chabodmasere/EGH490-Research-Project/EGH490-1 DATA/README.md

# EGH490 — Research Project 2  
**Honours Research Project**  
Queensland University of Technology (QUT)  
Supervised by Dr Jacob Coetzee  

---

## Overview

This repository contains the research, analysis, modelling, and documentation developed for **EGH490-2 Research Project 2**, completed in partial fulfilment of the requirements for the Bachelor of Engineering (Honours).

The project extends the foundations established in EGH490-1 and advances the analytical depth, modelling precision, and technical validation of the proposed system.

The work reflects a complete engineering research cycle:

- Problem formulation  
- Literature review  
- Analytical modelling  
- Numerical simulation  
- Design iteration  
- Validation and verification  
- Final report preparation  

---

## Research Focus

The project investigates the design and analysis of a waveguide slot array antenna, with emphasis on:

- Electromagnetic field behaviour within rectangular waveguides  
- Slot positioning and excitation characteristics  
- Array synthesis and radiation pattern optimisation  
- Gain, directivity, and efficiency analysis  
- Structural feasibility and manufacturing considerations  

---

## Repository Structure

/report          → Final submitted report (PDF and LaTeX source)  
/analysis        → Mathematical derivations and theoretical modelling  
/simulations     → Electromagnetic simulation files and results  
/design          → CAD models and mechanical drawings  
/figures         → Generated plots and technical diagrams  
/literature      → Key references and annotated notes  
/raw-research    → Working documents and intermediate drafts  

---

## Technical Scope

The repository includes:

- Waveguide mode analysis  
- Slot coupling theory  
- Array factor derivation  
- Radiation pattern modelling  
- Impedance considerations  
- Numerical validation against analytical predictions  

All modelling assumptions and boundary conditions are documented where applicable.

---

## Methodology

The research follows a structured engineering approach:

1. Analytical derivation of waveguide field distributions  
2. Application of array theory for radiation synthesis  
3. Numerical simulation and parameter optimisation  
4. Structural evaluation for manufacturability  
5. Performance validation against theoretical expectations  

---

## Academic Context

Unit: EGH490-2 Research Project 2  
Institution: Queensland University of Technology  
Supervisor: Dr Jacob Coetzee  

This repository contains both final deliverables and supporting research material generated during the course of the project.
