chabodmasere/EGH490-Research-Project/Honours_Submission.pdf

## Investigation into the Effectiveness of Arrays of Slots Radiating through Truncated Waveguides to Combat the Formation of Second-Order Lobes

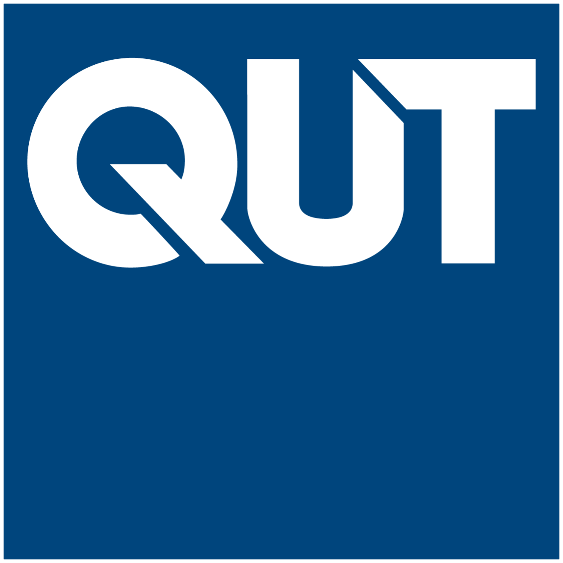
[picture p15: figure]

## EGH490 FINAL DELIVERY

Submitted to the

## School of Electrical Engineering & Robotics

Queensland University of Technology

For the degree of

## BACHELOR OF ENGINEERING

in

## ELECTRICAL & AEROSPACE

Submitted by

# Chabod Masere

Supervised by

## Dr Jacob Coetzee

May 2026

## Acknowledgements

I would like to express my sincere gratitude to my supervisor, Dr Jacob Coetzee, for his guidance, technical insight, and support throughout this research project. His direction helped shape the development of this work, from the early single-slot modelling stage through to the final truncated slotted waveguide array implementation.

I also acknowledge the School of Electrical Engineering and Robotics at Queensland University of Technology for providing the academic environment, software access, and technical resources required to complete this project. The use of CST Studio Suite and related engineering tools was essential to the simulation, modelling, and analysis carried out in this research.

Finally, I would like to thank my family, peers, and colleagues for their encouragement throughout this project. Their support was valuable during the challenges of simulation, design refinement, prototyping, and report preparation.

Chabod Masere

## Investigation into the Effectiveness of Arrays of Slots Radiating through Truncated Waveguides to Combat the Formation of Second-Order Lobes

Chabod Masere¹

1School of Electrical Engineering and Robotics, QUT

Abstract– This research investigates the effectiveness of truncated slotted waveguide arrays for suppressing unwanted second-order lobes in the far-field radiation pattern. A single-slot CST model was first developed and evaluated using a 23 × 21 parametric sweep over cavity-slot offset and cavity-slot length, producing 483 simulation cases. The extracted response was then used to generate a truncated 6 × 6 slotted waveguide array with controlled, non-uniform slot geometry. A target sidelobe level of −25 dB was set. The final CST model achieved a sidelobe level of approximately −23.2 dB at 9 GHz, with the main lobe directed at ϕ = 90◦
and a 3 dB angular width of 14.2

◦
. Although the result remained 1.8 dB above the target, it demonstrated meaningful sidelobe suppression and validated the proposed approach as a preliminary optimisation method for truncated slotted waveguide arrays.

Index Terms– Slotted waveguide arrays; truncated waveguides; second-order lobe suppression; sidelobe reduction; far-field directivity; slot admittance; aperture excitation; antenna array design.

## I. INTRODUCTION

T

he formation of second-order lobes is a significant challenge in the design of slotted waveguide arrays, particularly in applications requiring high directivity, efficient aperture radiation, and controlled far-field behaviour. Slotted waveguide array antennas are widely used in radar, communication, and remotesensing systems because they offer high gain, low transmission loss, strong power-handling capability, and mechanically robust aperture structures [3,4]. In these antennas, electromagnetic energy propagates through the waveguide and is radiated through a sequence of carefully positioned slots. The location, length, offset, and excitation of these slots determine how the radiated fields combine in the far field.

Ideally, the slot contributions combine constructively in the desired main-beam direction while remaining suppressed elsewhere. However, unwanted spatial harmonics can arise when the slot spacing, excitation phase, or guided-wave propagation characteristics are not adequately controlled. These harmonics may produce secondary radiation maxima away from the main beam, referred to in this work as second-order lobes. Their presence degrades radiation-pattern quality by redistributing radiated power away from the intended direction and increasing off-axis radiation. This behaviour is related to the broader arrayantenna problem of unwanted spatial radiation modes, where periodic spacing and phase progression can generate additional lobes within the visible region of the radiation pattern [5].

The problem becomes more difficult in truncated slotted waveguide arrays because the finite aperture length and limited number of radiating elements introduce edge effects and modify the aperture-field distribution. These effects can increase sidelobe and higher-order lobe levels if the slot geometry, slot offset, slot spacing, and excitation distribution are not carefully controlled. For radar and aerospace communication systems, this can reduce directivity, aperture efficiency, angular discrimination, and directional signal reliability [6, 7].

This research investigates the use of truncated waveguide slot geometry as a method for suppressing second-order lobes in a slotted waveguide array. The work focuses on controlling the cavity-slot offset and cavity-slot length through single-slot self-admittance analysis, spline-based array synthesis, and full 6 × 6 CST verification. The aim is to reduce unwanted secondary radiation while preserving a dominant main beam and maintaining practical waveguide-array performance.

Honours Research Project | Semester 1, 2026 | © QUT | 2

## II. SECOND-ORDER LOBES

Before discussing second-order lobes directly, it is useful to define the main features of an antenna radiation pattern. As shown in Fig. 1, the main lobe is the dominant radiation region and represents the intended direction of maximum radiated power. The beamwidth describes the angular spread of this main beam, commonly measured between the half-power points. Side lobes are smaller radiation maxima that occur away from the main lobe, while nulls are angular regions where the radiated field is strongly reduced [1, 2].

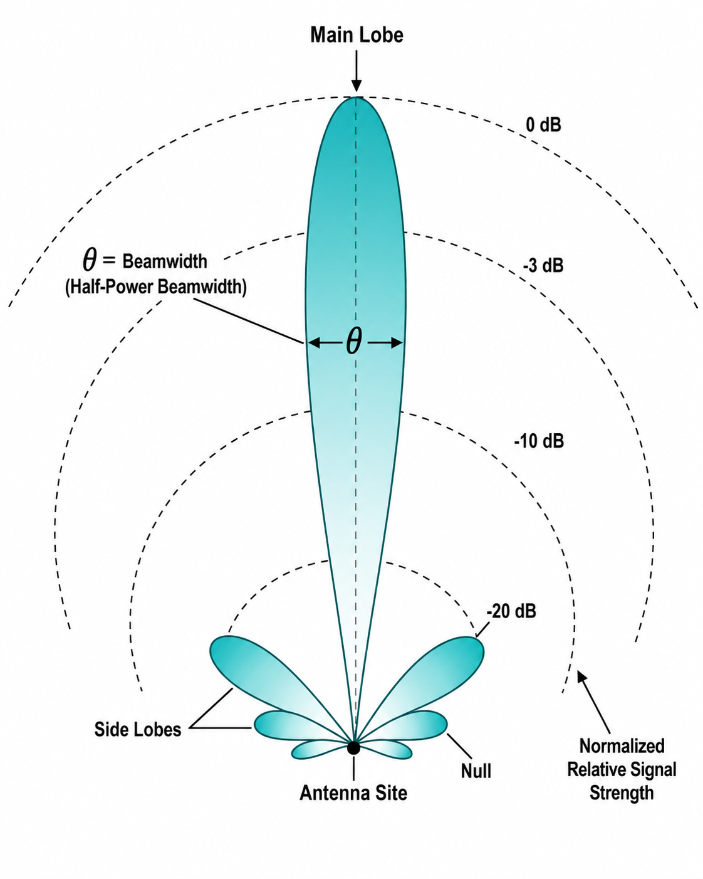
[picture p16: figure]

Figure 1. General antenna radiation-pattern terminology showing the main lobe, beamwidth, side lobes, and nulls. These features provide the basis for interpreting unwanted second-order lobes in slotted waveguide arrays.

Second-order lobes are unwanted secondary radiation maxima that appear away from the intended main beam of an antenna array. In slotted waveguide arrays, these lobes can form when the slot spacing, guided-wave phase progression, or aperture excitation distribution permits higher-order spatial harmonics to radiate. Although the main beam carries the desired radiated energy, second-order lobes redirect part of the radiated power into unintended angular regions. This reduces pattern cleanliness and can degrade directivity, gain, aperture efficiency, and radiation control [3, 4].

From an antenna-design perspective, the presence of second-order lobes is undesirable because the array no longer radiates predominantly in the intended direction. Instead, part of the energy is distributed into off-axis lobes, which can produce false angular responses, increase interference, and reduce the effectiveness of the radiating aperture. In array antennas, unwanted lobes are closely related to the spatial sampling of the aperture, the element spacing, and the phase progression across the array [1,5]. In applications such as radar, wireless communications, telemetry, and electronic warfare, unwanted radiation maxima can compromise system performance because energy is transmitted or received in directions outside the intended coverage region [2, 6].

The second-order lobe problem is illustrated in Fig. 2 and Fig. 3. In Fig. 2, the radiation surface contains a dominant main beam together with multiple irregular off-axis lobes distributed across the visible region. This type of pattern shows how a poorly controlled aperture response can scatter energy into several unintended directions. The surrounding lobes are not part of the desired main-beam radiation and therefore represent unwanted radiation components.

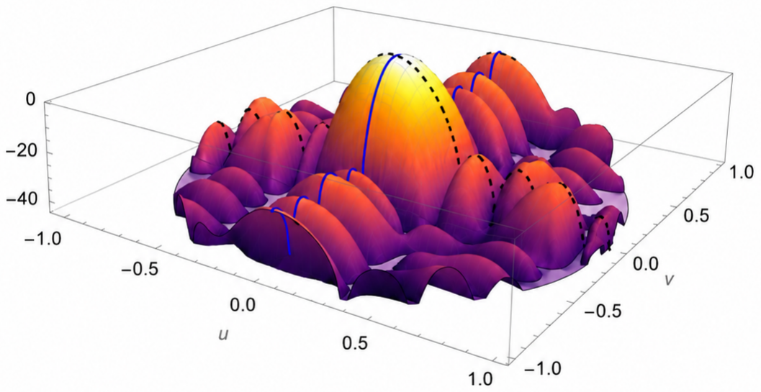
[picture p17: figure]

Figure 2. Illustrative three-dimensional radiation pattern showing a dominant main beam accompanied by multiple irregular off-axis lobes; secondary radiation maxima can distribute energy into unintended directions.

Figure 3 shows a more regular lobe structure. In this case, the main beam remains dominant, but repeated secondary maxima are visible around the main radiation region. These repeated lobes indicate that the array is radiating through additional angular channels instead of concentrating energy only into the intended beam. Even when these lobes are lower than the main beam, they are still undesirable because they reduce the usable radiation efficiency of the aperture and can contribute to interference or false directional responses [1, 5].

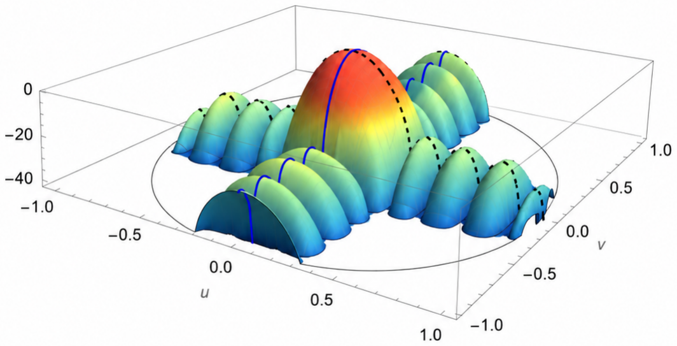
[picture p18: figure]

Figure 3. Illustrative three-dimensional radiation pattern showing a dominant main beam with a more regular secondary-lobe structure. Although the main beam remains strongest, repeated off-axis lobes are still present and represent unwanted radiation.

The key design objective is therefore not only to maintain a strong main beam, but also to reduce the strength of the surrounding second-order lobes. In a slotted waveguide array, this can be approached by controlling the slot geometry across the aperture rather than using a purely uniform slot arrangement. By varying the slot offset and slot length, the local coupling strength and phase contribution of each radiating element can be adjusted. This allows the aperture excitation to be shaped more deliberately, which provides a basis for reducing unwanted lobe formation [4, 7].

In this research, the second-order lobe problem is addressed using a truncated-waveguide slot array. The single-slot model is first analysed to determine how the cavity-slot offset, x

cav, and cavity-slot length, L

cav, influence the local radiating behaviour. The extracted self-admittance data are then used as a lookup basis for generating the full 6 × 6 array. Through spline interpolation and centreline mapping, each slot is assigned an element-specific offset and length. This process enables a controlled, non-uniform slot distribution intended to suppress unwanted second-order lobes while preserving the dominant main beam.

## III. INITIAL SINGLE-SLOT WAVEGUIDE MODEL

The first stage of the research used the CST Studio Suite as the full-wave electromagnetic simulation platform. CST was used to construct the waveguide geometry, assign material regions, define the cavity and slot parameters, configure the waveguide excitation, simulate the electromagnetic field behaviour, and extract the far-field radiation patterns. This provided a consistent environment for studying how the waveguide and slot geometry influenced side-lobe behaviour and second-order lobe formation.

The study began with a simplified single-slot rectangular waveguide model, then progressed to the final truncated 6 × 6 slotted waveguide array. The single-slot model was used to examine the radiation behaviour of an individual slot under controlled conditions before introducing array-level effects such as repeated slot placement, aperture truncation, mutual coupling, and higher-order lobe formation. This stage included the baseline waveguide, truncated cavity, cavity slot, vacuum assignment, curve refinement, and waveguide excitations at both ends of the model.

a. Design Parameters
The operating frequency was set to 9 GHz, which lies within the X-band. This frequency was used to define the electromagnetic length scales of the single-slot waveguide model. The corresponding free-space wavelength was calculated as

λ0 =

c
f
, | (1)

where c = 3.00×10⁸ m/s and f = 9.00×10⁹ Hz. Substituting these values gives

λ0 =

3.00 × 10⁸
9.00 × 10⁹

= 0.03333 m = 33.33 mm. (2)

However, because the field propagates inside a rectangular waveguide, the guided wavelength of the dominant TE10 mode was used as the main longitudinal design reference. In CST, this was defined as

λ10 =

1000
f

0.2997924582
−

500
a

2

1/2

, (3)

where f is entered in GHz and the broad-wall waveguide dimension a is entered in millimetres. For f = 9 GHz and a = 22.86 mm,

λ10 =

1000
h
9

0.299792458 2
−

500

22.86 2

i1/2

= 48.63 mm.

(4)
The initial waveguide length was therefore set equal to the guided wavelength:
ℓ = λ10 = 48.63 mm. | (5)

The wave impedance parameter used in the CST model was calculated from

Zwave = f(1.256637)λ10. | (6)
Zwave = 9(1.256637)(48.63) = 550.0 Ω. | (7)

The analytical CST parameters used to define the model are summarised in Table 1, while the corresponding physical geometry dimensions are listed in Table 2.
b. Waveguide Overview
The single-slot model was constructed as a rectangular waveguide section with a central radiating slot and truncated cavity region. The physical waveguide body had an overall length of 48.63 mm, width of 45.72 mm, and height of 17.70 mm. The feeding mouth retained the standard rectangular waveguide aperture dimensions of 22.86 mm×10.16 mm, corresponding to the broad-wall and narrow-wall dimensions of the X-band waveguide.

A truncated cavity was positioned above the waveguide wall to control the local slot-cavity coupling behaviour. This cavity had a length of 18 mm, width of 12 mm, and depth of 5 mm. The cavity slot was defined with a length of 16 mm, width of 1.588 mm, and depth of 1.27 mm, matching the wall thickness of the waveguide. These physical dimensions are listed in Table 2.

Table 1

CST parameters used for the initial

single-slot rectangular waveguide model.

Parameter | Symbol | Value
Operating frequency | f | 9.0 GHz
Waveguide width | a | 22.86 mm
Waveguide height | b | 10.16 mm
Wall thickness | t | 1.27 mm
Slot width | w | 1.5875 mm
Side length | side | 22.86 mm
Guide wavelength | λ10 | 48.6303 mm
Waveguide length | ℓ | 48.6303 mm
Slot displacement | δ | 0 mm
Adjusted length | ℓδ | 48.6303 mm
Overall model width | width | 45.72 mm
Wave impedance | Zwave | 549.995 Ω
Cavity width | acavity | 12 mm
Cavity height | bcavity | 5 mm
Cavity depth | dcavity | 18 mm
Cavity slot length | Lcav | 16 mm
Cavity slot offset | Xcav | 2 mm

Table 2

Physical geometry dimensions of the

single-slot CST model.

Parameter | Symbol | Value
Physical waveguide length | Lwg | 48.63 mm
Physical waveguide width | Wwg | 45.72 mm
Physical waveguide height | Hwg | 17.70 mm
Feeding mouth length | Lfeed | 22.86 mm
Feeding mouth width | Wfeed | 10.16 mm
Truncated cavity length | Ltcav | 18 mm
Truncated cavity width | Wtcav | 12 mm
Truncated cavity depth | Dtcav | 5 mm
Cavity slot length | Lslot | 16 mm
Cavity slot width | Wslot | 1.588 mm
Cavity slot depth | Dslot | 1.27 mm

The baseline CST single-slot model is shown in Fig. 4. This model consisted of a rectangular waveguide section containing one cavity-backed radiating slot. The broad-wall dimension a and narrow-wall dimension b defined the internal waveguide cross-section, while the wall thickness t defined the metallic boundary. The slot width w, cavity slot length Lcav, and cavity slot offset Xcav defined the initial radiating aperture geometry.

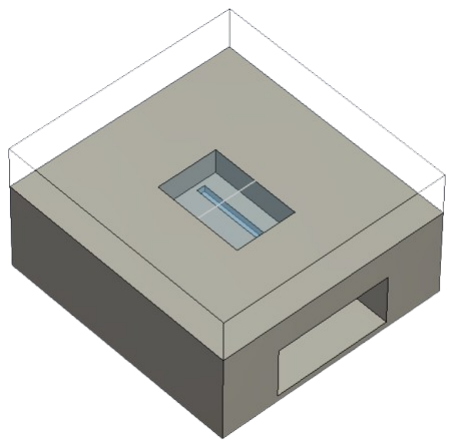
[picture p19: figure]

Figure 4. CST model of the initial single-slot rectangular waveguide geometry used as the baseline configuration before development of the truncated 6 × 6 slotted waveguide array.

c. Vacuum Region Assignment
The truncated region in the single-slot model was assigned as a vacuum in CST, as shown in Fig. 5. This was necessary because the cavity represents the internal electromagnetic volume through which the guided wave interacts with the slot aperture. If this region were treated as metal, the slot would not support the intended field penetration or radiation mechanism. By treating the cavity as a vacuum, the model approximated an air-filled slot cavity, allowing electromagnetic fields to occupy the cavity volume, couple through the aperture, and radiate from the waveguide structure.

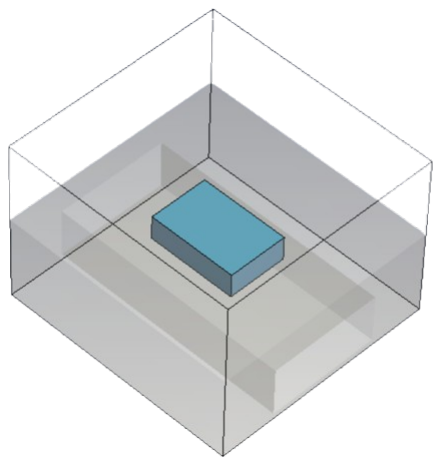
[picture p20: figure]

Figure 5. CST model showing the cavity region assigned as vacuum within the initial single-slot waveguide geometry. The vacuum assignment allowed electromagnetic fields to occupy the cavity volume and couple through the slot aperture during simulation.

d. Curve References
The slot and cavity geometry were defined using two reference curves, as shown in Fig. 6. Curve 1 and Curve 2 represent the slot-side and cavity-side boundaries of the single-slot structure. To examine the local coupling behaviour, the x-component of the electric field, Ex, was evaluated along both curves at f = 9 GHz.
Since the CST field result is complex in the frequency domain, both the real and imaginary components of Ex were extracted. The curve result was interpreted as the line-integrated electric-field response,

IEx =

Z

C

Ex dl, | (8)

where IEx

represents the accumulated electric-field excitation along the selected curve. This provided a compact measure of the relative field strength and phase behaviour between the slot and cavity regions.

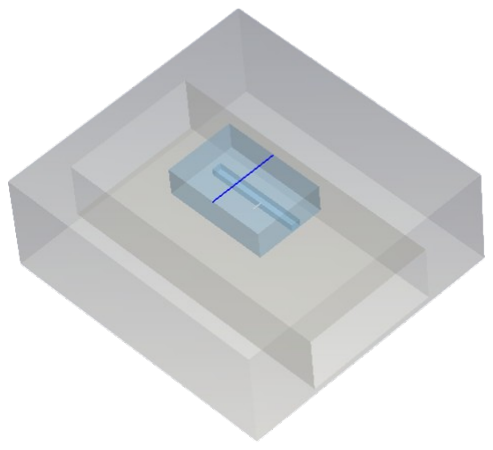
[picture p21: figure]

Figure 6. CST geometry showing Curve 1 and Curve 2 used for single-slot field evaluation. The x-component of the electric field, Ex, was evaluated along both curves at f = 9 GHz.

This analysis was used to assess how effectively the cavity region couples energy into the radiating slot aperture. Poorly controlled slot-cavity coupling can produce uneven aperture excitation, which may contribute to increased sidelobe levels when extended to the full 6 × 6 array. The curve-based field evaluation therefore provided a baseline measure of the local radiation mechanism before the design was implemented at array scale.

e. Port Excitation Setup
Waveguide ports were assigned at both ends of the single-slot model to excite the dominant guided mode through the rectangular waveguide. Each port was referenced from its respective end face and extended inward toward the centre of the structure. In CST, this was implemented using an inward extent of −ℓ/2, where ℓ is the total waveguide length. Since the initial waveguide length was defined as ℓ = λ10, each port used an inward extent of −λ10/2. This kept the slot region centred while allowing the guided excitation to enter from the waveguide end faces.

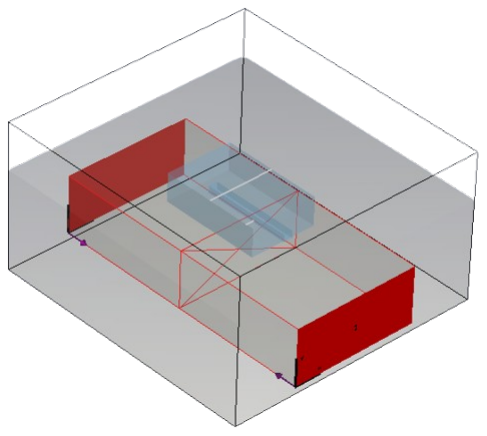
[picture p22: figure]

Figure 7. Waveguide port-pin placement used in the CST single-slot model. Each port was defined with an inward extent of −ℓ/2 from its respective end face.

This port arrangement ensured that the slot was excited by the propagating waveguide mode rather than by a direct aperture excitation. This better represents the excitation condition used later in the full slotted waveguide array.

f. Parametric Sweep Definition
A parametric sweep was conducted to evaluate how the cavity-slot offset and cavity-slot length affected the single-slot electromagnetic response. Two geometric variables were swept: the cavity-slot offset, Xcav, and the cavity-slot length, Lcav. These parameters were selected because they directly influence the slot-cavity coupling strength, aperture excitation, and radiation behaviour.
The offset Xcav was varied from 0.6 mm to 5.0 mm in increments of 0.2 mm, giving 23 offset values. The cavity-slot length Lcav was varied from 15.0 mm to 17.0 mm in increments of 0.1 mm, giving 21 length values. The full sweep therefore produced
Nsweep = 23 × 21 = 483 | (9)

individual simulation cases.

Table 3

Parametric sweep ranges used for the

single-slot CST model.

Parameter | Symbol | Range | Step
Cavity-slot offset | Xcav | 0.6–5.0 mm | 0.2 mm
Cavity-slot length | Lcav | 15.0–17.0 mm 0.1 mm

This sweep allowed the relationship between slot offset, cavity-slot length, and electromagnetic coupling behaviour to be examined systematically. Each value of Xcav was simulated across the full range of Lcav, producing a two-dimensional parameter space. The resulting 483 cases were then used to identify suitable geometry regions before extending the design to the truncated 6 × 6 slotted waveguide array.

## IV. SINGLE-SLOT ANALYSIS

a. Sweep Dataset Compilation
For each geometry in the CST parametric sweep, the complex scattering parameters S11 and S21 were exported using their real and imaginary components. The reflection coefficient, S11, was used to assess input-port reflection, while the transmission coefficient, S21, was used to assess power transfer through the single-slot waveguide model. These quantities were represented as
S11 = Re(S11) + j Im(S11), | (10)
S21 = Re(S21) + j Im(S21). | (11)

The corresponding magnitudes were calculated using

|S11| =

p
Re(S11)

2 + Im(S11)

2, (12)

|S21| =

p
Re(S21)

2 + Im(S21)

2. (13)

The compiled dataset also included impedance and admittance-derived quantities, including Z11, Z12, Rself, Xself, Gself, and Bself. These values were used to interpret the equivalent electromagnetic loading introduced by each slot geometry. In particular, Gself and Bself were used to identify regions of strong slot excitation and near-resonant behaviour.
In addition to the port-based quantities, CST field-integral results were recorded for Curve 1 and Curve 2. These curves represented the cavity-side and slot-side field-evaluation paths. For each curve, the extracted integral was complex and was expressed as
IC1 = Re(IC1) + j Im(IC1), | (14)
IC2 = Re(IC2) + j Im(IC2). | (15)

The final sweep dataset therefore linked each geometric parameter pair, (x

cav, Lcav), to its corresponding scattering response, equivalent admittance, and local field-integral behaviour. This allowed the relationship between slot geometry, port matching, transmission, self-admittance, and slot-cavity excitation to be examined systematically.
b. Self-Admittance Analysis and Equivalent Circuit
The single-slot response was interpreted using the equivalent two-port transmission-line model shown in Fig. 8. The two CST waveguide ports define the input and output reference planes, while the radiating slot is represented as a normalised shunt self-admittance, Yself. Since both ports were normalised to Z0 = 1, the slot loading could be interpreted directly in terms of normalised admittance.
The self-admittance was expressed as
Yself = Gself + jBself, | (16)

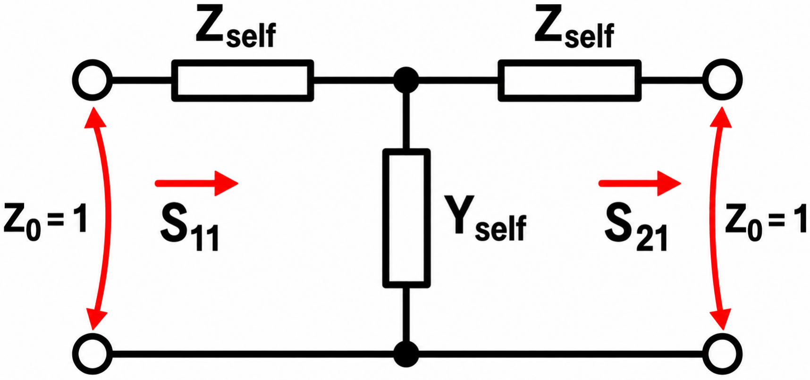
[picture p23: figure]

Figure 8. Equivalent two-port transmission-line representation of the single-slot waveguide model. The radiating slot is modelled as a shunt self-admittance, Yself, extracted from the scattering parameters S11 and S21 using normalised port impedances, Z0 = 1.

where Gself is the self-conductance and Bself is the self-susceptance. The conductance term represents real electromagnetic loading associated with power coupled into the radiating aperture, while the susceptance term represents the reactive component of the slot response.
For the normalised two-port model, the complex self-admittance was calculated from the CST scattering parameters using

Yself =

(1 − S11)

2 − S

2
21
2S21
. | (17)

The real and imaginary components were then extracted as

Gself = Re{Yself}, | (18)
Bself = Im{Yself}. | (19)

For each offset–length combination in the sweep, the exported values of S11 and S21 were substituted into Eq. (17). This produced corresponding values of Yself, Gself, and Bself for every simulated geometry.
The self-conductance, Gself, was used to identify regions where the slot was strongly excited and efficiently coupled energy out of the waveguide. A local maximum in Gself indicates stronger radiating behaviour. The self-susceptance, Bself, was used to assess the resonance condition of the slot. When Bself approaches zero, the reactive component of the slot admittance is minimised, indicating near-resonant behaviour.
The preferred design region was therefore identified by locating parameter combinations where Gself approached a local maximum while Bself remained close to zero. These conditions indicate that the slot is both strongly coupled and approximately resonant, making the corresponding cavity-slot dimensions suitable candidates for extension to the truncated 6 × 6 slotted waveguide array.

c. Single-Slot Self-Admittance Sweep Results
Self-admittance was extracted for each investigated cavity-slot offset in order to evaluate how the single-slot response changed with geometry. For each fixed value of cavity-slot offset, x

cav, the cavity-slot length, L

cav, was swept through its prescribed range. This produced a set of sweep curves showing the variation of self-conductance, Gself, and self-susceptance, Bself, as functions of slot length.

Only representative offset cases are included in the main body to avoid unnecessary repetition. The selected figures show the main electromagnetic trend across the sweep, beginning with weak coupling at small offsets and progressing toward stronger slot excitation at larger offsets. The purpose of the sweep was not simply to locate the maximum value of Gself, but to identify a physically useful region where the conductance was high while the susceptance approached or crossed the zero axis. This condition indicates that the slot was both strongly excited and approximately resonant.

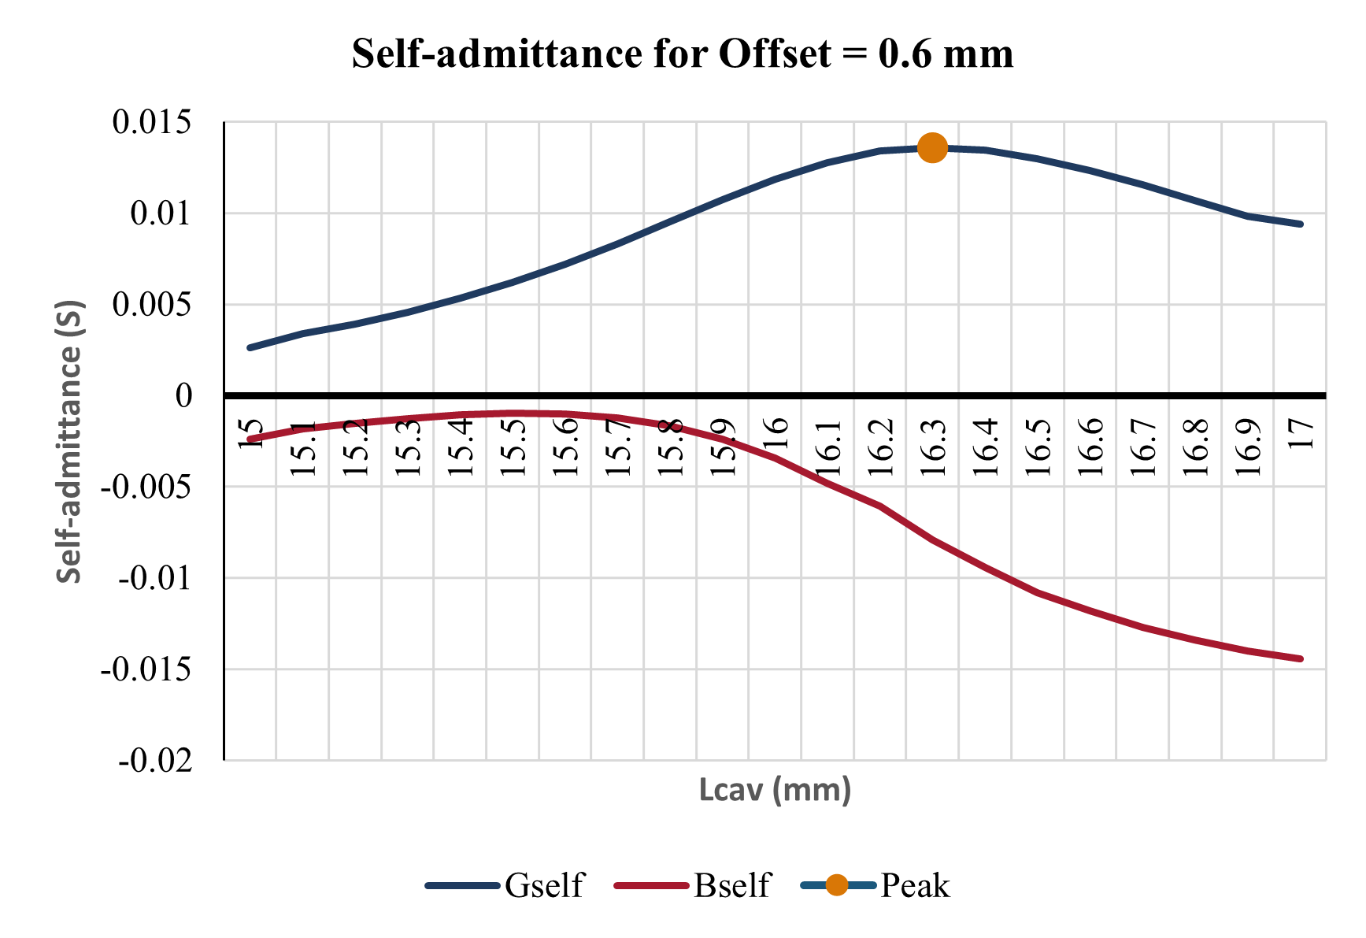
[picture p24: figure]

Figure 9. Self-admittance sweep for x

cav = 0.6 mm.
This low-offset case shows comparatively weak self-conductance, indicating limited coupling between the guided wave and the radiating aperture.

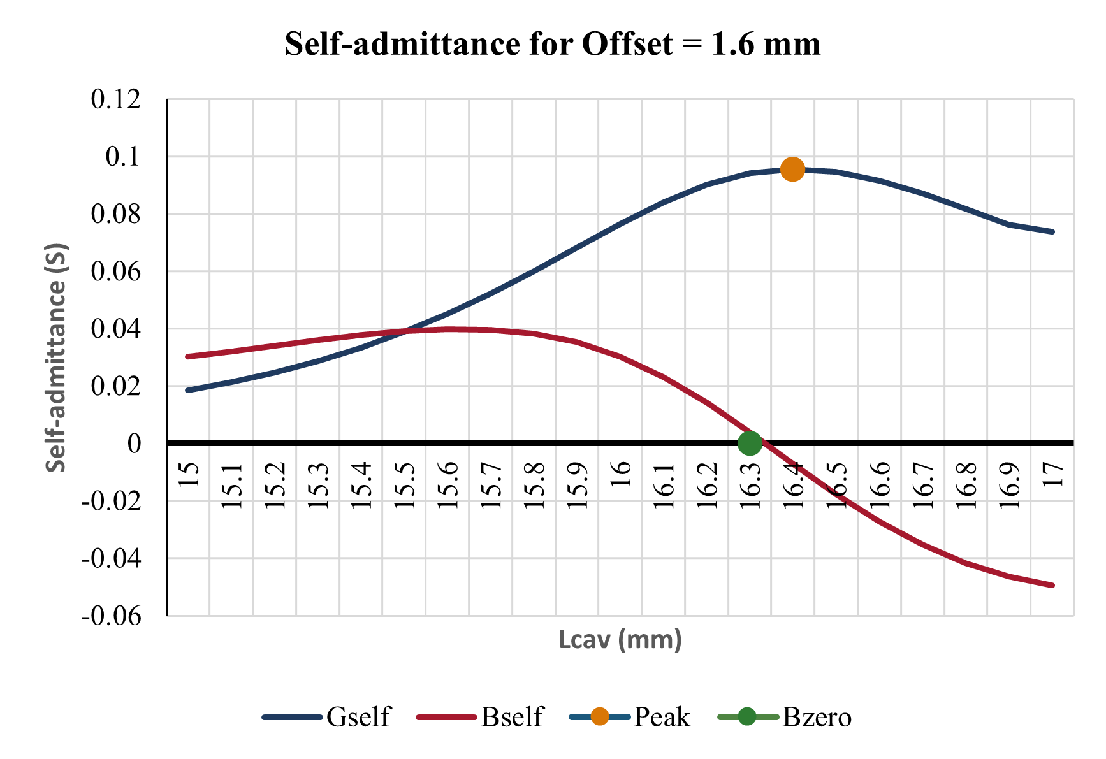
[picture p25: figure]

Figure 10. Self-admittance sweep for x

cav = 1.6 mm.
The increase in Gself relative to the low-offset case shows that the slot becomes more strongly excited as the cavity-slot offset is increased.

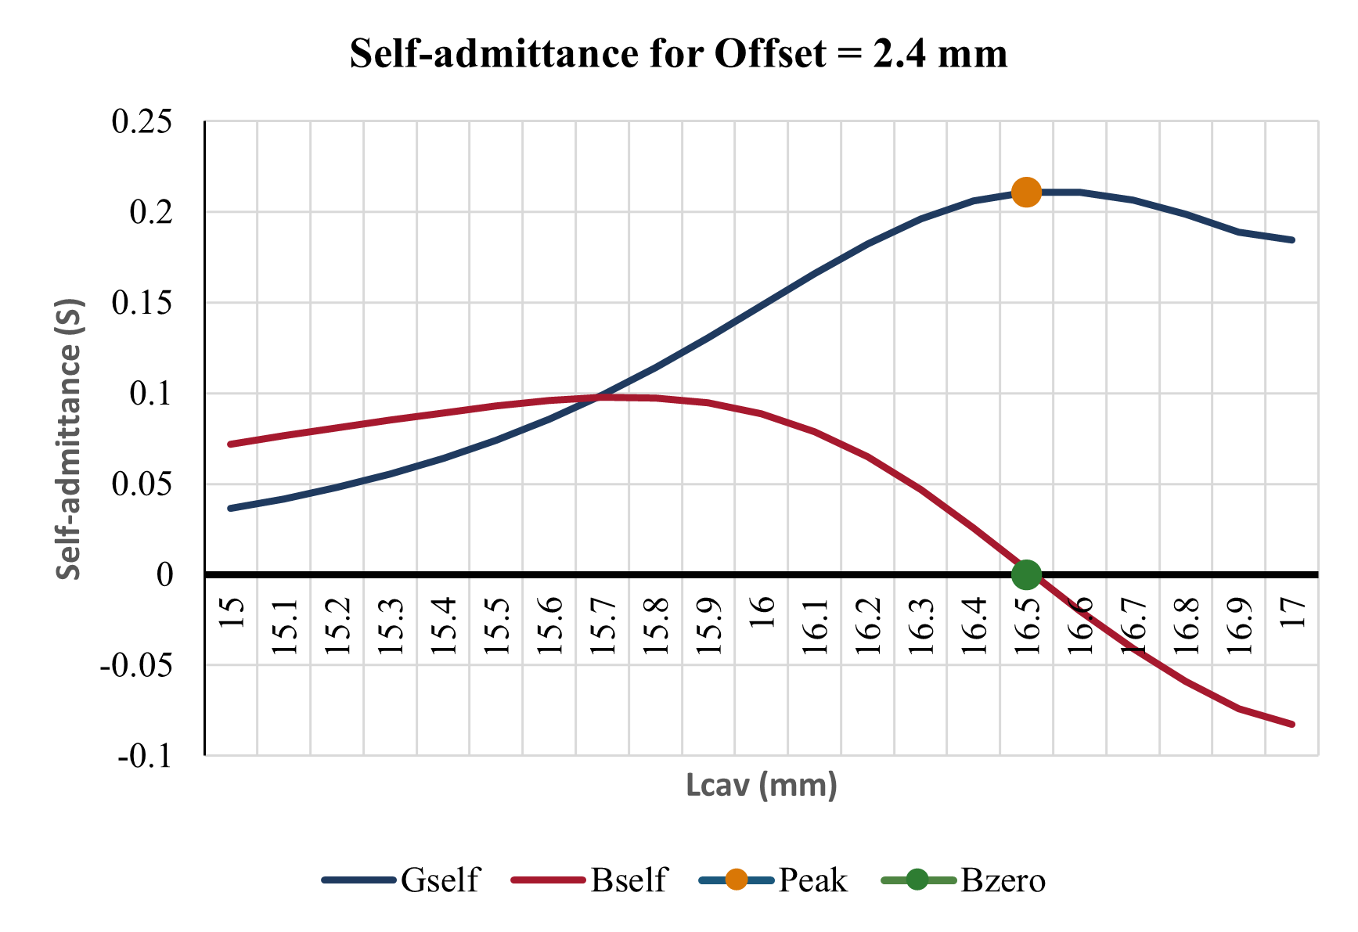
[picture p26: figure]

Figure 11. Self-admittance sweep for x

cav = 2.4 mm.
This intermediate-offset case shows stronger conductance and a clearer transition of Bself through the zero axis.

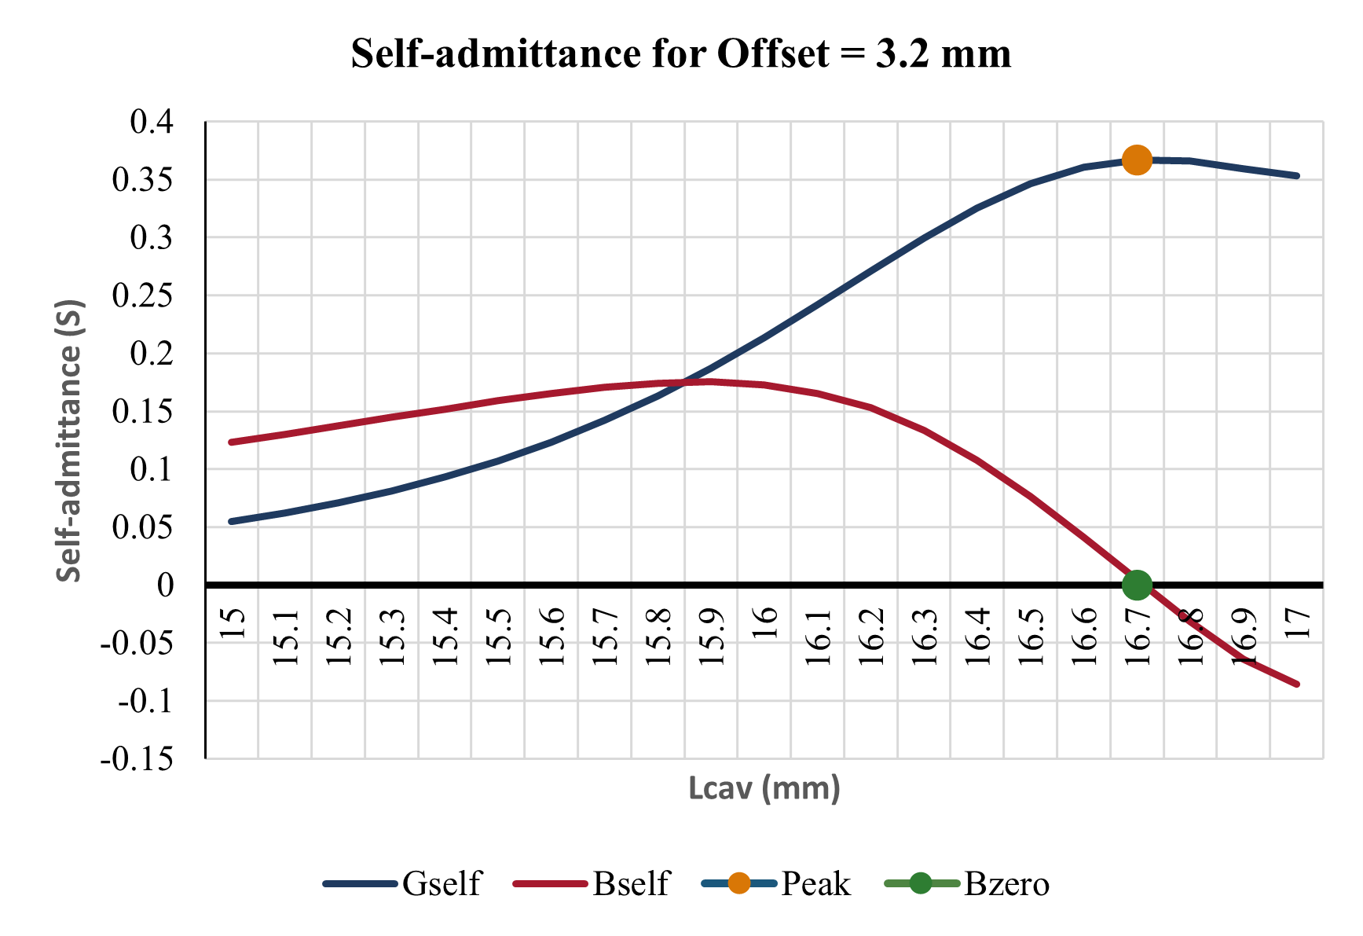
[picture p27: figure]

Figure 12. Self-admittance sweep for x

cav = 3.2 mm.
The response shows further growth in Gself, indicating stronger coupling between the waveguide mode and the slot aperture.

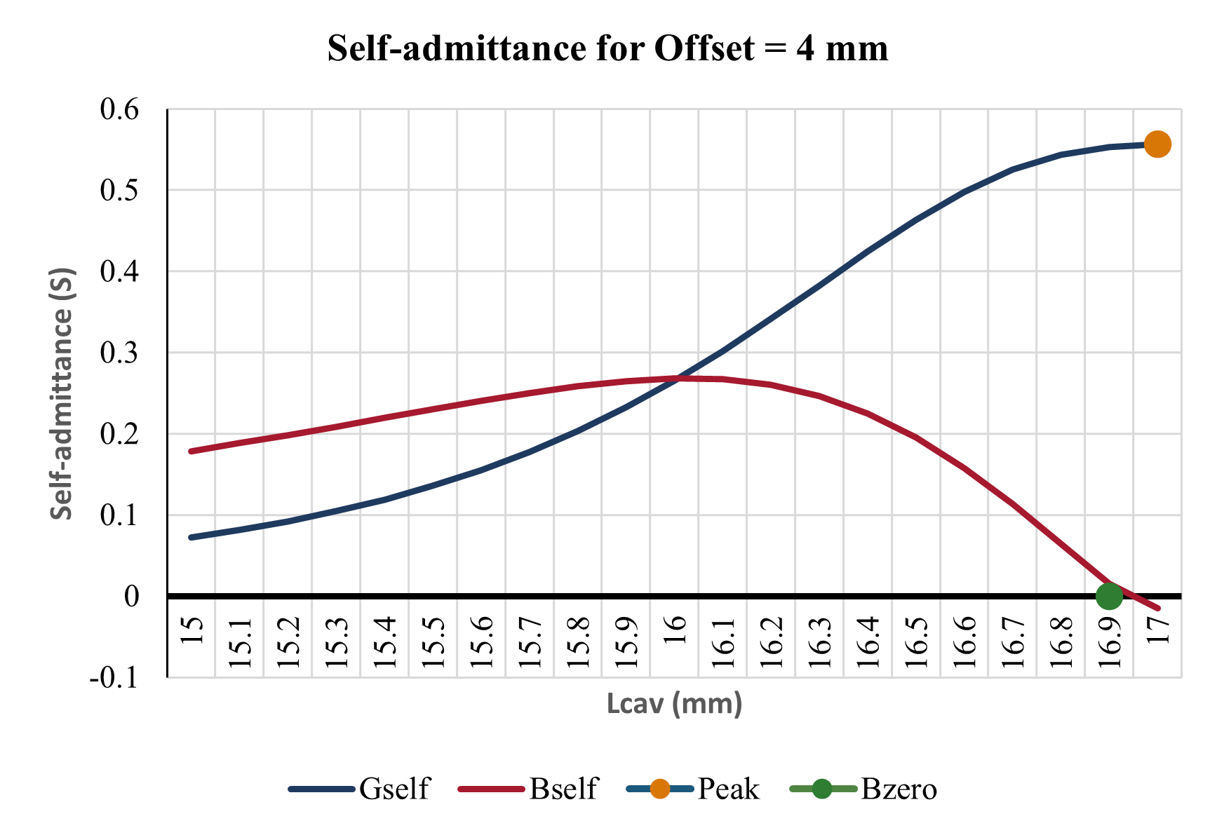
[picture p28: figure]

Figure 13. Self-admittance sweep for x

cav = 4.0 mm.
This case represents a high-coupling region where the peak conductance becomes significantly larger than in the smaller-offset cases.

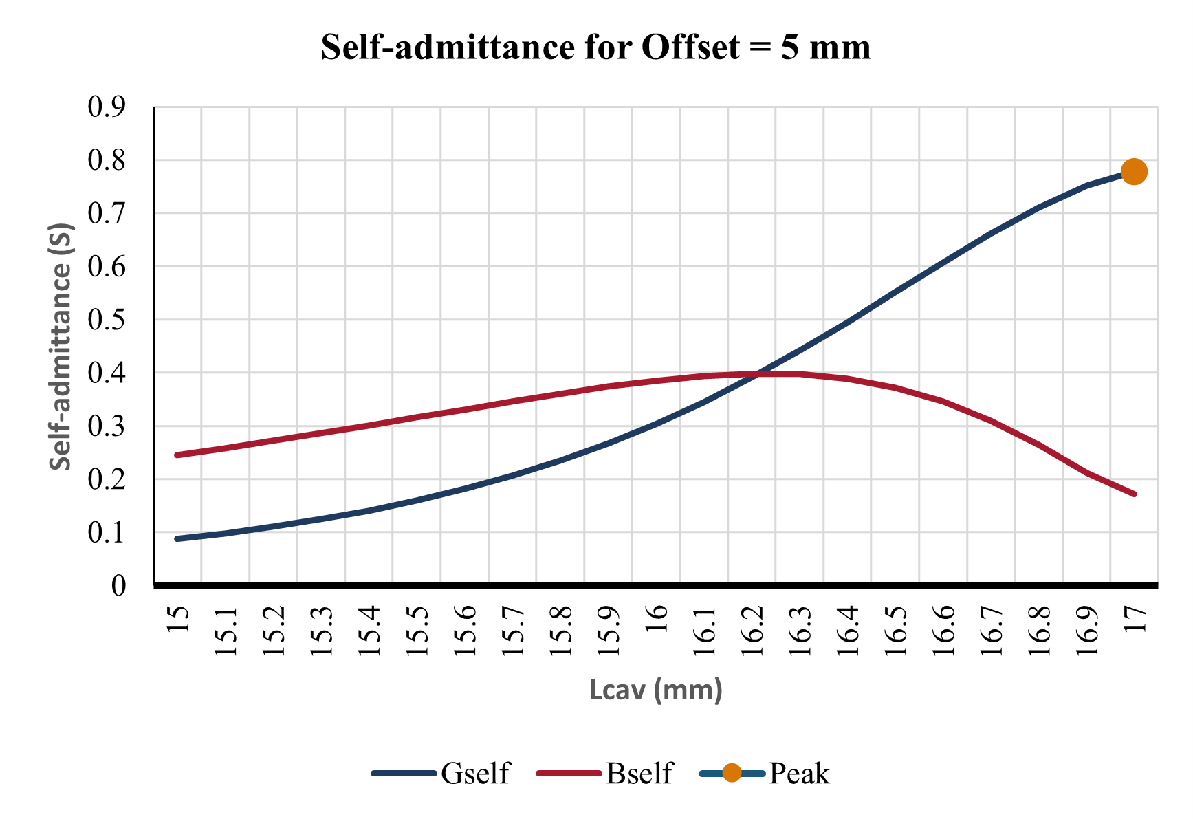
[picture p29: figure]

Figure 14. Self-admittance sweep for x

cav = 5.0 mm.
This upper-offset case was used to assess the high-offset limit of the sweep and determine whether further increases in offset remained useful for design selection.

The representative sweep results in Figs. 9–14 show that increasing x

cav generally increases the peak value of Gself. This trend indicates that larger cavity-slot offsets improve the coupling between the guided wave and the radiating aperture. However, high conductance alone was not sufficient for selecting the final geometry. A large value of Gself only confirms strong coupling; it does not confirm that the slot is operating near resonance.

For this reason, Bself was assessed simultaneously with Gself. The preferred design region was identified where Gself was locally high and Bself was close to zero. This combination indicates that the slot geometry produced strong radiation while minimising reactive loading. The remaining offset sweeps showed similar intermediate behaviour and were therefore retained as verification data rather than repeated in the main body.
d. Spline Interpolation and Centreline Mapping of the Single-Slot Data
The final 6×6 cavity-slot array was generated from the single-slot CST sweep using spline interpolation. The sweep provided discrete data linking cavity-slot offset, x

cav, and cavity-slot length, L

cav, to the
extracted slot response.

Spline interpolation was used because the CST sweep only evaluated finite geometry combinations. This allowed intermediate slot dimensions to be estimated with finer resolution than the original sweep step size.

The interpolation was referenced to the waveguide centreline, defined as x

cav = 0. In the single-slot model, the offset magnitude controlled the coupling strength between the guided mode and the radiating slot.

When the single-slot data were transferred to the full 6 × 6 array, each offset magnitude was obtained from the spline-interpolated dataset. The offset sign was then assigned according to the physical placement of the slot about the centreline.

This produced alternating positive and negative offset values across the array, as shown in Table 4. Mirrored slot locations were assigned equal-magnitude but opposite-sign offsets, preserving geometric symmetry while controlling the excitation of each radiating element.

The interpolation procedure used two mappings. First, the required conductance for each array element was mapped to a cavity-slot offset magnitude. Second, that offset magnitude was mapped to the corresponding cavity-slot length. The complete MAT-LAB implementation is provided in Appendix D.

The resulting table represents an array-synthesis output rather than the repeated use of one globally optimal single-slot geometry. Each element (t, n) was assigned its own cavity-slot offset, x

cav
t,n , and
cavity-slot length, L

cav
t,n .

The coupling-slot angle, θt, and coupling-slot length, lt, were then specified for each slot index to complete the full-array geometry.

Table 4

Cavity slot and coupling slot dimensions.

Element | Cavity slot offset | Cavity slot length
index | x cav
| t,n (mm) | L cav
| | t,n (mm)
1,1 | 1.293 | 16.007
1,2 | -1.925 | 16.156
1,3 | 2.764 | 16.323
1,4 | -2.764 | 16.323
1,5 | 1.925 | 16.156
1,6 | -1.293 | 16.007
2,1 | 1.348 | 15.832
2,2 | -2.084 | 15.961
2,3 | 2.801 | 16.053
2,4 | -2.801 | 16.053
2,5 | 2.084 | 15.961
2,6 | -1.348 | 15.832
3,1 | 1.324 | 15.803
3,2 | -1.848 | 15.912
3,3 | 2.460 | 16.075
3,4 | -2.460 | 16.075
3,5 | 1.848 | 15.912
3,6 | -1.324 | 15.803
4,1 | 1.320 | 15.802
4,2 | -1.840 | 15.911
4,3 | 2.495 | 15.997
4,4 | -2.495 | 15.997
4,5 | 1.840 | 15.911
4,6 | -1.320 | 15.802
5,1 | 1.350 | 15.833
5,2 | -2.088 | 15.961
5,3 | 2.784 | 16.131
5,4 | -2.784 | 16.131
5,5 | 2.088 | 15.961
5,6 | -1.350 | 15.833
6,1 | 1.295 | 16.008
6,2 | -1.932 | 16.157
6,3 | 2.745 | 16.277
6,4 | -2.745 | 16.277
6,5 | 1.932 | 16.157
6,6 | -1.295 | 16.008
Slot | Coupling slot angle | Coupling slot length
index | θt (deg.) | lt (mm)
1 | 6.879 | 15.775
2 | -13.686 | 15.786
3 | 17.060 | 15.792
4 | -17.155 | 15.792
5 | 13.660 | 15.786
6 | -6.858 | 15.775

The values in Table 4 show alternating cavity-slot offset signs across each row. This sign convention represents slot placement on opposite sides of the waveguide centreline.

The offset magnitudes define the local coupling strength, while the cavity-slot lengths maintain the required resonant behaviour for each selected offset. The highlighted central elements correspond to the central aperture region, where slot placement is most critical for symmetry and excitation control.

## V. WAVEGUIDE ARRAY

a. Full 6×6 Array Geometry Implementation After the cavity-slot and coupling-slot dimensions were generated, the complete 6 × 6 array geometry was implemented in CST. The purpose of this stage was to convert the spline-generated dimensional table into a full electromagnetic model that could be simulated and evaluated at array level. This represented the transition from isolated single-slot analysis to a complete aperture structure, where the radiating behaviour is governed not only by the geometry of each individual slot, but also by the collective interaction between all slots in the array.

The final model was constructed as a layered truncated-waveguide structure. The lower layer acted as the base conductive plate, while the upper layers introduced the coupling slots, radiating slots, and cavity-slot apertures. This layered approach allowed each functional part of the antenna to be implemented separately before being combined into the final CST model. The four principal layers are shown in Figs. 15–18.

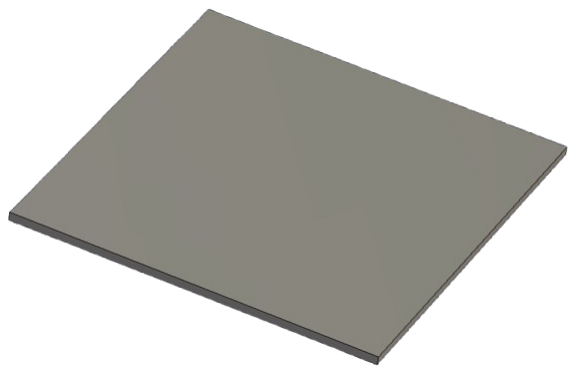
[picture p30: figure]

Figure 15. Base conductive layer used in the full 6 × 6 truncated-waveguide array model. This layer provides the lower structural reference surface for the assembled geometry.

The base layer in Fig. 15 provides the lower conductive boundary of the layered waveguide assembly. Since this layer does not contain slot features, its primary function is to define the lower metallic reference surface and support the closed waveguide structure.

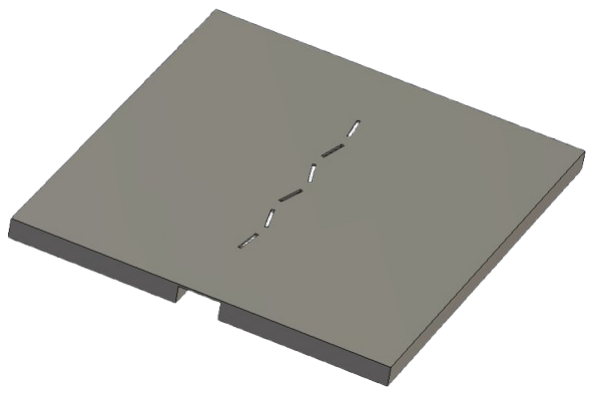
[picture p31: figure]

Figure 16. Coupling-slot layer of the 6 × 6 array. The non-uniform slot positions form the lower excitation distribution used to couple energy from the waveguide into the upper cavity region.

The coupling-slot layer in Fig. 16 introduces the lower excitation features of the array. These slots are not arranged as a simple uniform grid. Instead, their offsets follow the generated design distribution, producing a controlled variation in coupling strength across the aperture. This is important because the coupling slots determine how strongly energy is transferred from the waveguide into the upper cavity-backed radiating region.

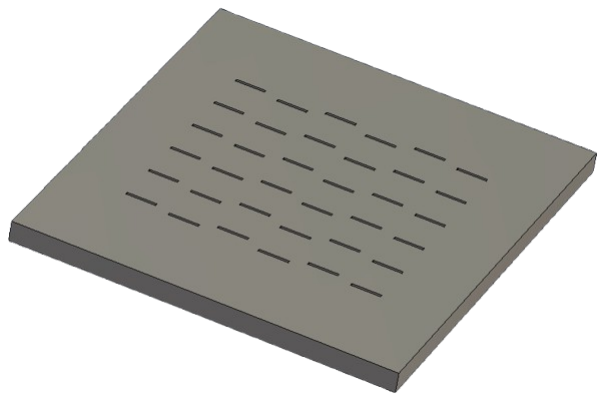
[picture p32: figure]

Figure 17. Radiating slot layer of the full 6 × 6 array. The narrow slots form the upper radiating aperture distribution used to generate the far-field radiation pattern.

The radiating slot layer in Fig. 17 forms the visible 6 × 6 aperture distribution. The slot positions and lengths were implemented from the spline-generated design values, allowing the excitation distribution
to vary across the array rather than being produced
by identical repeated slots. This non-uniformity is central to the project objective, since the aim is to shape the far-field response and suppress unwanted second-order lobes.

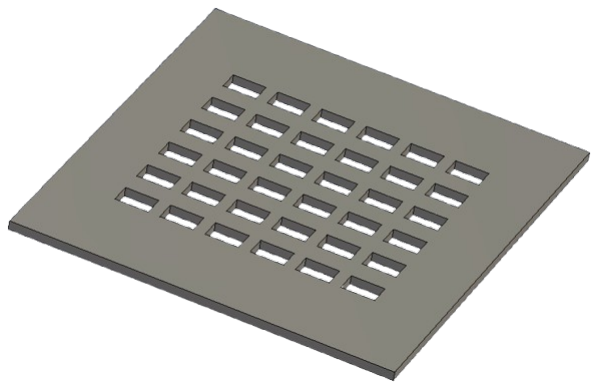
[picture p33: figure]

Figure 18. Cavity-slot layer of the completed 6 × 6 array model. The larger rectangular openings define the cavity-backed aperture regions associated with each radiating element.

The cavity-slot layer in Fig. 18 contains the larger rectangular openings associated with the cavity-backed aperture regions. These cavity features influence the local field distribution, the effective slot admittance, and the phase uniformity across the aperture. In the completed structure, the cavity layer provides an additional degree of electromagnetic control beyond simple slot offset.

A key implementation requirement was maintaining correct alignment between the coupling slots, cavity regions, and radiating slots. The cavity features were kept centred relative to the waveguide structure, while the slot offsets were varied according to the generated dimensional table. This allowed the model to preserve a consistent cavity geometry while using slot displacement as the primary mechanism for modifying local coupling strength. Since slot offset affects the effective admittance of each element, the offset distribution provides a practical method for shaping the excitation profile across the full aperture.

The assembled CST geometry is shown in Figs. 19–
22. These views show the completed array surface, mechanical chassis, conducting boundary assignment, and surrounding simulation domain used for far-field evaluation.

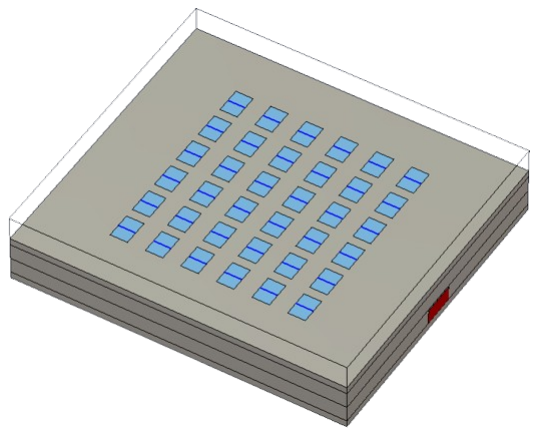
[picture p34: figure]

Figure 19. Completed CST model of the 6 × 6 slotted array showing the radiating apertures on the upper face. The slot positions correspond to the spline-generated cavity-slot dimensions.

Figure 19 shows the completed array surface with the 6 × 6 slot pattern applied to the upper face. The highlighted regions correspond to the radiating slot apertures. These slots were assigned using the element-specific offsets and lengths listed in Table 4. The non-uniform placement confirms that the final array was implemented as a shaped aperture rather than as a uniformly repeated slot pattern.

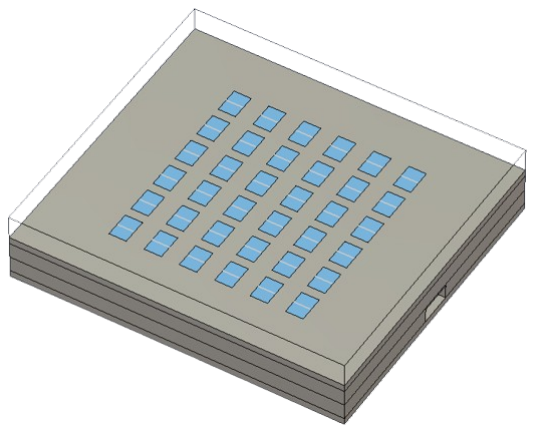
[picture p35: figure]

Figure 20. CST chassis model of the 6 × 6 slotted waveguide array. The chassis defines the physical boundary of the waveguide structure and supports the radiating slot layer.

Figure 20 shows the chassis model used to support the slot layers. The chassis defines the physical waveguide body and establishes the mechanical boundary of the array. This confirms that the slot layers were integrated into a complete truncated-waveguide structure rather than being treated as isolated conducting surfaces.

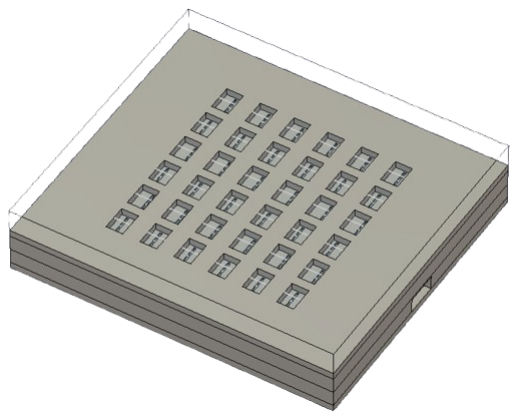
[picture p36: figure]

Figure 21. PEC assignment applied to the 6 × 6 slotted array model. The conducting waveguide body and slot boundaries were treated as ideal metallic surfaces during simulation.

Figure 21 shows the conducting regions after material assignment. The metallic regions were modelled as perfect electric conductor (PEC) boundaries for the electromagnetic simulation. This approximation allowed the waveguide walls and slot boundaries to be treated as ideal conductors, providing a useful first-order model before introducing material loss, surface roughness, or fabrication tolerances.

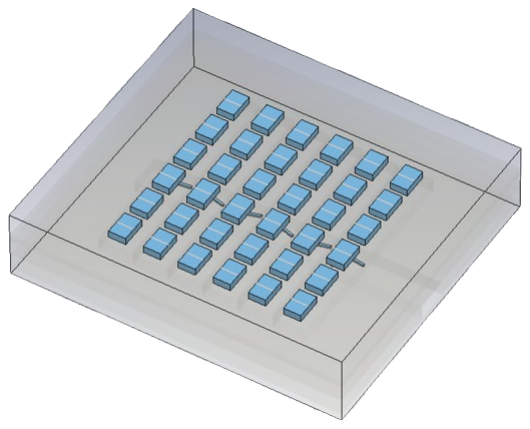
[picture p37: figure]

Figure 22. Vacuum simulation domain surrounding the 6 × 6 slotted array. The external region allows the fields radiated from the apertures to propagate into free space for far-field evaluation.

Figure 22 shows the surrounding vacuum region used to model the radiating environment. This external domain is required so that fields leaving the slot apertures can propagate into free space. The inclusion of this region allowed the far-field directivity pattern and lobe behaviour of the full array to be evaluated after the geometry was assembled.

The completed geometry introduced electromagnetic effects that were not present in the isolated single-slot model. In the single-slot case, the extracted self-admittance provides an estimate of how one slot couples energy from the waveguide into the radiating aperture. In the full array, each slot is influenced by neighbouring elements through mutual coupling inside the waveguide and external coupling through the aperture region. Therefore, the full 6×6 array cannot be interpreted as a direct repetition of the single-slot result. Instead, the CST model captures higher-order interactions, edge effects, cavity loading, and the cumulative impedance presented by the complete aperture to the feeding waveguide.

Before simulation, the completed geometry was visually and dimensionally checked. This included verifying the 6 × 6 slot count, confirming that the slot offsets followed the generated dimensional table, checking that the cavity and coupling-slot layers were correctly aligned, and ensuring that the structure remained electrically continuous where required. These checks were necessary because small geometric errors in slot position, length, or cavity alignment can alter the aperture phase distribution and degrade the far-field response.

Once the full geometry was verified, CST simulations were performed to assess the completed array. The main array-level outputs were S11, Smith chart response, and far-field directivity. These results allowed the input match and radiation behaviour to be evaluated together, confirming whether the final aperture remained reasonably coupled to the feed while producing the intended radiation pat-

tern.
b. Array Equivalent Circuit and Smith Chart Interpretation
After implementation of the complete 6 × 6 array geometry in CST, the array response was interpreted using an equivalent shunt-admittance representation. This model provides a circuit-level interpretation of the electromagnetic loading introduced by the full slot array. While the single-slot study was used to examine the self-admittance of an isolated radiating slot, the complete array was represented by an equivalent array admittance, Yarray, connected across a normalised two-port transmission-line model.

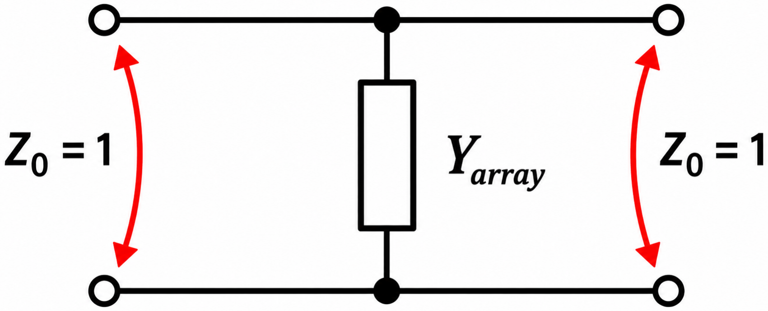
[picture p38: figure]

Figure 23. Equivalent two-port representation of the completed 6 × 6 slotted array. The full slot array is represented as an equivalent shunt admittance, Yarray, connected across a normalised transmission line with Z0 = 1.

In Fig. 23, the two ports represent the input and output reference planes of the CST waveguide model. The reference impedance was normalised such that Z0 = 1, allowing the slot-array loading to be interpreted using normalised impedance and admittance quantities. The central shunt element, Yarray, represents the combined effect of all radiating apertures in the 6 × 6 array. This includes the radiation conductance of the slots, the stored reactive energy associated with the aperture and cavity fields, and the effect of mutual coupling between neighbouring slots.
The equivalent array admittance can be expressed as
Yarray = Garray + jBarray, | (20)

where Garray is the conductance associated with real radiated power and Barray is the susceptance associated with stored electromagnetic energy. A useful array design should provide sufficient conductance for radiation while keeping the reactive component controlled near the operating frequency. If the susceptance is large, the array behaves as a strongly reactive discontinuity and the input match deteriorates.

For a normalised shunt admittance connected across a transmission line, the scattering response can be related to the equivalent admittance by

S11 =

−Yarray

2 + Yarray

, | (21)

and

S21 =

2

2 + Yarray

. | (22)

These expressions show that the reflection coefficient is directly governed by the equivalent admittance presented by the complete slot array. If the equivalent admittance is too small, the array couples weakly and radiates inefficiently. If it is too large or strongly reactive, the array becomes mismatched and produces a larger reflected wave. Therefore, the design objective is to obtain a balanced admittance that radiates effectively while remaining reasonably matched to the feeding waveguide.
The polar plot of S11 is shown in Fig. 24. This plot represents the reflection coefficient trajectory over the swept frequency range from 8.9 GHz to 9.1 GHz. The distance of the curve from the origin corresponds to the reflection magnitude, while the angular position corresponds to the reflection phase. The trajectory does not collapse to the origin, which confirms that the array is not perfectly matched. However, the reflection coefficient remains bounded over the swept range, which is consistent with the moderate return-loss behaviour observed in the rectangular S11 magnitude plot.

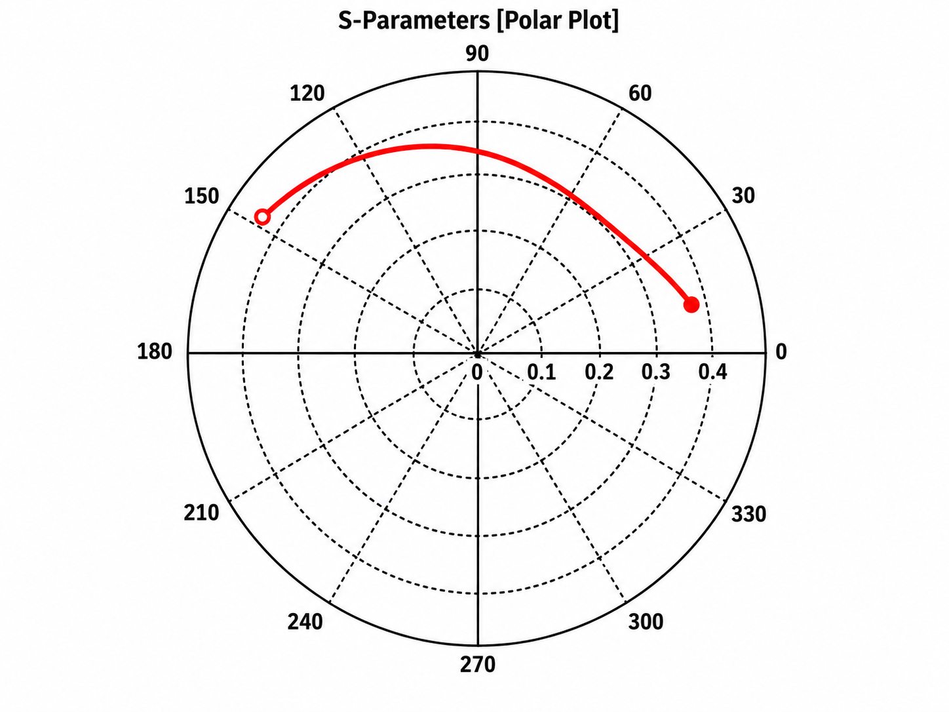
[picture p39: figure]

Figure 24. Polar plot of the simulated S11 response of the completed 6 × 6 slotted array over the frequency range from 8.9 GHz to 9.1 GHz. The curve shows the variation of reflection coefficient magnitude and phase across the swept band.

The impedance Smith chart is shown in Fig. 25. This view converts the reflection coefficient into an equivalent input impedance trajectory. At 8.9 GHz, the indicated input impedance is approximately

Zin ≈ 230 + j134 Ω, | (23)

while at 9.1 GHz it is approximately

Zin ≈ 1.14 × 10³ − j218 Ω. | (24)

These values show that the input impedance varies significantly across the sweep and remains displaced from the ideal matched impedance. The large real component, particularly near the upper end of the sweep, indicates that the array presents a relatively high impedance to the feed. The change in the sign of the imaginary component also indicates that the input response passes through a transition between inductive and capacitive behaviour across the analysed band.

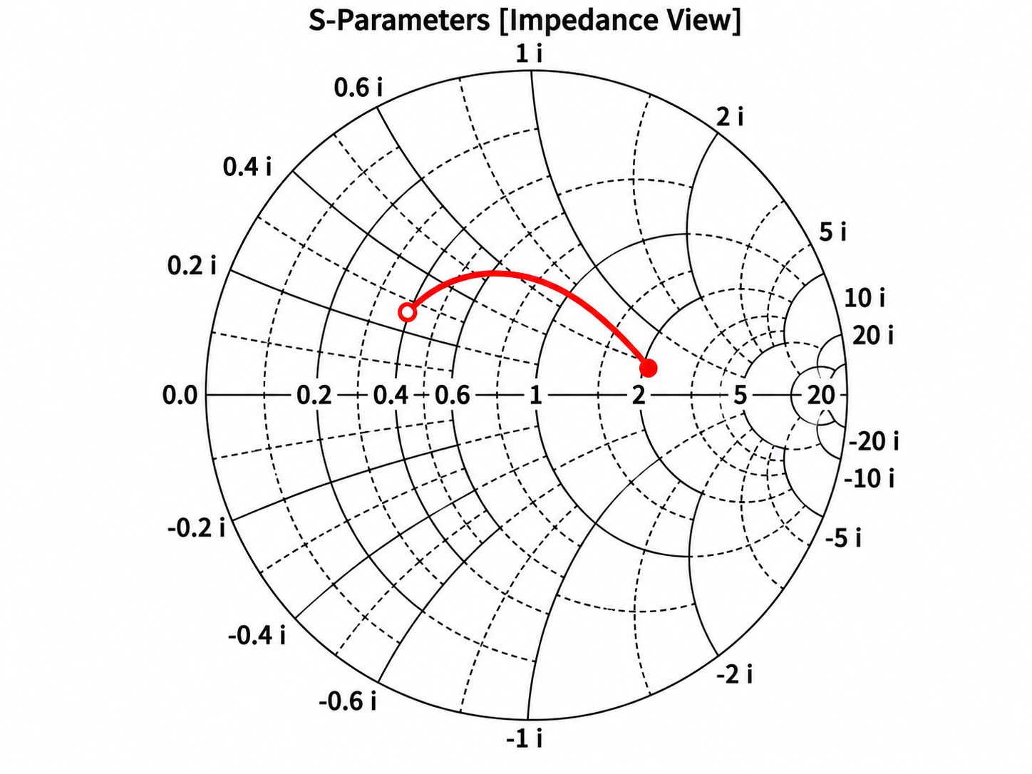
[picture p40: figure]

Figure 25. Smith chart response of the completed 6 × 6 slotted array in impedance view. The curve shows the variation of equivalent input impedance over the swept frequency range.

The same response is shown in admittance form in Fig. 26. This representation is more directly connected to the equivalent circuit in Fig. 23, since the slot array is modelled as a shunt admittance. At 8.9 GHz, the indicated input admittance is approximately

Yin ≈ 0.00325 − j0.00189 S, | (25)

while at 9.1 GHz it is approximately

Yin ≈ 0.000847 + j0.000162 S. | (26)

The real part of the admittance represents the conductance available for power transfer into the array, while the imaginary part represents the residual reactive loading. The reduction in conductance from 8.9 GHz to 9.1 GHz indicates that the effective coupling of the array changes across the sweep. The relatively small imaginary admittance at the upper end of the band suggests that the response becomes less reactive there, although the total conductance is also reduced.

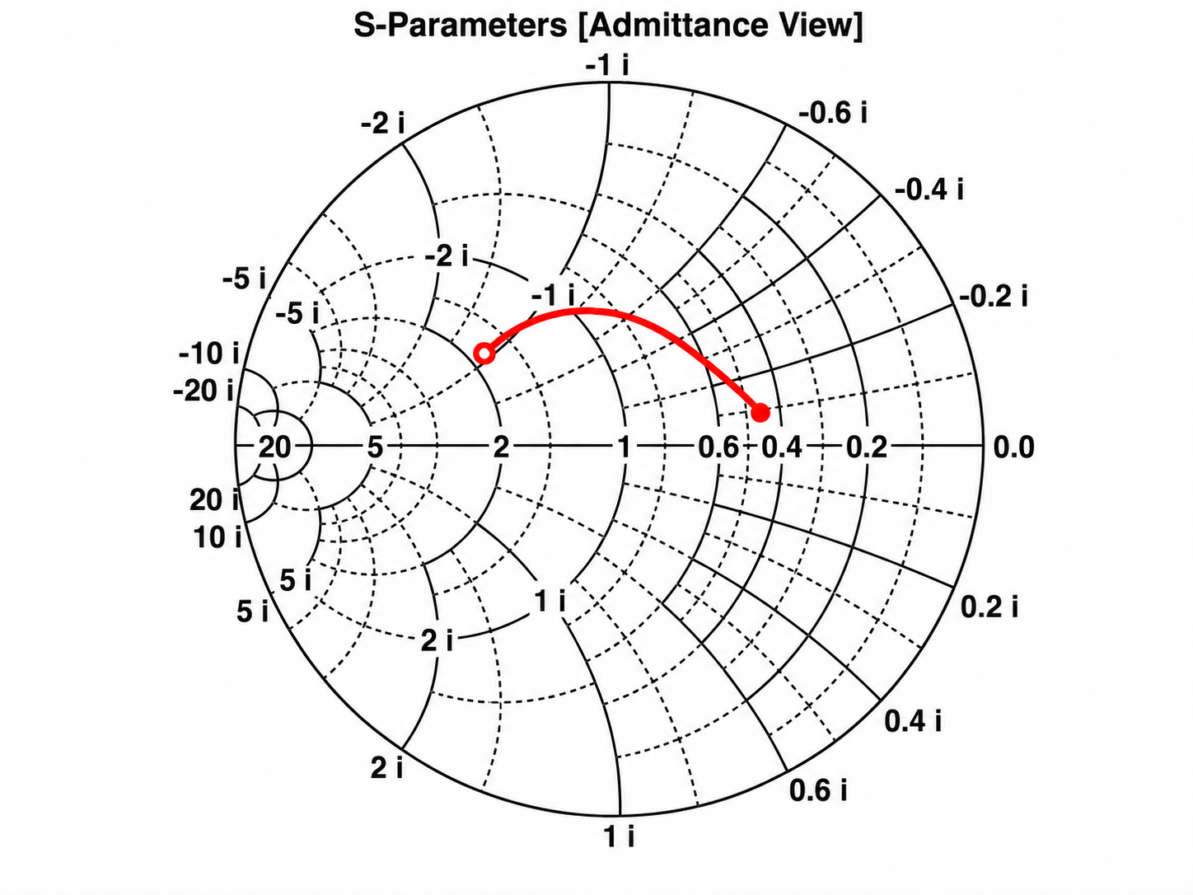
[picture p41: figure]

Figure 26. Smith chart response of the completed 6 × 6 slotted array in admittance view. This plot directly supports the shunt-admittance interpretation of the complete array response.

Together, the polar plot, impedance Smith chart, and admittance Smith chart show that the completed array behaves as a frequency-dependent electromagnetic load. The polar plot confirms that the reflected signal changes in both magnitude and phase across the sweep. The impedance Smith chart shows that the input impedance remains displaced from the ideal matched condition, explaining why the simulated return loss is moderate rather than excellent. The admittance Smith chart provides the most useful interpretation for this study, because the complete slot array is being treated as an equivalent shunt admittance.

Therefore, the equivalent-circuit interpretation confirms that the completed 6 × 6 slot array is capable of radiating as a collective aperture, but that the impedance match is not yet fully optimised. This is consistent with the S11 frequency sweep, where the minimum reflection coefficient is usable but not deeply matched. Further improvement would require refinement of the slot offsets, slot lengths, cavity geometry, or feed transition so that Yarray moves closer to the matched admittance condition at the intended operating frequency.
c. Frequency Sweep and Far-Field Response After implementation of the complete 6 × 6 slot-array geometry, a frequency-domain sweep was performed in CST to evaluate the impedance response and radiation behaviour of the final structure. The sweep was restricted to a narrow band around the intended operating frequency in order to reduce computational cost while still capturing the dominant resonance behaviour of the array. In addition to the input reflection coefficient, S11, and the far-field directivity response, the electric-field distribution across the completed aperture was examined to verify that the slot array was being excited as intended.

Figure 27 shows the electric-field magnitude distribution observed from the upper radiating face of the completed 6 × 6 array. The field concentration is strongest around the slot apertures, confirming that energy is being coupled from the internal waveguide structure into the radiating slot layer. The field pattern is not perfectly uniform across all elements, which is expected because the array uses non-uniform slot offsets and lengths rather than identical repeated apertures. The stronger field regions near the central elements indicate greater local coupling, while the weaker edge regions are consistent with aperture truncation and reduced excitation near the boundaries of the array.

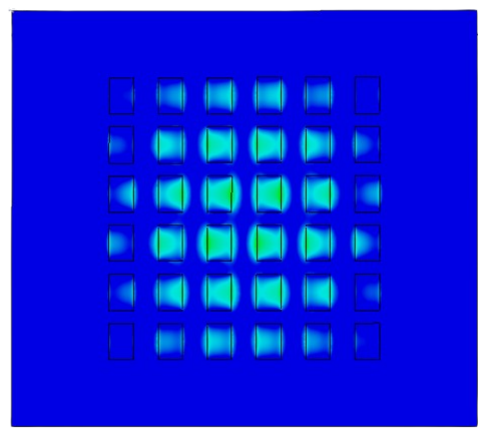
[picture p42: figure]

Figure 27. Top-face electric-field magnitude distribution of the completed 6 × 6 slotted array. The strongest field concentrations occur around the radiating apertures, indicating effective coupling into the upper slot layer.

Figure 28 shows the corresponding field distribution viewed from the lower coupling-slot side of the structure. The field is strongly concentrated along the central coupling path, indicating that the lower slot arrangement is actively feeding the upper cavity-backed aperture region. The vertically aligned high-field region shows how energy is transferred through the internal coupling structure before being redistributed across the full 6 × 6 radiating aperture. This result is important because it confirms that the completed geometry is not merely a static slot layout, but an electromagnetically coupled structure in which the lower coupling slots, cavity region, and upper radiating apertures operate together.

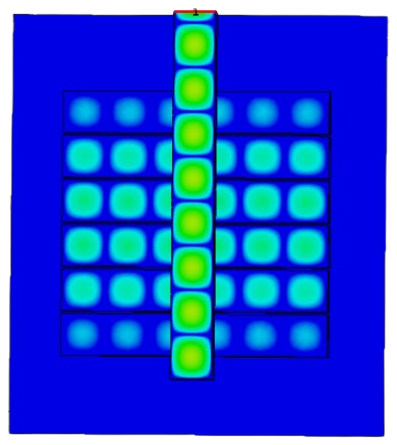
[picture p43: figure]

Figure 28. Bottom-side electric-field magnitude distribution of the completed 6 × 6 array. The central high-field region shows the coupling path feeding the cavity-backed aperture structure.

The top and bottom field plots provide a qualitative check on the array implementation before examining the global performance metrics. The upper view confirms that the radiating apertures are excited across the array surface, while the lower view shows the internal coupling path that transfers energy into the aperture region. Together, these plots support the interpretation that the final design behaves as a coupled multilayer waveguide aperture rather than as a simple collection of isolated slots. The main quantities extracted from the subsequent simulation were therefore the input reflection coefficient, S11, and the far-field directivity response in the two principal angular cuts.

Figure 29 shows the simulated S11 magnitude response of the completed 6 × 6 slotted waveguide array. The curve exhibits a clear minimum near the centre of the swept band, with the lowest reflection level occurring at approximately 9.03 GHz. The minimum value is approximately −10.5 dB, indicating that the array is reasonably coupled to the waveguide feed at the selected operating frequency. Although this is not an ideal impedance match, it is sufficient to demonstrate that the full-array geometry can be excited and evaluated without severe mismatch. Further optimisation of the slot offsets, slot lengths, cavity dimensions, or feed transition would be required to obtain a deeper return-loss minimum.


Figure 29. Simulated S11 magnitude response of the completed 6 × 6 slotted waveguide array. The minimum reflection coefficient occurs near 9.03 GHz, indicating the approximate operating frequency of the array.

The far-field response was then evaluated at 9 GHz using two principal cuts. Figure 30 shows the directivity pattern for the constant-θ cut, where θ = 90◦ and the angular variation is plotted with respect to ϕ. The main lobe occurs at ϕ = 90◦
, which
is consistent with the intended broadside radiation direction. The reported main-lobe magnitude is approximately 0.143 dB, and the 3 dB angular width is approximately 14.2

◦
. The sidelobe level in this plane is approximately −23.2 dB, which is below the target suppression benchmark of −20 dB.


Figure 30. Far-field directivity response at 9 GHz for the constant-θ cut, where θ = 90◦
. The plot shows
directivity magnitude in dB against ϕ in degrees. The main beam occurs at ϕ = 90◦
, with a reported sidelobe level of approximately −23.2 dB.

Figure 31 shows the corresponding constant-ϕ cut, where ϕ = 90◦ and the angular variation is plotted with respect to θ. In this plane, the main beam is again centred at 90◦
, confirming that the
dominant radiation direction remains aligned with the intended broadside direction. The 3 dB angular width is approximately 13.7

◦
, and the reported
sidelobe level is approximately −21.8 dB. This result also satisfies the −20 dB suppression target, although the sidelobe suppression is slightly weaker than that observed in the constant-θ cut.


Figure 31. Far-field directivity response at 9 GHz for the constant-ϕ cut, where ϕ = 90◦
. The plot shows
directivity magnitude in dB against θ in degrees. The main beam occurs at θ = 90◦
, with a reported sidelobe level of approximately −21.8 dB.

The two far-field cuts show that the completed array produces a dominant broadside beam in both principal planes. The constant-θ cut gives a stronger sidelobe suppression, with a sidelobe level of approximately −23.2 dB, while the constant-ϕ cut gives a sidelobe level of approximately −21.8 dB. Since both values are below −20 dB, the simulated radiation behaviour satisfies the project objective of suppressing unwanted off-axis radiation to a level significantly below the main beam.

Taken together, the frequency sweep and far-field results provide two complementary checks on the final array design. The S11 result confirms that the completed slot array remains reasonably coupled to the waveguide feed near 9.03 GHz, while the far-field cuts confirm that the array produces a controlled broadside beam with sidelobes suppressed below the target level in both principal planes. Therefore, the CST results demonstrate that the proposed slot-placement strategy can be implemented at full-array scale and can achieve the intended second-order lobe suppression behaviour, subject to further refinement of the impedance match. “‘
d. Applied-Voltage Matrix Analysis
The applied-voltage response of the final 6×6 slotted array was analysed to evaluate how the implemented cavity-slot and coupling-slot geometry affected the aperture excitation. Since the applied voltage is a complex quantity, the response at each array element was separated into its real and imaginary components. The complex applied voltage at element (i, j) was written as

Vapp,i,j = Re{Vapp,i,j} + j Im{Vapp,i,j}, (27)

where i and j denote the row and column indices of the 6 × 6 array. Tables 5 and 6 show the real and imaginary components of the applied-voltage distribution.

The real component shows that the largest positive voltage contribution occurs near the centre of the array, particularly around the central elements. The imaginary component follows a similar spatial trend in magnitude but remains negative across the aperture. Together, these two matrices define the full complex excitation of each slot element.
The applied-voltage magnitude was calculated from the real and imaginary components using
|Vapp,i,j | =

q
Re{Vapp,i,j}

2 + Im{Vapp,i,j}

2. (28)

This magnitude represents the excitation strength of each slot element. Larger values indicate stronger local excitation, while smaller values indicate weaker contribution to the aperture field.

Table 7 shows that the strongest excitation occurs around the centre of the aperture, where the applied-voltage magnitude reaches values close to
11. The outer corner elements are below 2, confirming that the realised aperture excitation is tapered from the centre toward the edges. This type of taper is useful because it reduces abrupt aperture discontinuities and can contribute to lower off-axis radiation.

The phase angle of the applied voltage was calculated from the complex argument,

̸ Vapp,i,j = atan2 (Im{Vapp,i,j}, Re{Vapp,i,j}).
(29)
The two-argument arctangent was used so that the correct quadrant of the complex voltage was preserved.
Table 8 shows that the applied-voltage phase is not completely uniform across the aperture. The centre elements remain close to approximately −50◦ ,
while larger deviations appear toward the outer elements. This matters because the far-field pattern depends on both magnitude and phase; large phase imbalance can distort the aperture field and contribute to unwanted lobe formation.

To compare the realised excitation with the intended aperture taper, the magnitude distribution was normalised using the centre-four reference magnitude. Since the array has no single centre element, the four central elements were averaged to form the reference value. The normalised magnitude was calculated as

|Vapp,i,j |norm =

|Vapp,i,j |

|Vapp|
c4
. | (30)

Table 9 shows that the centre elements have normalised magnitudes close to unity, as expected from the centre-four reference. The outer rows and columns have much lower normalised values, with the corner elements near 0.16–0.17. This confirms that the realised excitation distribution is strongly tapered from the centre toward the edges.

The normalised applied-voltage distribution was then compared with the intended target excitation profile. The target matrix defines the desired aperture taper used to guide the array synthesis. As shown in Table 10, the target distribution is symmetric about the centre of the array, with maximum excitation at the centre four elements and progressively reduced excitation toward the edges.

To quantify how closely the realised excitation followed the target distribution, an error matrix was calculated as

Ei,j = |Vapp,i,j |norm − Ti,j , | (31)

where Ti,j is the target excitation value at element (i, j). Positive values indicate that the realised excitation was higher than the target, while negative values indicate that it was lower.

Table 11 shows that most of the excitation errors remain within a few hundredths of the target values. The largest positive deviations occur in the second and fourth rows, while the largest negative deviation occurs near the central region at element (3, 3). Overall, the small error values indicate that the implemented slot geometry produced an applied-voltage distribution that closely followed the intended target excitation profile.

These results provide an important verification step for the 6×6 array synthesis. The real and imaginary voltage matrices define the complex excitation, the magnitude and phase matrices describe the realised aperture field, and the normalised/error matrices confirm how closely the realised excitation matches the intended taper. This supports the use of the spline-generated cavity-slot dimensions as a practical method for shaping the aperture response and reducing unwanted lobe behaviour.
e. Centre-Four Applied-Voltage Normalisation
The centre-four elements were examined separately because the 6×6 array has no single centre element. The physical centre of the aperture lies between elements (3, 3), (3, 4), (4, 3), and (4, 4). These four elements were therefore used to define the central reference magnitude and phase for the applied-voltage distribution. The complete C++ implementation used for this calculation is provided in Appendix F.

The centre-four applied-voltage magnitude was calculated as

|Vapp|
c4 =

1
4
|Vapp,3,3| + |Vapp,3,4|

+ |Vapp,4,3| + |Vapp,4,4|

(32)

Substituting the calculated values gives

|Vapp|
c4 =

1
4
10.479520 + 10.723351

+ 11.076428 + 10.819638
= 10.774734.
(33)
The centre-four phase reference was calculated as

̸ Vappc4 =

1
4
̸ Vapp,3,3 + ̸ Vapp,3,4

+ ̸ Vapp,4,3 + ̸ Vapp,4,4

(34)

This gives

̸ Vappc4 =

1
4

− 48.09◦ + (−50.43◦
)

+ (−51.38◦

) + (−49.60◦
)

= −49.88◦
(35)
The normalised applied-voltage magnitude for each element was calculated using

|Vapp,i,j |norm =

|Vapp,i,j |

|Vapp|
c4
. | (36)

For the centre-four elements, this gives

|Vapp,3,3|norm =

10.479520
10.774734

= 0.9726,

|Vapp,3,4|norm =

10.723351
10.774734

= 0.9952,

|Vapp,4,3|norm =

11.076428
10.774734

= 1.0280,

|Vapp,4,4|norm =

10.819638
10.774734

= 1.0042.

(37)

The phase deviation of each element relative to the centre-four phase reference was calculated as

∆ϕi,j = ̸ Vapp,i,j − ̸ Vappc4. | (38)

For the centre-four elements, this gives

∆ϕ3,3 = −48.09◦ − (−49.88◦

) = 1.78◦
,
∆ϕ3,4 = −50.43◦ − (−49.88◦

) = −0.55◦
,
∆ϕ4,3 = −51.38◦ − (−49.88◦

) = −1.50◦
,
∆ϕ4,4 = −49.60◦ − (−49.88◦

) = 0.27◦

(39)

The excitation error was calculated by comparing the normalised applied-voltage magnitude with the target excitation matrix:

Ei,j = |Vapp,i,j |norm − Ti,j , | (40)

where Ti,j is the target excitation at element (i, j). The maximum absolute error was

max |Ei,j | = 0.0465, | (41)

and the root-mean-square error was calculated using

ERMS =

### vuut

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
i,j = 0.0262. (42)

These results show that the centre-four normalised magnitudes remain close to unity and that the centre-four phase deviations remain close to 0

◦
The small maximum and RMS errors indicate that the realised applied-voltage distribution closely follows the intended target excitation profile. This verifies that the centre-four reference is suitable for assessing the aperture excitation of the 6 × 6 array.
e. Applied-Voltage Matrix Analysis
The applied-voltage response of the final 6×6 slotted array was analysed to evaluate how the implemented cavity-slot and coupling-slot geometry affected the aperture excitation. Since the applied voltage is a complex quantity, the response at each array element was first separated into its real and imaginary components. The complex applied voltage at element (i, j) was written as

Vapp,i,j = Re{Vapp,i,j} + j Im{Vapp,i,j}, (43)

where i and j denote the row and column indices of the 6 × 6 array. Tables 5 and 6 show the real and imaginary components of the applied-voltage distribution.

Table 5

Real component of the applied-voltage

distribution, Re{Vapp}.

Re{Vapp} (Real Part)
i\j | 1 | 2 | 3 | 4 | 5 | 6
1 | 1.430680 | 1.557819 | 2.190069 | 1.648017 | 1.964227 | 1.225528
2 | 3.053586 | 4.102413 | 5.317674 | 4.756039 | 4.456888 | 2.897924
3 | 4.015515 | 5.903867 | 6.999762 | 6.831015 | 5.873717 | 4.118667
4 | 4.091945 | 5.899121 | 6.913457 | 7.012372 | 5.845611 | 3.975239
5 | 2.915737 | 4.466292 | 4.938300 | 5.374880 | 4.122050 | 3.031380
6 | 1.241757 | 1.998119 | 1.805654 | 2.340819 | 1.430327 | 1.449499

Table 6

Imaginary component of the applied-voltage

distribution, Im{Vapp}.

Im{Vapp} (Imaginary Part)
i\j | 1 | 2 | 3 | 4 | 5 | 6
1 | -1.215424 | -2.299639 | -3.729877 | -3.471311 | -2.381231 | -1.141884
2 | -1.974363 | -4.400251 | -6.255274 | -6.779727 | -4.039809 | -2.160932
3 | -2.543347 | -5.235148 | -7.798953 | -8.266045 | -5.021496 | -2.617474
4 | -2.774660 | -5.228442 | -8.653981 | -8.239612 | -5.634161 | -2.723634
5 | -1.999506 | -3.785695 | -6.293602 | -5.877724 | -4.209233 | -1.941643
6 | -1.155136 | -2.432653 | -3.494322 | -3.757526 | -2.422456 | -1.196527

The real component in Table 5 shows that the largest positive voltage contribution occurs near the centre of the array, particularly around the central elements. The imaginary component in Table 6 follows a similar spatial trend in magnitude but remains negative across the aperture. Together, these two matrices define the full complex excitation of each slot element.

The applied-voltage magnitude was then calculated from the real and imaginary components using

|Vapp,i,j | =

q
Re{Vapp,i,j}

2 + Im{Vapp,i,j}

2. (44)

This magnitude represents the excitation strength of each slot element. Larger values indicate stronger local excitation, while smaller values indicate weaker contribution to the aperture field.

Table 7

Applied-voltage magnitude distribution, |Vapp|.

|Vapp| (Magnitude)
i\j | 1 | 2 | 3 | 4 | 5 | 6
1 | 1.877259 | 2.777614 | 4.325319 | 3.842650 | 3.086819 | 1.675057
2 | 3.636275 | 6.015979 | 8.210122 | 8.281582 | 6.015306 | 3.614912
3 | 4.753206 | 7.890654 | 10.479520 | 10.723351 | 7.727611 | 4.880019
4 | 4.943961 | 7.882654 | 11.076428 | 10.819638 | 8.118802 | 4.818787
5 | 3.535469 | 5.854848 | 7.999765 | 7.964733 | 5.891429 | 3.599895
6 | 1.695966 | 3.148060 | 3.933277 | 4.427012 | 2.813206 | 1.879554

Table 7 shows that the strongest excitation occurs around the centre of the aperture, where the applied-voltage magnitude reaches values close to
11. The outer corner elements are below 2, confirming that the realised aperture excitation is tapered from the centre toward the edges. This type of taper is useful because it reduces abrupt aperture discontinuities and can contribute to lower off-axis radiation.

The phase angle of the applied voltage was calculated from the complex argument,

̸ Vapp,i,j = atan2 (Im{Vapp,i,j}, Re{Vapp,i,j}).
(45)
The two-argument arctangent was used so that the correct quadrant of the complex voltage was preserved.

Table 8

Applied-voltage phase angle calculated from

the complex voltage argument.

Phase Angle = Arg [Re +j Im] (degrees)
i\j | 1 | 2 | 3 | 4 | 5 | 6
1 | −40.35◦ | −55.89◦ | −59.58◦ | −64.60◦ | −50.48◦ | −42.98◦
2 | −32.89◦ | −47.01◦ | −49.63◦ | −54.95◦ | −42.19◦ | −36.71◦
3 | −32.35◦ | −41.56◦ | −48.09◦ | −50.43◦ | −40.53◦ | −32.44◦
4 | −34.14◦ | −41.55◦ | −51.38◦ | −49.60◦ | −43.94◦ | −34.42◦
5 | −34.44◦ | −40.29◦ | −51.88◦ | −47.56◦ | −45.60◦ | −32.64◦
6 | −42.93◦ | −50.60◦ | −62.67◦ | −58.08◦ | −59.44◦ | −39.54◦

Table 8 shows that the applied-voltage phase is not completely uniform across the aperture. The centre elements remain close to approximately −50◦ , while larger deviations appear toward the outer elements. This matters because the far-field pattern depends on both magnitude and phase; large phase imbalance can distort the aperture field and contribute to unwanted lobe formation.

To compare the realised excitation with the intended aperture taper, the magnitude distribution was normalised using the centre-four reference magnitude. Since the array has no single centre element, the four central elements were averaged to form the reference value. The normalised magnitude was calculated as

|Vapp,i,j |norm =

|Vapp,i,j |

|Vapp|
c4
. | (46)

Table 9

Normalised applied-voltage magnitude

distribution, |Vapp(m, n)|/|Vcenter|.

|Vapp(m, n)|/|Vcenter| (Normalised Magnitude)
i\j | 1 | 2 | 3 | 4 | 5 | 6
1 | 0.1742 | 0.2578 | 0.4014 | 0.3566 | 0.2865 | 0.1555
2 | 0.3375 | 0.5583 | 0.7620 | 0.7686 | 0.5583 | 0.3355
3 | 0.4411 | 0.7323 | 0.9726 | 0.9952 | 0.7172 | 0.4529
4 | 0.4588 | 0.7316 | 1.0280 | 1.0042 | 0.7535 | 0.4472
5 | 0.3281 | 0.5434 | 0.7425 | 0.7392 | 0.5468 | 0.3341
6 | 0.1574 | 0.2922 | 0.3650 | 0.4109 | 0.2611 | 0.1744

Table 9 shows that the centre elements have normalised magnitudes close to unity, as expected from the centre-four reference. The outer rows and columns have much lower normalised values, with the corner elements near 0.16–0.17. This confirms that the realised excitation distribution is strongly tapered from the centre toward the edges.

The normalised applied-voltage distribution was then compared with the intended target excitation profile. The target matrix defines the desired aperture taper used to guide the array synthesis. As shown in Table 10, the target distribution is symmetric about the centre of the array, with maximum excitation at the centre four elements and progressively reduced excitation toward the edges.

Table 10

Target excitation distribution for the 6 × 6

array.

Target Excitation
i\j | 1 | 2 | 3 | 4 | 5 | 6
1 | 0.1557 | 0.2715 | 0.3753 | 0.3753 | 0.2715 | 0.1557
2 | 0.2996 | 0.5223 | 0.7221 | 0.7221 | 0.5223 | 0.2996
3 | 0.4149 | 0.7234 | 1.0000 | 1.0000 | 0.7234 | 0.4149
4 | 0.4149 | 0.7234 | 1.0000 | 1.0000 | 0.7234 | 0.4149
5 | 0.2996 | 0.5223 | 0.7221 | 0.7221 | 0.5223 | 0.2996
6 | 0.1557 | 0.2715 | 0.3753 | 0.3753 | 0.2715 | 0.1557

To quantify how closely the realised excitation followed the target distribution, an error matrix was calculated as

Ei,j = |Vapp,i,j |norm − Ti,j , | (47)

where Ti,j is the target excitation value at element (i, j). Positive values indicate that the realised excitation was higher than the target, while negative values indicate that it was lower.

Table 11

Normalised applied-voltage error relative to

the target excitation distribution.

Error = Normalised |Vapp| − Target
i\j | 1 | 2 | 3 | 4 | 5 | 6
1 | 0.0185 | −0.0137 | 0.0261 | −0.0187 | 0.0150 | −0.0002
2 | 0.0379 | 0.0360 | 0.0399 | 0.0465 | 0.0360 | 0.0359
3 | 0.0262 | 0.0089 | −0.0274 | −0.0048 | −0.0062 | 0.0380
4 | 0.0439 | 0.0082 | 0.0280 | 0.0042 | 0.0301 | 0.0323
5 | 0.0285 | 0.0211 | 0.0204 | 0.0171 | 0.0245 | 0.0345
6 | 0.0017 | 0.0207 | −0.0103 | 0.0356 | −0.0104 | 0.0187

Table 11 shows that most of the excitation errors remain within a few hundredths of the target values. The largest positive deviations occur in the second and fourth rows, while the largest negative deviation occurs near the central region at element (3, 3). Overall, the small error values indicate that the implemented slot geometry produced an applied-voltage distribution that closely followed the intended target excitation profile.

These results provide an important verification step for the 6×6 array synthesis. The real and imaginary voltage matrices define the complex excitation, the magnitude and phase matrices describe the realised aperture field, and the normalised/error matrices confirm how closely the realised excitation matches the intended taper. This supports the use of the spline-generated cavity-slot dimensions as a practical method for shaping the aperture response and reducing unwanted lobe behaviour.

## VI. TARGET ACHIEVEMENTS AND RESEARCH OUTCOMES

The objective of this research was to investigate whether a truncated-waveguide slot-array approach could suppress unwanted second-order lobes while maintaining a controlled main-beam response. This objective was addressed through a staged workflow involving single-slot modelling, self-admittance extraction, spline-based array synthesis, full 6 × 6 CST implementation, applied-voltage verification, and final radiation-pattern evaluation. The main technical outcomes are summarised in Table 12.

Table 12

Summary of research targets and achieved

outcomes.

Research target | Achieved outcome
Single-slot investigation | Cavity-slot offset and length were swept in CST to characterise the slot response.
Self-admittance extraction | S11 and S21 were converted into Yself = Gself + jBself to identify strong and near-resonant slot regions.
Lookup dataset generation | The sweep results were organised into a spline-interpolated design dataset.
6 × 6 array synthesis | A non-uniform cavity-slot layout
| was generated for all 36 array elements.
Full CST implementation | The layered truncated-waveguide array was assembled as a complete 3D CST model.
Applied-voltage verification | The realised aperture excitation closely followed the target distribution, with small maximum and RMS error.
Frequency and far-field verification | The final array produced a dominant main beam with reduced off-axis lobe behaviour.

Overall, the project achieved its main technical targets. A single-slot response was successfully converted into a non-uniform 6×6 truncated-waveguide slot array through interpolation, centreline mapping, and CST implementation. The final results show that controlled slot-geometry variation can be used to shape the aperture excitation and reduce unwanted lobe behaviour. This provides a strong numerical foundation for future physical prototyping and experimental validation.

## VII. PLA PROTOTYPE REALISATION

After the numerical design and CST verification stages, the array geometry was fabricated as a PLA prototype. The purpose of this prototype was to verify the physical realisation of the 6×6 slot layout before progressing to a conductive metallic version. Since the final array contains non-uniform cavity-slot offsets and lengths, the prototype provided a practical check that the slot distribution could be manufactured and visually inspected as a complete structure.

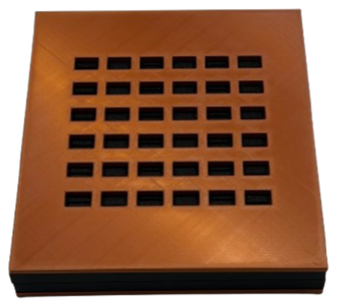
[picture p44: figure]

Figure 32. Top view of the PLA prototype showing the full 6 × 6 slot arrangement. The prototype was used to verify the physical layout and manufacturability of the slot geometry.

Figure 32 shows the upper radiating surface of the PLA prototype. The printed model captures the rectangular slot array and confirms that the synthesised slot layout can be transferred from the CST model into a physical geometry. This is an important intermediate step because the design relies on element-specific slot placement rather than identical repeated slots.

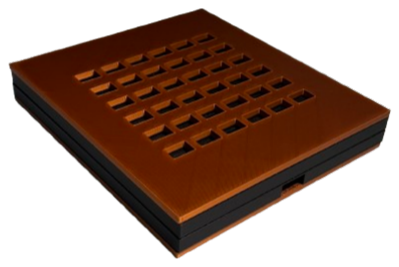
[picture p45: figure]

Figure 33. Low-angle view of the PLA prototype showing the slot openings and layered body of the truncated-waveguide structure.

The low-angle view in Fig. 33 shows the depth of the slot openings and the layered body of the prototype. This view was useful for checking the physical definition of the slot apertures, the thickness of the top layer, and the overall form of the truncated-waveguide body.

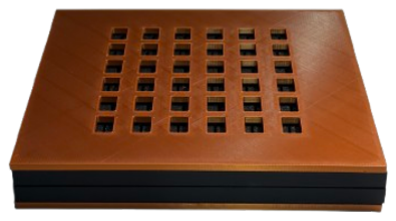
[picture p46: figure]

Figure 34. Front view of the PLA prototype showing the completed printed structure and slot aperture pattern.

Figure 34 provides a second view of the completed printed structure. Together, the three prototype views confirm that the 6×6 array geometry was physically realisable using additive manufacturing. The PLA model therefore served as a mechanical proof-of-concept for the proposed array.

Although the PLA prototype validates manufacturability and geometry realisation, it does not represent the final electromagnetic prototype. PLA is non-conductive and therefore cannot reproduce the metallic boundary conditions required for waveguide operation. The final validation stage would require a conductive prototype, such as stainless steel or another suitable metal, to measure the return loss and radiation pattern experimentally.

## VIII. FUTURE METALLIC PROTOTYPE

The final prototype is intended to be manufactured as a metallic layered waveguide structure, as shown in Fig. 35. The PLA prototype verified the physical geometry, but a metallic version is required for electromagnetic operation because the antenna depends on conductive waveguide boundaries and precisely defined slot apertures.

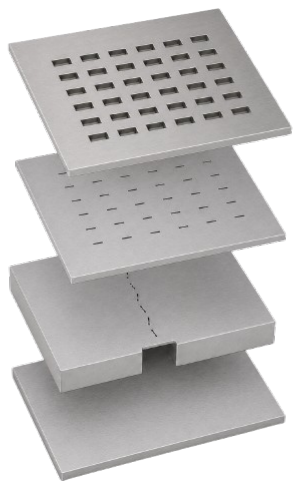
[picture p47: figure]

Figure 35. Conceptual final metallic prototype of the truncated 6 × 6 slotted waveguide array. The exploded view shows the layered construction of the radiating slot layer, coupling features, cavity region, and base structure.

The exploded assembly shows the main layers required to realise the design. The upper layer contains the 6×6 radiating slot pattern, while the lower layers provide the coupling slots, cavity features, waveguide body, and mechanical support. Accurate alignment between these layers is critical because small fabrication errors may shift the resonance, affect S11, or alter the far-field lobe structure.

The metallic prototype would allow experimental validation of the CST results. This would involve measuring the reflection coefficient, S11, using a vector network analyser, followed by far-field radiation-pattern testing to compare the measured main beam, beamwidth, sidelobe level, and second-order-lobe behaviour against simulation.

The metallic prototype therefore represents the next stage of the project. It would move the work from numerical verification to physical electromagnetic validation.

## IX. CONCLUSION AND FUTURE WORK

This research investigated whether a truncated-waveguide slot-array structure could reduce unwanted second-order lobes while maintaining a controlled main-beam response. The work progressed from single-slot CST modelling and self-admittance extraction to spline-based 6 × 6 array synthesis, full CST implementation, and radiation-pattern evaluation. The single-slot study showed that cavity-slot offset and length strongly influence the electromagnetic response. The extracted S-parameters were converted into self-admittance terms, Gself and Bself, which were used to identify suitable slot dimensions for the full array.

Spline interpolation was then used to generate non-uniform cavity-slot offsets and lengths for all 36 array elements. This produced a controlled aperture distribution rather than a repeated uniform slot geometry. The completed CST model showed a tapered applied-voltage distribution, with stronger excitation near the centre and weaker excitation toward the edges.

The final frequency and far-field results showed a usable impedance match near the operating frequency and a dominant main beam with reduced off-axis radiation. A PLA prototype verified the physical geometry, but electromagnetic validation requires a metallic prototype.

Future work should focus on fabricating a conductive prototype, measuring S11 with a vector network analyser, and experimentally validating the far-field pattern. Further optimisation should also consider cavity-slot geometry, coupling-slot geometry, aperture taper, layer alignment, surface roughness, and material conductivity.

# Bibliography

[1] C. A. Balanis, Antenna Theory: Analysis and Design, 4th ed. Hoboken, NJ, USA: John Wiley & Sons, 2016.
[2] J. L. Volakis, Ed., Antenna Engineering Handbook, 4th ed. New York, NY, USA: McGraw-Hill, 2007.
[3] L. Josefsson and S. R. Rengarajan, Slotted Waveguide Array Antennas: Theory, Analysis and Design. London, U.K.: IET, 2018, doi: 10.1049/SBEW517E.
[4] H. M. El Misilmani, M. Al-Husseini, and K. Y. Kabalan, “Design of slotted waveguide antennas with low sidelobes for high power microwave applications,” Progress In Electromagnetics Research C, vol. 56, pp. 15–28, 2015.
[5] P. Delos, B. Broughton, and J. Kraft, “Phased array antenna patterns—Part 2: Grating lobes and beam squint,” Analog Devices Analog Dialogue, 2020.
[6] Y.-S. Yeoh and K.-S. Min, “Characteristics of 6 × 26 slotted waveguide array antenna for wave monitoring radar system,” Journal of Electromagnetic Engineering and Science, vol. 21, no. 5, pp. 439–447, Nov. 2021, doi: 10.26866/jees.2021.5.r.53.
[7] B. M. Yousef et al., “Ultra-low SLL slotted waveguide antenna array using groove-gap waveguide technology for millimeter-wave applications,” AEU - International Journal of Electronics and Communications, 2024.

22

## Appendix A: Data Records for Single Slot Parametric Sweep

Table 13

S-parameter data records for the single-slot parametric sweep.

Run ID | ℜ{S11} | ℑ{S11} | ℜ{S21} | ℑ{S21}
1 | -0.001468 | 0.001917 | 0.998874 | 0.000488
2 | -0.001697 | 0.001754 | 0.998312 | 0.000078
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
466 | 9.525863 | -5.892697 | 6.292975 | -8.914558
467 | 9.802213 | -6.520281 | 6.315286 | -9.607078
468 | 10.050186 | -7.212166 | 6.288761 | -10.352859

Continued on next page

Table 14

Integrated electric-field curve data records for the single-slot parametric sweep. continued.

Run ID | ℜ{E1} | ℑ{E1} | ℜ{E2} | ℑ{E2}
469 | 10.261526 | -7.973467 | 6.201372 | -11.149489
470 | 10.428899 | -8.810468 | 6.040625 | -11.995018
471 | 10.525565 | -9.714723 | 5.790759 | -12.883747
472 | 10.544274 | -10.689896 | 5.440564 | -13.806759
473 | 10.462870 | -11.723236 | 4.974795 | -14.748224
474 | 10.266459 | -12.805389 | 4.382144 | -15.691117
475 | 9.935612 | -13.914288 | 3.653482 | -16.611033
476 | 9.459330 | -15.026886 | 2.786977 | -17.481062
477 | 8.835538 | -16.122123 | 1.787297 | -18.271079
478 | 8.058634 | -17.155406 | 0.667753 | -18.952487
479 | 7.139705 | -18.107488 | -0.555154 | -19.501004
480 | 6.105944 | -18.936691 | -1.840150 | -19.890847
481 | 4.986163 | -19.621032 | -3.151131 | -20.114141
482 | 3.810357 | -20.153301 | -4.457350 | -20.171753
483 | 3.091645 | -21.227278 | -5.337352 | -20.179765

## Appendix B: Supplementary Single-Slot Analysis Figures

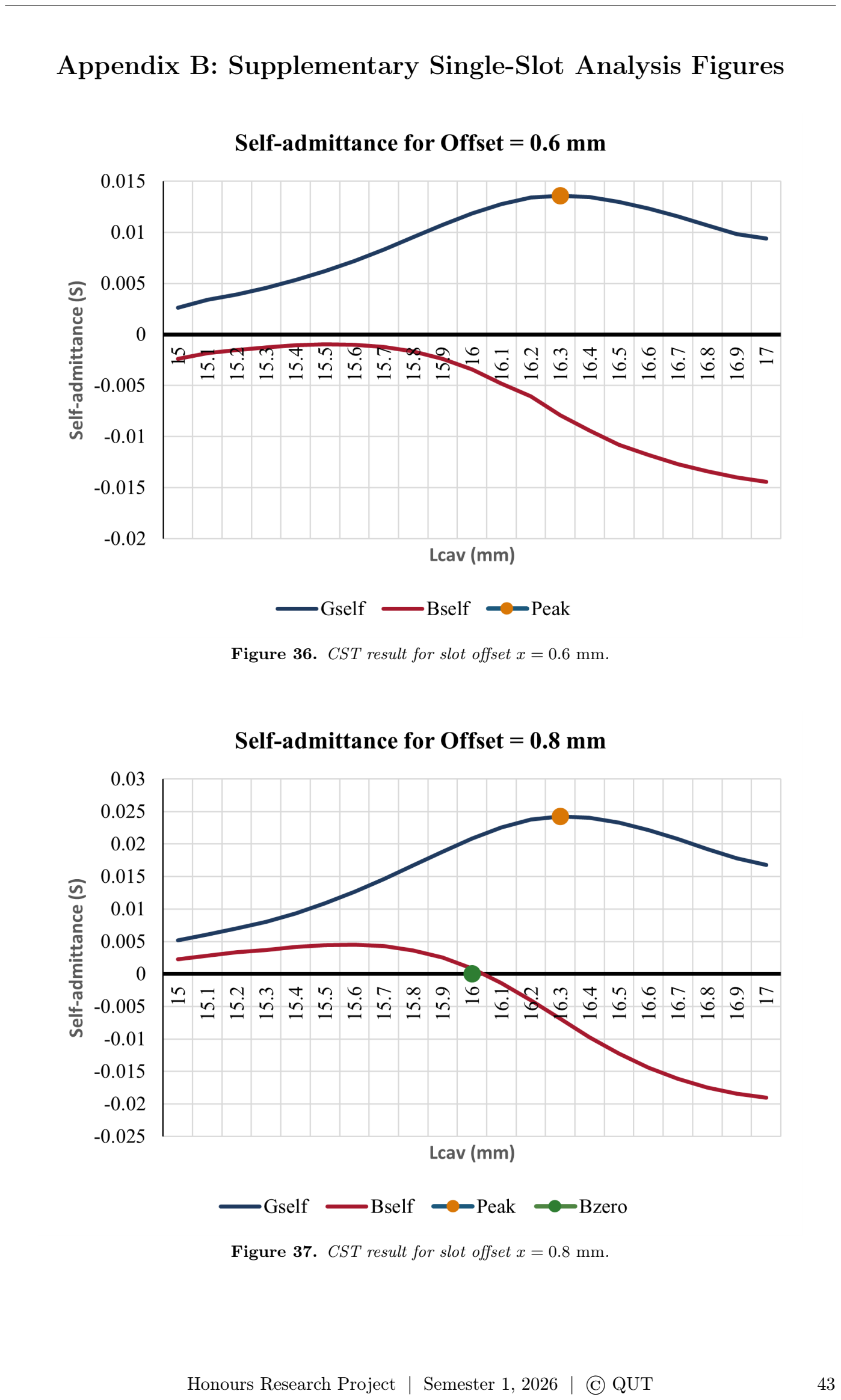
[picture p48: page 44]

Figure 36. CST result for slot offset x = 0.6 mm.

Figure 37. CST result for slot offset x = 0.8 mm.

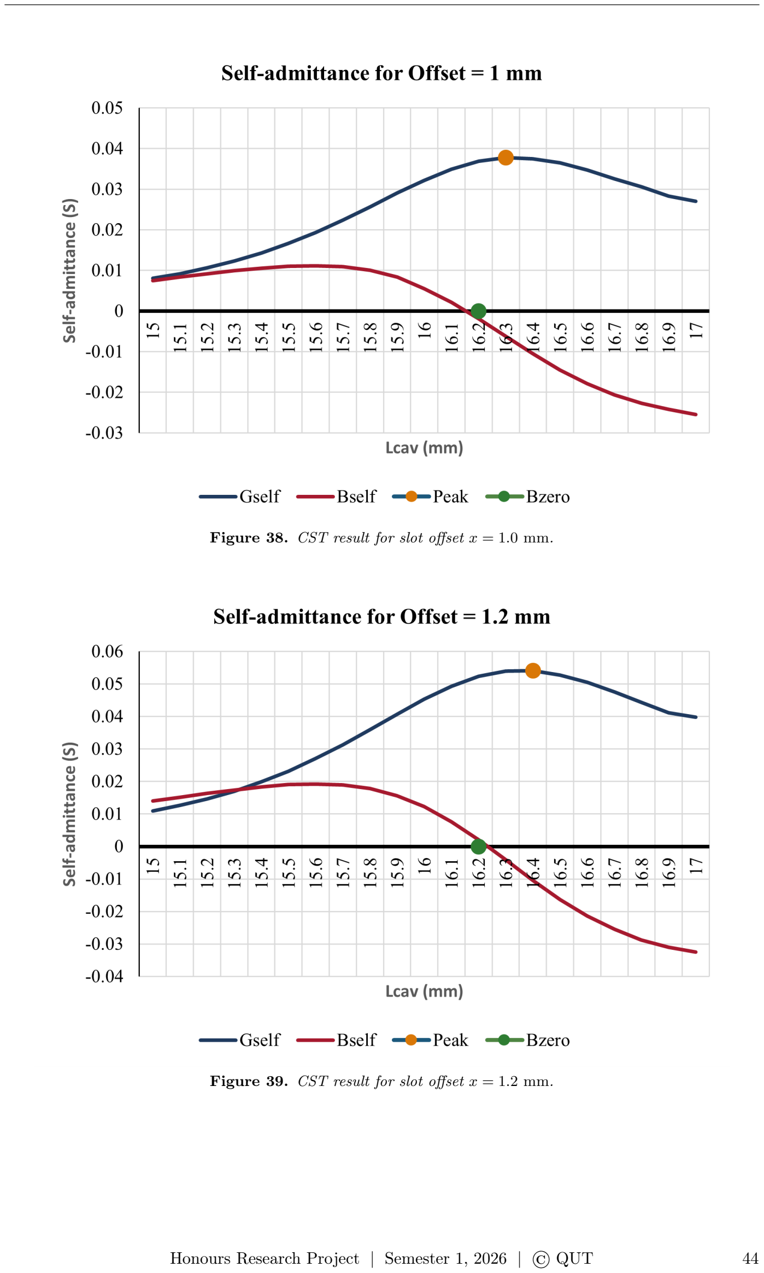
[picture p49: page 45]

Figure 38. CST result for slot offset x = 1.0 mm.

Figure 39. CST result for slot offset x = 1.2 mm.

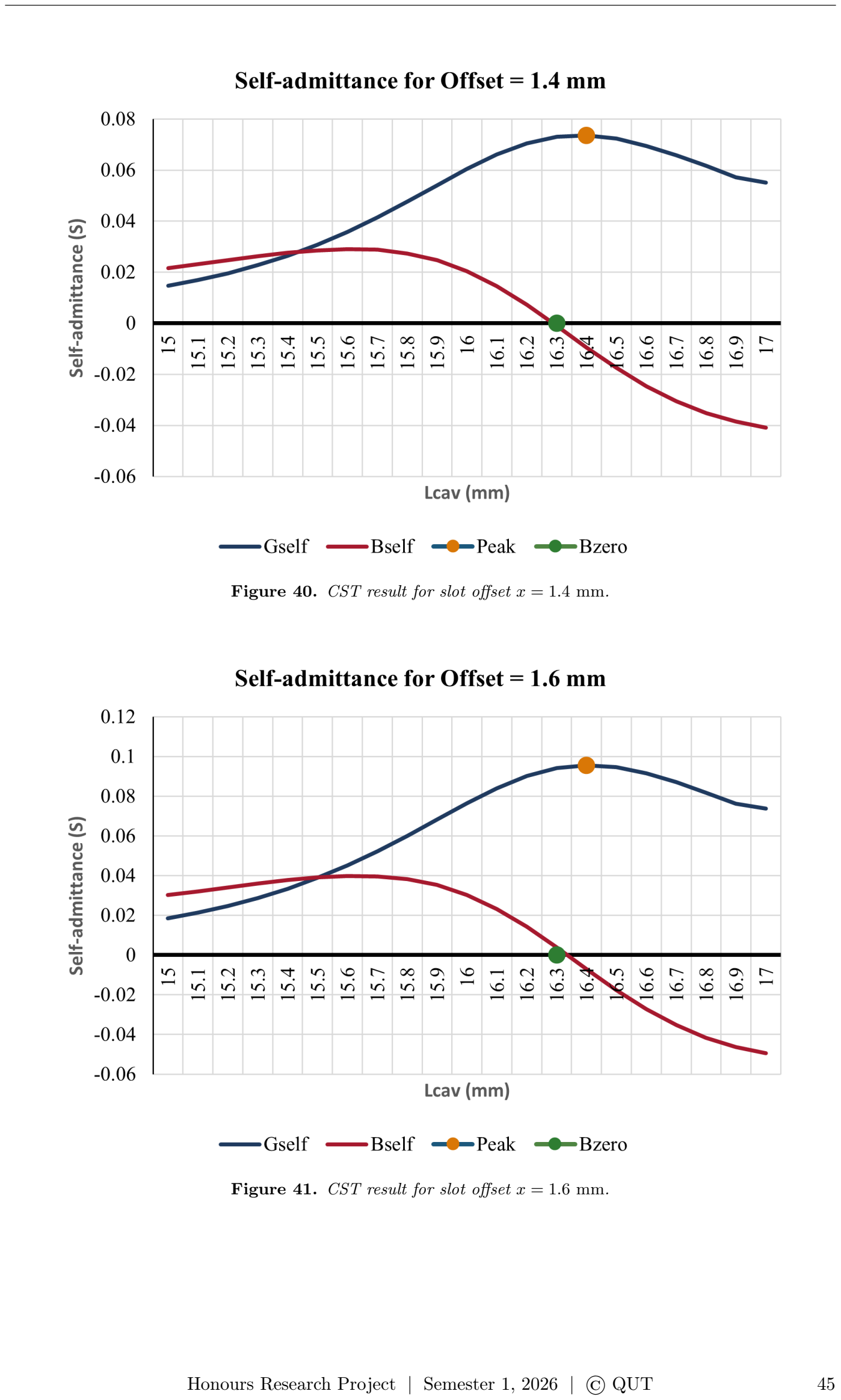
[picture p50: page 46]

Figure 40. CST result for slot offset x = 1.4 mm.

Figure 41. CST result for slot offset x = 1.6 mm.

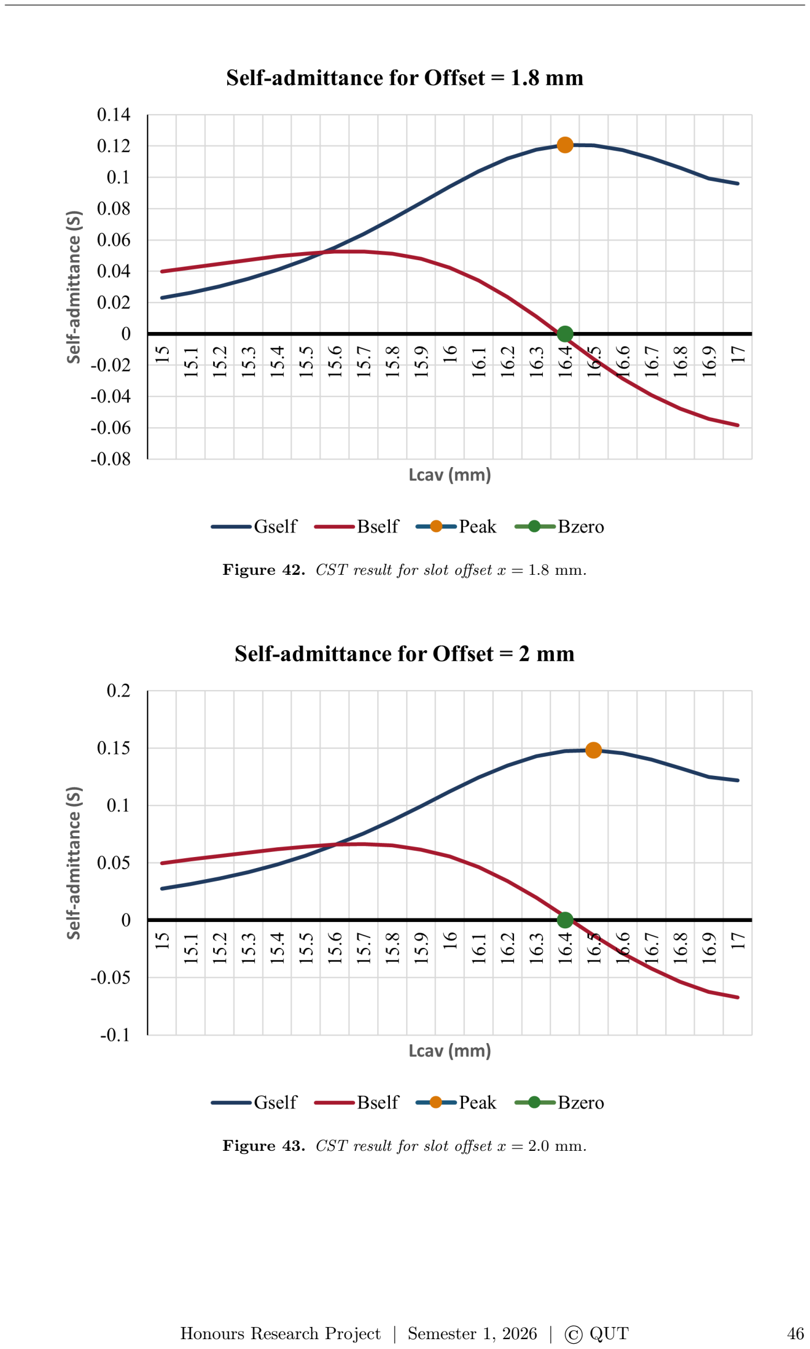
[picture p51: page 47]

Figure 42. CST result for slot offset x = 1.8 mm.

Figure 43. CST result for slot offset x = 2.0 mm.

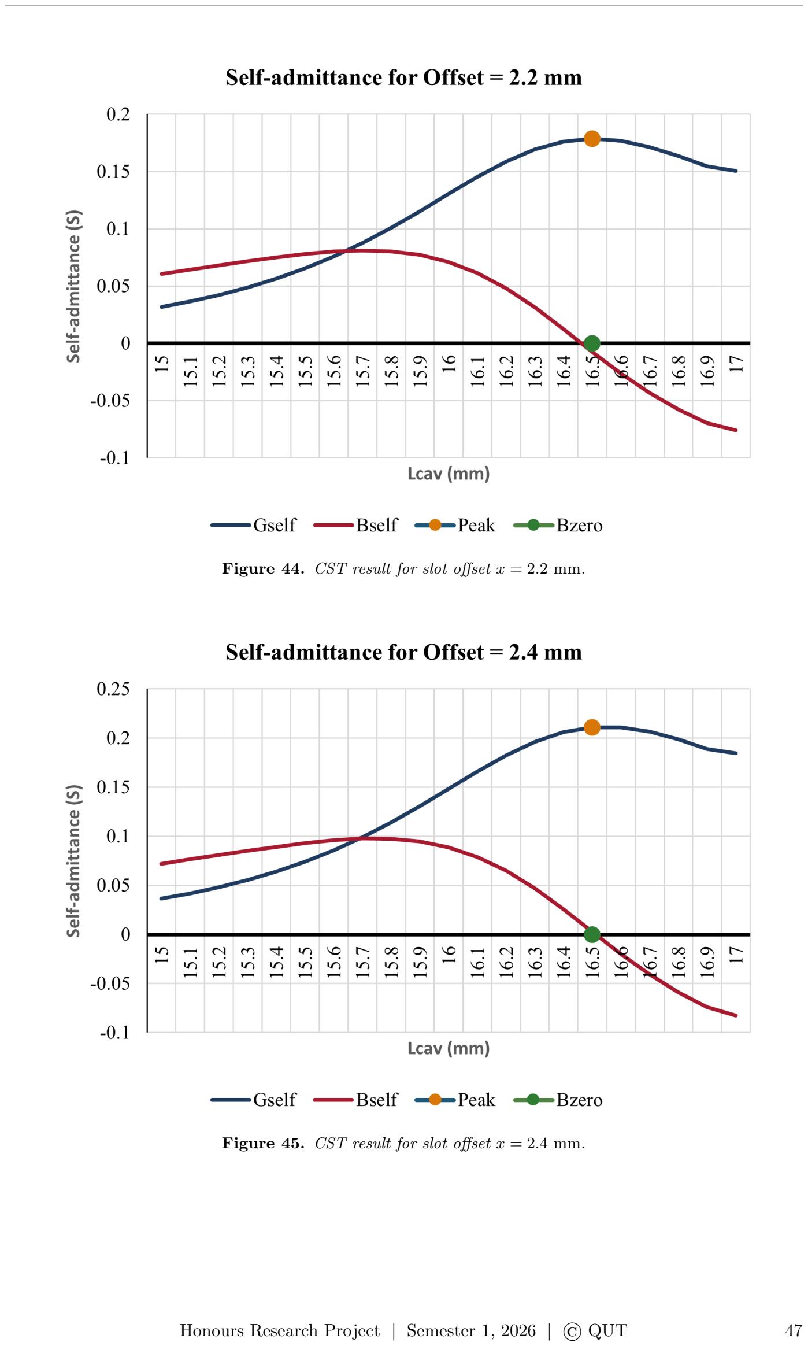
[picture p52: page 48]

Figure 44. CST result for slot offset x = 2.2 mm.

Figure 45. CST result for slot offset x = 2.4 mm.

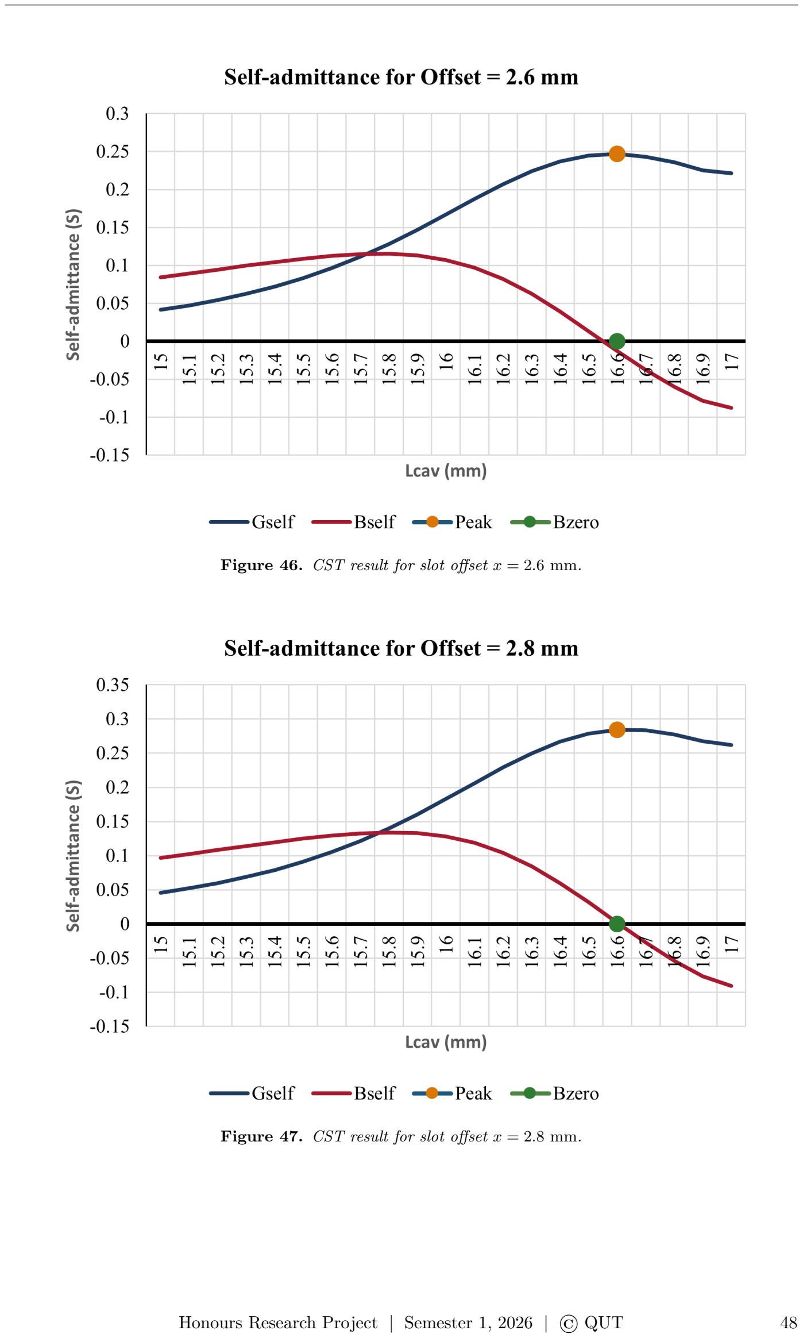
[picture p53: page 49]

Figure 46. CST result for slot offset x = 2.6 mm.

Figure 47. CST result for slot offset x = 2.8 mm.

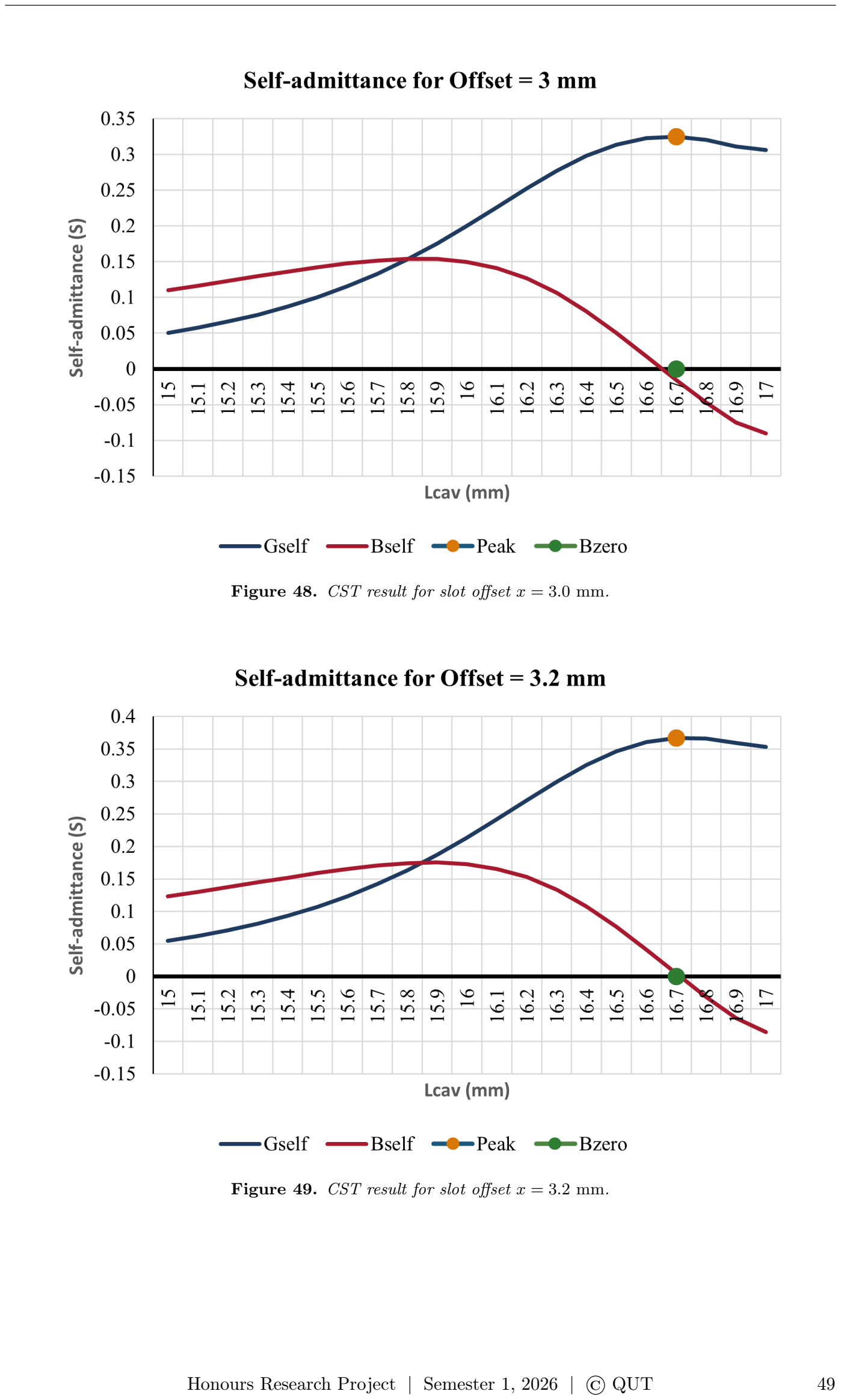
[picture p54: page 50]

Figure 48. CST result for slot offset x = 3.0 mm.

Figure 49. CST result for slot offset x = 3.2 mm.

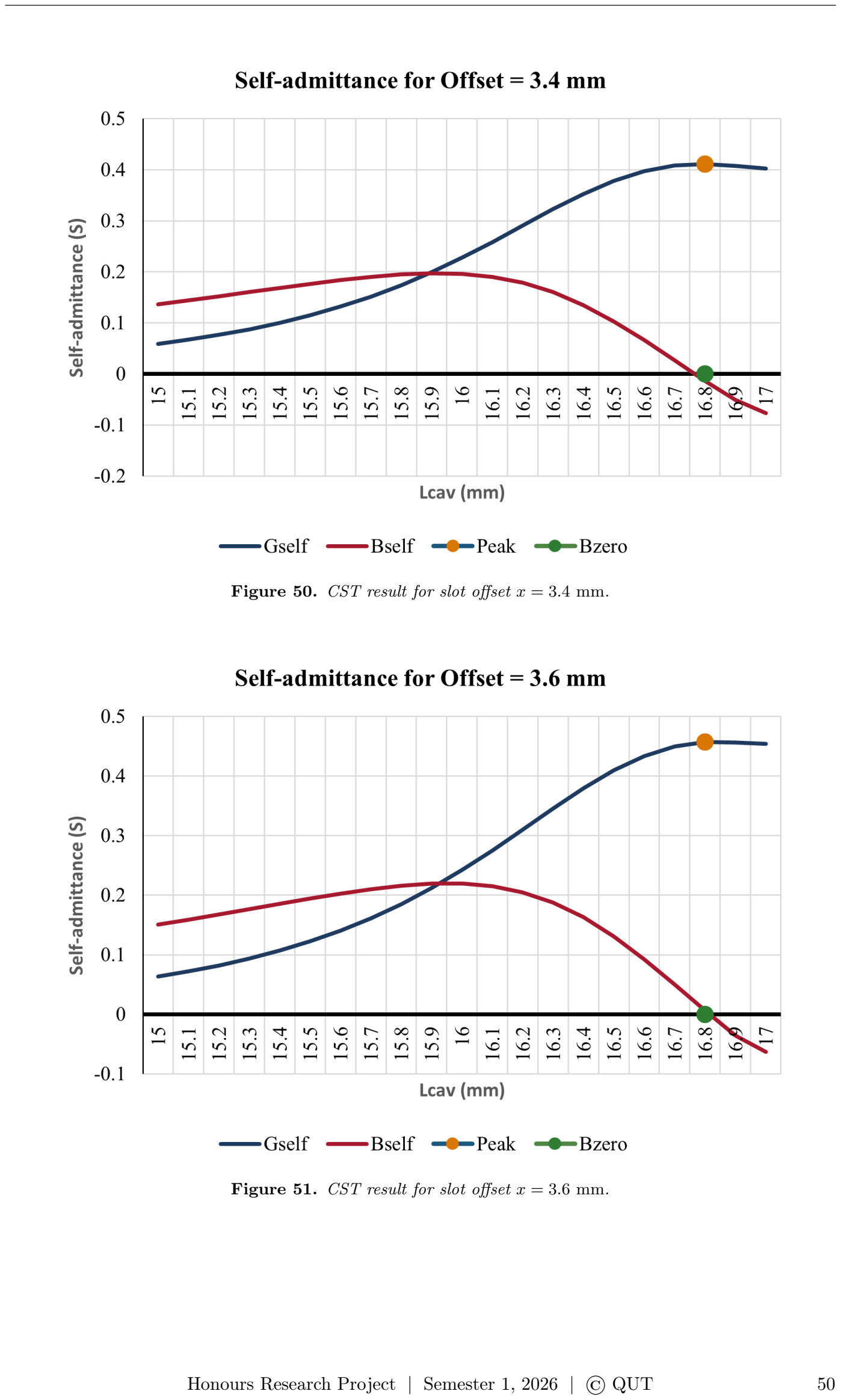
[picture p55: page 51]

Figure 50. CST result for slot offset x = 3.4 mm.

Figure 51. CST result for slot offset x = 3.6 mm.

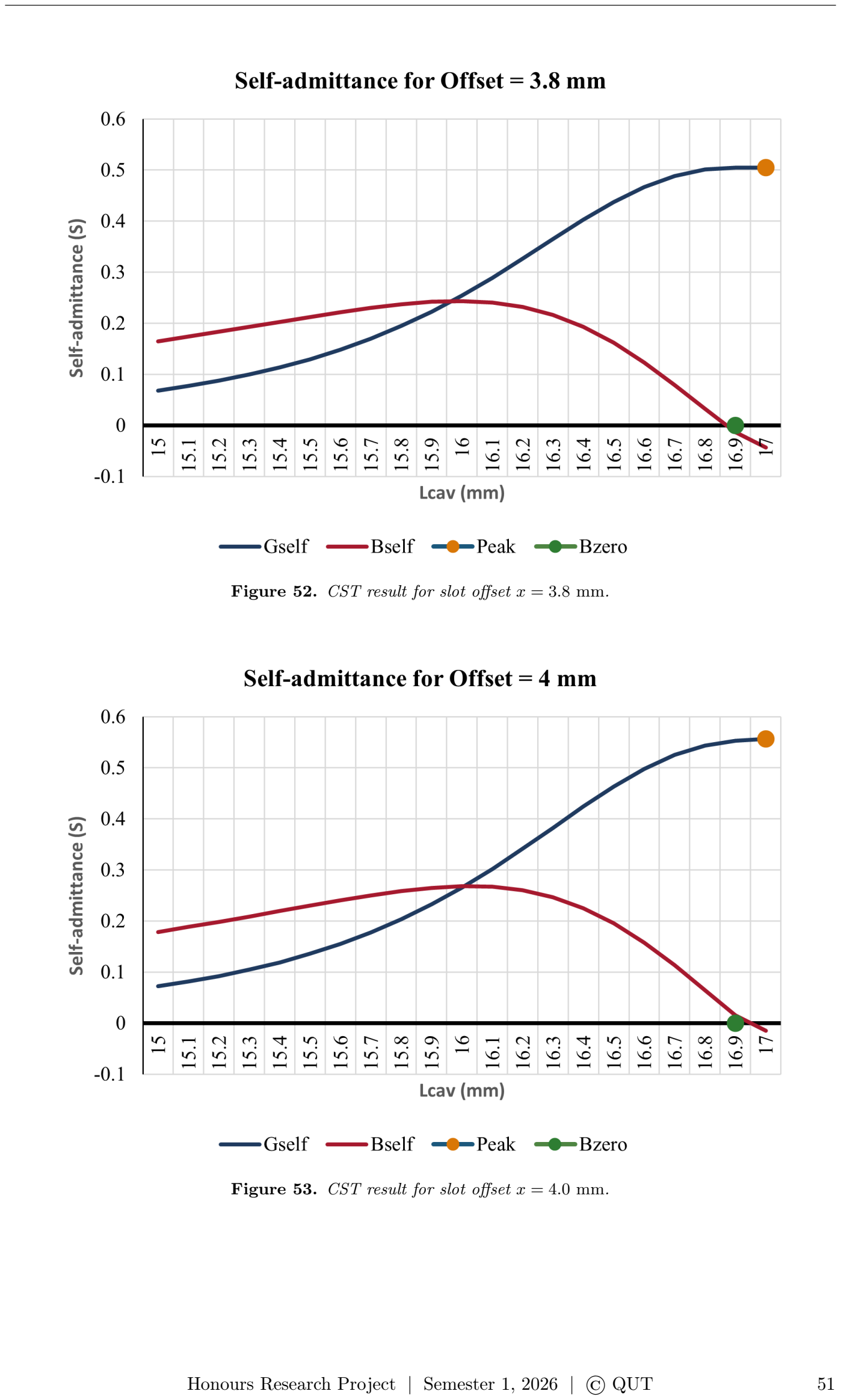
[picture p56: page 52]

Figure 52. CST result for slot offset x = 3.8 mm.

Figure 53. CST result for slot offset x = 4.0 mm.

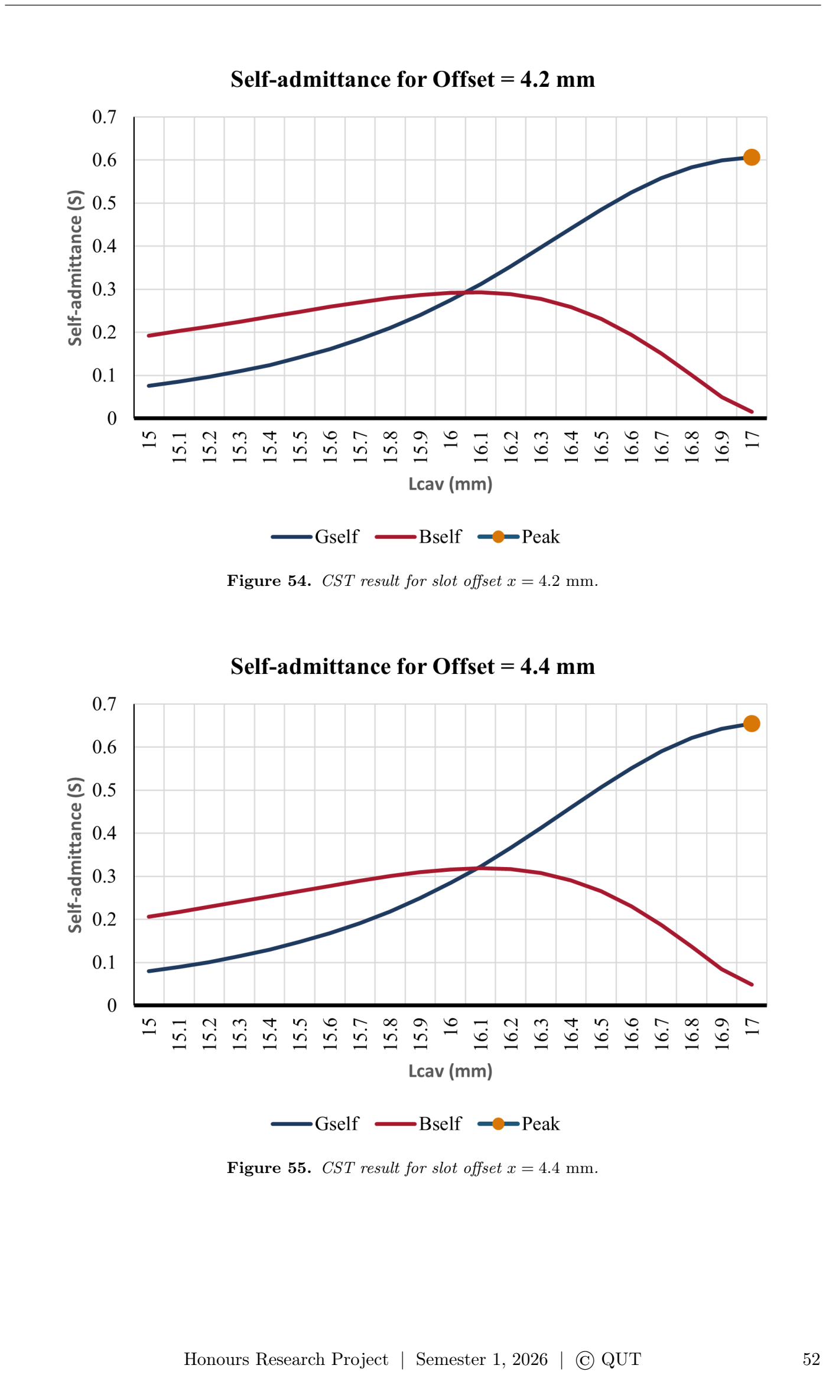
[picture p57: page 53]

Figure 54. CST result for slot offset x = 4.2 mm.

Figure 55. CST result for slot offset x = 4.4 mm.

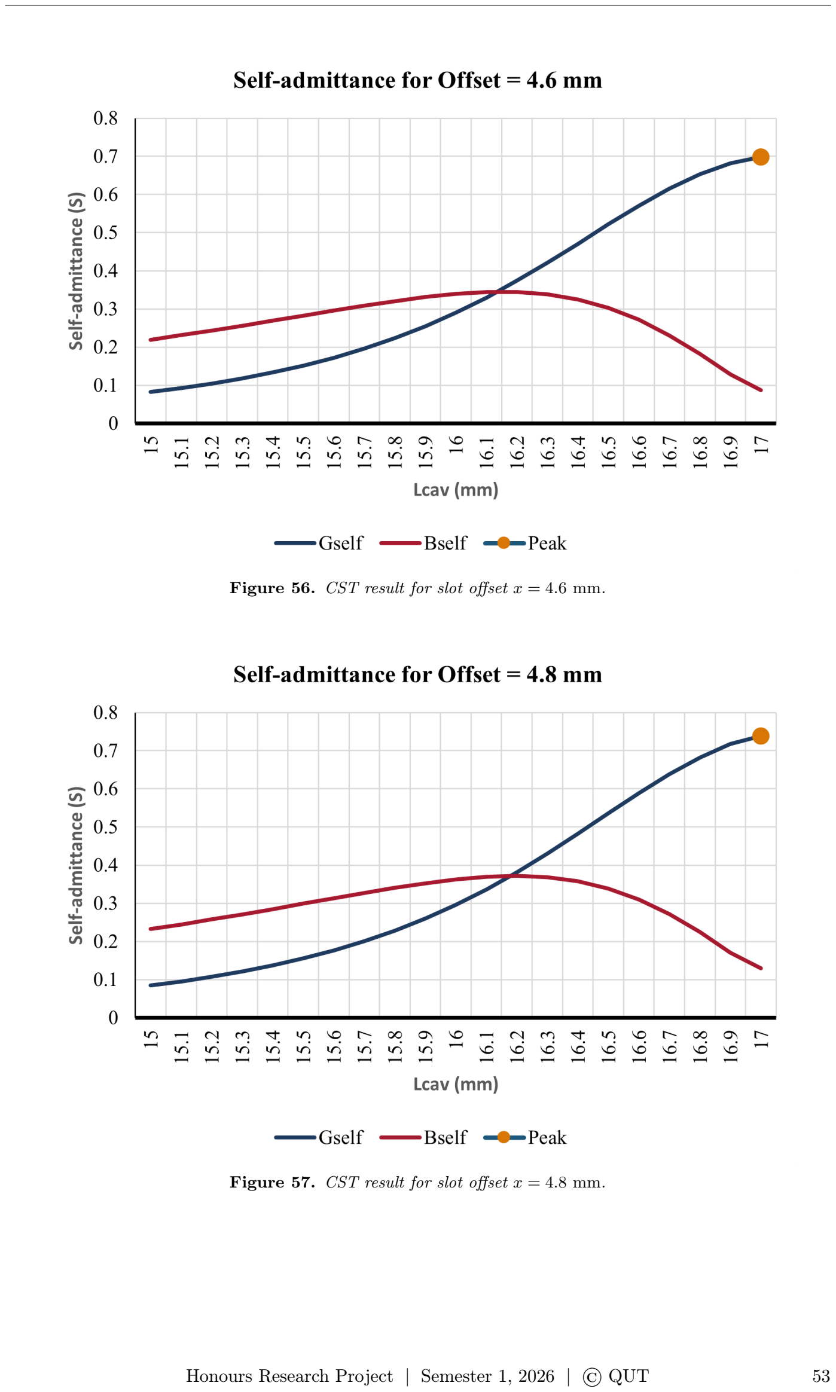
[picture p58: page 54]

Figure 56. CST result for slot offset x = 4.6 mm.

Figure 57. CST result for slot offset x = 4.8 mm.

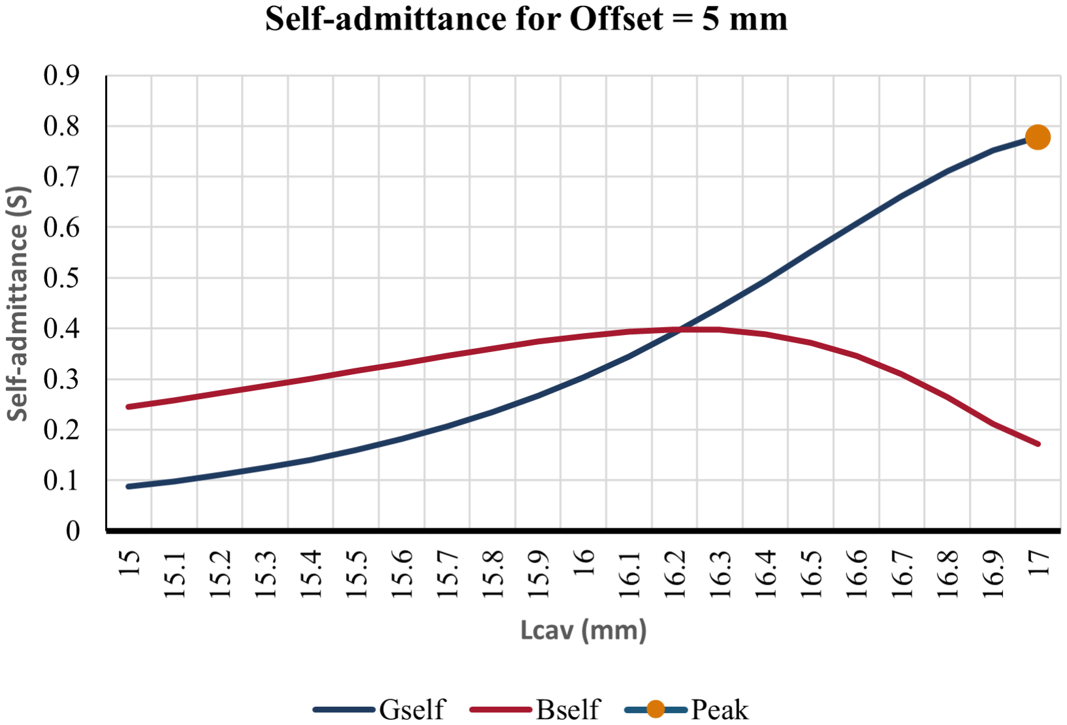
[picture p59: figure]

Figure 58. CST result for slot offset x = 5.0 mm.

## Appendix C: Open-Cavity 6 by 6 Parameter Set

This appendix records the final geometric and excitation parameters used for the open-cavity 6 × 6 slot-array configuration. Unless otherwise stated, all dimensions are given in millimetres.

Table 15

General geometric parameters for the open-cavity 6 × 6 configuration.

Parameter | Value | Parameter | Value
am | 22.860 | ab | 22.860
ac | 12.000 | bm | 10.160
bb | 10.160 | bc | 5.000
cc | 18.000 | t | 1.270
tbase | 5.000 | w | 1.5875
dm | 24.315 | db | 24.315
sides | 30.000 | ends | 30.000
t1 | 1.455 | λ10,m | 48.630
λ10,b | 48.630 | – | –

Table 16

Cavity-slot offset values X

cav
t,n for the open-cavity 6 × 6 array.
Row t | n = 1 | n = 2 | n = 3 | n = 4 | n = 5 | n = 6
1 | 1.293 | -1.925 | 2.764 | -2.764 | 1.925 | -1.293
2 | 1.348 | -2.084 | 2.801 | -2.801 | 2.084 | -1.348
3 | 1.324 | -1.848 | 2.460 | -2.460 | 1.848 | -1.324
4 | 1.320 | -1.840 | 2.495 | -2.495 | 1.840 | -1.320
5 | 1.350 | -2.088 | 2.784 | -2.784 | 2.088 | -1.350
6 | 1.295 | -1.932 | 2.745 | -2.745 | 1.932 | -1.295

Table 17

Cavity-slot length values L

cav
t,n for the open-cavity 6 × 6 array.
Row t | n = 1 | n = 2 | n = 3 | n = 4 | n = 5 | n = 6
1 | 16.007 | 16.156 | 16.323 | 16.323 | 16.156 | 16.007
2 | 15.832 | 15.961 | 16.053 | 16.053 | 15.961 | 15.832
3 | 15.803 | 15.912 | 16.075 | 16.075 | 15.912 | 15.803
4 | 15.802 | 15.911 | 15.997 | 15.997 | 15.911 | 15.802
5 | 15.833 | 15.961 | 16.131 | 16.131 | 15.961 | 15.833
6 | 16.008 | 16.157 | 16.277 | 16.277 | 16.157 | 16.008

Table 18

Coupling-slot angular and length parameters for the open-cavity configuration.

Slot Index | θn (deg) Ln (mm)
1 | 6.879 | 15.775
2 | -13.686 | 15.786
3 | 17.060 | 15.792
4 | -17.155 | 15.792
5 | 13.660 | 15.786
6 | -6.858 | 15.775

## Appendix D: Spline-Based 6 by 6 Slot-Array Synthesis Code

This appendix provides the MATLAB script used to generate the open-cavity 6×6 slot-array parameter set from the single-slot CST sweep data. The script reads the CST-derived lookup table, extracts representative resonant design points, constructs spline interpolation functions, and generates the corresponding cavity-slot offsets and cavity-slot lengths for the array configuration.

1 | %% Spline - Based 6x6 Slot Array Synthesis from Single - Slot CST Data
2 | % Excel file :
3 | % OPEN_SLOT_CAVITY ( SIM2 ). xlsm
4 | %
5 | % Purpose :
6 | % Uses the single - slot CST sweep as a lookup table , then applies spline
7 | % interpolation to generate the cavity - slot offset and length values for a
8 | % 6 x 6 slotted waveguide array .

9
10 clear ; clc ; close all ;

11
12 | %% ------------------------------------------------------------------------
13 | % | 1. USER SETTINGS
14 | % -------------------------------------------------------------------------

15
16 | inputFile = " OPEN_SLOT_CAVITY ( SIM2 ) . xlsm ";
17 | sheetName = " DATA ";

18
19 outputFolder = " single_slot_outputs ";

20
21 | if ~ exist ( outputFolder , " dir ")
22 | mkdir ( outputFolder );
23 | end

24
25 | latexFile = fullfile ( outputFolder , " spline_generated_6x6_slot_table . tex ") ;
26 | csvFile | = fullfile ( outputFolder , " spline_generated_6x6_slot_table . csv ") ;

27
28 | %% ------------------------------------------------------------------------
29 | % | 2. READ EXCEL DATA
30 | % -------------------------------------------------------------------------

31
32 | if ~ isfile ( inputFile )
33 | error (" Could not find Excel file : %s", inputFile );
34 | end

35
36 | data = readtable ( inputFile , ...
37 | " Sheet ", sheetName , ...
38 | " VariableNamingRule " , " preserve ") ;

39
40 | disp (" Excel file loaded successfully .") ;
41 | disp (" Available columns :") ;
42 | disp ( data . Properties . VariableNames ’) ;

43
44 | %% ------------------------------------------------------------------------
45 | % | 3. EXTRACT SINGLE - SLOT CST LOOKUP DATA
46 | % -------------------------------------------------------------------------

47
48 | offset_raw = data .(" Offset ") ;
49 | Lcav_raw | = data .(" L= Lcav ") ;
50 | Gself_raw | = data .(" Gself ") ;
51 | Bself_raw | = data .(" Bself ") ;

52
53 | validRows = ~ isnan ( offset_raw ) & ~ isnan ( Lcav_raw ) & ...
54 | ~ isnan ( Gself_raw ) & ~ isnan ( Bself_raw );

55
56 | offset_raw = offset_raw ( validRows );
57 | Lcav_raw | = Lcav_raw ( validRows ) ;
58 | Gself_raw | = Gself_raw ( validRows );
59 | Bself_raw | = Bself_raw ( validRows );

60
61 offset_values = sort ( unique ( offset_raw )) ;

62
63 | %% ------------------------------------------------------------------------
64 | % | 4. REDUCE EACH OFFSET SWEEP TO A REPRESENTATIVE DESIGN POINT
65 | % -------------------------------------------------------------------------
66 | % For each offset , select the Lcav value where Gself is maximum .
67 | % This creates a single - slot design curve :
68 | %
69 | % offset -> peak Gself
70 | % offset -> Lcav at peak Gself
71 | %
72 | % This is the curve that will be used for spline interpolation .

73
74 | peak_Lcav | = NaN ( size ( offset_values ) );
75 | peak_Gself = NaN( size ( offset_values ) );
76 | peak_Bself = NaN( size ( offset_values ) );

77
78 for k = 1: length ( offset_values )

79

80 | x_current = offset_values (k );

81
82 | idx = offset_raw == x_current ;

83
84 | L_local = Lcav_raw ( idx ) ;
85 | G_local = Gself_raw ( idx );
86 | B_local = Bself_raw ( idx );

87
88 | [ Gmax , imax ] = max( G_local );

89
90 | peak_Lcav (k) | = L_local ( imax );
91 | peak_Gself (k ) = Gmax ;
92 | peak_Bself (k ) = B_local ( imax );

93
94 end

95
96 | %% ------------------------------------------------------------------------
97 | % | 5. BUILD SPLINE LOOKUP CURVES
98 | % -------------------------------------------------------------------------
99 | % Forward curves :
100 | % | offset -> peak Gself
101 | % | offset -> peak Lcav
102 | %
103 | % Inverse curve :
104 | % | target Gself -> offset
105 | %
106 | % The inverse curve is what creates the slot positions from desired
107 | % excitation values .

108
109 | F_G_from_x = griddedInterpolant ( offset_values , peak_Gself , " spline " , " none ") ;
110 | F_L_from_x = griddedInterpolant ( offset_values , peak_Lcav , | " spline " , " none ") ;

111
112 | % For inverse interpolation , peak_Gself must be monotonic .
113 | % Sort by peak_Gself to create G -> x mapping .
114 | [ peak_G_sorted , sortIdx ] = sort ( peak_Gself );
115 | offset_sorted_by_G = offset_values ( sortIdx );

116
117 | F_x_from_G = griddedInterpolant ( peak_G_sorted , offset_sorted_by_G , ...
118 | " spline " , " none ") ;

119
120 | %% ------------------------------------------------------------------------
121 | % | 6. DEFINE 6x6 ARRAY EXCITATION DISTRIBUTION
122 | % -------------------------------------------------------------------------
123 | % The supervisor - style table is not created by using one global optimum .
124 | % Instead , each array element gets its own required excitation .
125 | %
126 | % Here , a symmetric aperture weighting is used . The centre columns radiate
127 | % more strongly than the edge columns . A row taper is also applied .
128 | %
129 | % You can tune these values until they match the desired array distribution .

130
131 | % Column excitation profile across the 6 slots .
132 | % Symmetric about the centre .
133 | columnWeight = [0.25 0.48 1.00 1.00 0.48 0.25];

134
135 | % Row excitation profile along the 6 rows .
136 | % Nearly symmetric , with small variation across rows .
137 | rowWeight = [1.00 0.92 0.83 0.82 0.93 1.00];

138
139 | % 6x6 target excitation matrix
140 | targetWeight = rowWeight (:) * columnWeight (:) . ’;

141
142 | % Scale target weights into the valid peak - Gself range from the single - slot data .
143 | % This controls the minimum and maximum slot strengths used in the array .

144
145 | G_min_target = 0.05;
146 | G_max_target = 0.27;

147
148 | targetG = G_min_target + ...
149 | ( G_max_target - G_min_target ) .* ...
150 | ( targetWeight - min ( targetWeight (:) )) ./ ...
151 | (max ( targetWeight (:) ) - min ( targetWeight (:) ));

152
153 | %% ------------------------------------------------------------------------
154 | % | 7. GENERATE 6x6 CAVITY - SLOT OFFSETS USING INVERSE SPLINE
155 | % -------------------------------------------------------------------------

156
157 | xcav_mag = NaN (6 ,6) ;
158 | Lcav_array = NaN (6 ,6) ;
159 | G_check = NaN (6 ,6) ;

160
161 | for t = 1:6
162 | for n = 1:6

163
164 | G_target = targetG (t , n);

165
166 | % Inverse spline : target conductance -> offset magnitude

167 | x_mag = F_x_from_G ( G_target );

168
169 | % Forward spline : offset magnitude -> Lcav at selected curve
170 | L_val = F_L_from_x ( x_mag ) ;

171
172 | xcav_mag (t ,n) = x_mag ;
173 | Lcav_array (t ,n ) = L_val ;
174 | G_check (t , n) = F_G_from_x ( x_mag );

175
176 | end
177 | end

178
179 | %% ------------------------------------------------------------------------
180 | % | 8. ASSIGN OFFSET SIGNS ABOUT THE WAVEGUIDE CENTRELINE
181 | % -------------------------------------------------------------------------
182 | % The single - slot CST sweep usually gives offset magnitude .
183 | % The sign is assigned according to the physical slot placement .
184 | %
185 | % This sign pattern matches the alternating / mirrored style seen in the
186 | % supervisor table .

187
188 | signPattern = [
189 | 1 -1 | 1 -1 | 1 -1;
190 | 1 -1 | 1 -1 | 1 -1;
191 | 1 -1 | 1 -1 | 1 -1;
192 | 1 -1 | 1 -1 | 1 -1;
193 | 1 -1 | 1 -1 | 1 -1;
194 | 1 -1 | 1 -1 | 1 -1
195 | ];

196
197 xcav_array = signPattern .* xcav_mag ;

198
199 | %% ------------------------------------------------------------------------
200 | % | 9. COUPLING SLOT VALUES
201 | % -------------------------------------------------------------------------
202 | % These are normally generated from a separate coupling - slot synthesis step .
203 | % Here , the supervisor - style values are included directly .

204
205 | theta_t = [
206 | 6.879;
207 | -13.686;
208 | 17.060;
209 | -17.155;
210 | 13.660;
211 | -6.858
212 | ];

213
214 | l_t = [
215 | 15.775;
216 | 15.786;
217 | 15.792;
218 | 15.792;
219 | 15.786;
220 | 15.775
221 | ];

222
223 | %% ------------------------------------------------------------------------
224 | % | 10. SAVE CSV OUTPUT
225 | % -------------------------------------------------------------------------

226
227 | t_col = repelem ((1:6) ’, 6) ;
228 | n_col = repmat ((1:6) ’, 6 , 1) ;

229
230 | xcav_col = reshape ( xcav_array .’, [] , 1) ;
231 | Lcav_col = reshape ( Lcav_array .’, [] , 1) ;
232 | Gtarget_col = reshape ( targetG .’, [] , 1) ;
233 | Gcheck_col | = reshape ( G_check .’, [] , 1) ;

234
235 | outputTable = table ( ...
236 | t_col , ...
237 | n_col , ...
238 | xcav_col , ...
239 | Lcav_col , ...
240 | Gtarget_col , ...
241 | Gcheck_col , ...
242 | ’ VariableNames ’, {’t’, ’n’, ’xcav_mm ’, ’Lcav_mm ’, ...
243 | ’ target_Gself ’, ’ spline_Gself ’} ...
244 | );

245
246 writetable ( outputTable , csvFile );

247
248 | %% ------------------------------------------------------------------------
249 | % | 11. GENERATE LATEX TABLE
250 | % -------------------------------------------------------------------------

251
252 fid = fopen ( latexFile , " w ") ;

253

if fid == -1
error (" Could not create LaTeX file .") ;

end

fprintf ( fid , "\\ begin { table }[ H ]\ n ") ;
fprintf ( fid , "\\ centering \n ") ;
fprintf ( fid , "\\ caption { Cavity slot and coupling slot dimensions .}\ n ") ; fprintf ( fid , "\\ label { tab : cavity_coupling_slot_dimensions }\ n ") ;
fprintf ( fid , "\\ scriptsize \n ") ;
fprintf ( fid , "\\ setlength {\\ tabcolsep }{3 pt }\ n ") ;
fprintf ( fid , "\\ renewcommand {\\ arraystretch }{1.00}\ n\ n ") ;

fprintf ( fid , "\\ begin { tabularx }{\\ columnwidth }{\ n ") ;
fprintf ( fid , " >{\\ centering \\ arraybackslash }p {0.20\\ columnwidth }\ n ") ; fprintf ( fid , " >{\\ centering \\ arraybackslash }p {0.38\\ columnwidth }\ n ") ; fprintf ( fid , " >{\\ centering \\ arraybackslash }p {0.38\\ columnwidth }}\ n ") ;

fprintf ( fid , "\\ hline \\ hline \ n ") ;
fprintf ( fid , "\\ textbf { Element } &\ n ") ;
fprintf ( fid , "\\ textbf { Cavity slot offset } &\ n ") ;
fprintf ( fid , "\\ textbf { Cavity slot length } \\\\\ n ") ;
fprintf ( fid , "\\ textbf { index } &\ n ") ;
fprintf ( fid , "\\ textbf { $x ^{\\ mathrm { cav }} _{t , n}$ ( mm )} &\ n ") ; fprintf ( fid , "\\ textbf { $L ^{\\ mathrm { cav }} _{t , n}$ ( mm )} \\\\\ n ") ; fprintf ( fid , "\\ hline \n ") ;

for t = 1:6
for n = 1:6

isHighlighted = ( t == 3 && n == 3) || ... (t == 3 && n == 4) || ...
(t == 4 && n == 3) || ...
(t == 4 && n == 4) ;

if isHighlighted
fprintf ( fid , "\\ cellcolor { SlotHighlight }%d ,%d &\n", t, n);
fprintf ( fid , "\\ cellcolor { SlotHighlight }% .3f &\n", xcav_array (t,n)); fprintf ( fid , "\\ cellcolor { SlotHighlight }%.3f \\\\\ n" , Lcav_array (t,n)); else
fprintf ( fid , "%d ,%d & % .3f & %.3f \\\\\ n" , ...
t , n , xcav_array (t ,n) , Lcav_array (t ,n) );

end

end

end

fprintf ( fid , "\\ hline \\ hline \ n ") ;
fprintf ( fid , "\\ textbf { Slot } &\ n ") ;
fprintf ( fid , "\\ textbf { Coupling slot angle } &\ n ") ; fprintf ( fid , "\\ textbf { Coupling slot length } \\\\\ n ") ; fprintf ( fid , "\\ textbf { index } &\ n ") ;
fprintf ( fid , "\\ textbf {$ \\ theta_t$ ( deg .) } &\ n ") ; fprintf ( fid , "\\ textbf { $l_t$ ( mm ) } \\\\\ n ") ;
fprintf ( fid , "\\ hline \n ") ;

for t = 1:6
fprintf ( fid , "%d & % .3f & %.3 f \\\\\ n", t, theta_t (t), l_t(t));

end

fprintf ( fid , "\\ hline \\ hline \ n ") ;
fprintf ( fid , "\\ end { tabularx }\ n\n ") ; fprintf ( fid , "\\ vspace { -2 mm }\ n ") ; fprintf ( fid , "\\ end { table }\ n ") ;

fclose ( fid );

%% ------------------------------------------------------------------------
321 | % | 12. PLOTS FOR CHECKING THE SPLINE PROCESS
% -------------------------------------------------------------------------

xFine = linspace ( min( offset_values ) , max ( offset_values ) , 500) ;
Gfine = F_G_from_x ( xFine ) ;
Lfine = F_L_from_x ( xFine ) ;

figure (’Color ’,’w’);
plot ( offset_values , peak_Gself , ’ko ’, ’ MarkerFaceColor ’, ’w’); hold on ;
plot ( xFine , Gfine , ’LineWidth ’, 1.5) ;
xlabel (’Cavity slot offset , x^{ cav } (mm)’, ’ Interpreter ’, ’tex ’);
ylabel (’Peak G_{ self }’, ’ Interpreter ’, ’tex ’);
title (’Spline Interpolation : Offset to Peak Conductance ’, ’ Interpreter ’, ’tex ’); legend (’Single - slot CST points ’, ’Spline curve ’, ’Location ’, ’best ’);
grid on ;
set (gca , ’FontName ’, ’Times New Roman ’, ’FontSize ’, 11) ;

exportgraphics (gcf , fullfile ( outputFolder , ...
| | " spline_offset_to_Gself . png ") , ’Resolution ’, 600) ;

341
342 | figure (’Color ’,’w’);
343 | plot ( offset_values , peak_Lcav , ’ko ’, ’ MarkerFaceColor ’, ’w’) ;
344 | hold on ;
345 | plot ( xFine , Lfine , ’LineWidth ’, 1.5) ;
346 | xlabel (’Cavity slot offset , x^{ cav } (mm)’, ’ Interpreter ’, ’tex ’);
347 | ylabel (’Selected cavity slot length , L^{ cav} (mm)’, ’Interpreter ’, ’tex ’);
348 | title (’Spline Interpolation : Offset to Cavity Slot Length ’, ’ Interpreter ’, ’tex ’);
349 | legend (’Single - slot CST points ’, ’Spline curve ’, ’Location ’, ’best ’);
350 | grid on ;
351 | set (gca , ’FontName ’, ’Times New Roman ’, ’FontSize ’, 11) ;

352
353 | exportgraphics (gcf , fullfile ( outputFolder , ...
354 | " spline_offset_to_Lcav . png ") , ’Resolution ’, 600) ;

355
356 | figure (’Color ’,’w’);
357 | imagesc ( abs ( xcav_array ));
358 | axis equal tight ;
359 | colorbar ;
360 | xlabel (’Column index , n’) ;
361 | ylabel (’Row index , t’);
362 | title (’Generated 6x6 Cavity Slot Offset Magnitudes ’, ’ Interpreter ’, ’tex ’) ;
363 | set (gca , ’FontName ’, ’Times New Roman ’, ’FontSize ’, 11) ;

364
365 | exportgraphics (gcf , fullfile ( outputFolder , ...
366 | " generated_6x6_offset_map . png ") , ’Resolution ’, 600) ;

367
368 | %% ------------------------------------------------------------------------
369 | % | 13. DISPLAY OUTPUT
370 | % -------------------------------------------------------------------------

371
372 | fprintf ("\ n ====================================================\ n ") ;
373 | fprintf (" Spline - Based 6 x6 Slot Synthesis Complete \n ") ;
374 | fprintf ("====================================================\ n ") ;
375 | fprintf (" Input Excel file : %s\n" , inputFile );
376 | fprintf (" Sheet used : | %s\n", sheetName );
377 | fprintf (" CSV output : | %s\n", csvFile );
378 | fprintf (" LaTeX output : | %s\n", latexFile );
379 | fprintf ("====================================================\ n\n ") ;

380
381 | disp (" Generated x_cav matrix :") ;
382 | disp ( xcav_array );

383
384 | disp (" Generated L_cav matrix :") ;
385 | disp ( Lcav_array );

Listing 1: MATLAB script for spline-based 6 × 6 slot-array synthesis from single-slot CST data.

## Appendix E: Radiated Curve Integrated Electric-Field Data

This appendix records the integrated radiated electric-field values extracted from the CST curve-radiation data for the open-cavity 6 × 6 slot-array configuration. The real and imaginary components are tabulated directly from the exported CST records. The magnitude and phase tables are included as derived quantities for compact comparison across the array aperture.

Table 19

Real component of the integrated radiated electric field, ℜ{Erad,t,n}.

Row t | n = 1 | n = 2 | n = 3 | n = 4 | n = 5 | n = 6
1 | 1.431 | 1.558 | 2.190 | 1.648 | 1.964 | 1.226
2 | 3.054 | 4.102 | 5.318 | 4.756 | 4.457 | 2.898
3 | 4.016 | 5.904 | 7.000 | 6.831 | 5.874 | 4.119
4 | 4.092 | 5.899 | 6.913 | 7.012 | 5.846 | 3.975
5 | 2.916 | 4.466 | 4.938 | 5.375 | 4.122 | 3.031
6 | 1.242 | 1.998 | 1.806 | 2.341 | 1.430 | 1.449

Table 20

Imaginary component of the integrated radiated electric field, ℑ{Erad,t,n}.

Row t | n = 1 | n = 2 | n = 3 | n = 4 | n = 5 | n = 6
1 | -1.215 | -2.300 | -3.730 | -3.471 | -2.381 | -1.142
2 | -1.974 | -4.400 | -6.255 | -6.780 | -4.040 | -2.161
3 | -2.543 | -5.235 | -7.799 | -8.266 | -5.021 | -2.617
4 | -2.775 | -5.228 | -8.654 | -8.240 | -5.634 | -2.724
5 | -2.000 | -3.786 | -6.294 | -5.878 | -4.209 | -1.942
6 | -1.155 | -2.433 | -3.494 | -3.758 | -2.422 | -1.197

Table 21

Magnitude of the integrated radiated electric field, |Erad,t,n|.

Row t | n = 1 | n = 2 | n = 3 | n = 4 | n = 5 | n = 6
1 | 1.877 | 2.778 | 4.325 | 3.843 | 3.087 | 1.675
2 | 3.636 | 6.016 | 8.210 | 8.282 | 6.015 | 3.615
3 | 4.753 | 7.891 | 10.480 | 10.723 | 7.728 | 4.880
4 | 4.944 | 7.883 | 11.076 | 10.820 | 8.119 | 4.819
5 | 3.535 | 5.855 | 8.000 | 7.965 | 5.891 | 3.600
6 | 1.696 | 3.148 | 3.933 | 4.427 | 2.813 | 1.880

Table 22

Phase of the integrated radiated electric field, ̸ Erad,t,n in degrees.

Row t | n = 1 | n = 2 | n = 3 | n = 4 | n = 5 | n = 6
1 | -40.349 | -55.886 | -59.580 | -64.604 | -50.481 | -42.976
2 | -32.886 | -47.006 | -49.632 | -54.950 | -42.190 | -36.711
3 | -32.349 | -41.564 | -48.091 | -50.430 | -40.527 | -32.437
4 | -34.140 | -41.551 | -51.379 | -49.600 | -43.945 | -34.417
5 | -34.441 | -40.285 | -51.880 | -47.559 | -45.600 | -32.640
6 | -42.930 | -50.601 | -62.673 | -58.078 | -59.440 | -39.539

## Appendix F: C++ Code for Aperture Voltage Analysis

This appendix provides the C++ program used to process the complex aperture-voltage data for the 6 × 6 slot-array configuration. The program stores the real and imaginary components of Vapp, computes the corresponding magnitude and phase distributions, evaluates the centre-four average response, normalises the aperture-voltage magnitude, and calculates phase deviation across the array.

1 | // vapp_analysis . cpp
2 | // Purpose : Analyze 6x6 complex Vapp data (Re + i*Im), compute magnitude /phase ,
3 | // | center -4 averages , normalized magnitude , and phase deviation grids .
4 | //
5 | // Build :
6 | // | g++ -O2 -std =c ++17 vapp_analysis . cpp -o vapp_analysis . exe
7 | //
8 | // Run :
9 | // | ./ vapp_analysis .exe

10
11 | # include < iostream >
12 | # include < iomanip >
13 | # include < cmath >
14 | # include < complex >
15 | # include < fstream >

16
17 | int main () {
18 | | constexpr int N = 6;
19 | | const double RAD2DEG = 180.0 / std :: acos ( -1.0) ;

20
21 | | std :: ofstream outFile (" vapp_analysis_output .txt ");
22 | | if (! outFile ) {
23 | | std :: cerr << " Error : Could not create output file "
24 | | << "’ vapp_analysis_output . txt ’.\n";
25 | | return 1;
26 | }

27
28 | | // Re[ Vapp ] with i = row 1..6 and j = column 1..6
29 | | const double Re [N ][ N] = {
30 | | {1.4306804942992 , 1.5578194451661 , 2.1900688904949 ,
31 | | 1.6480174134865 , 1.9642274168938 , 1.2255279350535} ,
32 | | {3.0535856389074 , 4.1024130928465 , 5.3176739858674 ,
33 | | 4.7560391046071 , 4.4568883051169 , 2.8979241354045} ,
34 | | {4.0155145086903 , 5.9038670153139 , 6.9997624474471 ,
35 | | 6.8310145760952 , 5.8737174719142 , 4.1186668501635} ,
36 | | {4.0919447574590 , 5.8991211347727 , 6.9134569903258 ,
37 | | 7.0123716040461 , 5.8456113378081 , 3.9752391497389} ,
38 | | {2.9157367925029 , 4.4662918463924 , 4.9382998974743 ,
39 | | 5.3748797986801 , 4.1220500573594 , 3.0313798325779} ,
40 | | {1.2417566637163 , 1.9981187617230 , 1.8056540605840 ,
41 | | 2.3408194825198 , 1.4303270226417 , 1.4494986692941}
42 | | };

43
44 | | // Im[ Vapp ] with i = row 1..6 and j = column 1..6
45 | | const double Im [N ][ N] = {
46 | | { -1.2154238411443 , -2.2996391058387 , -3.7298772507791 ,
47 | | -3.4713106709322 , -2.3812305924632 , -1.1418836379064} ,
48 | | { -1.9743629597035 , -4.4002507636670 , -6.2552735849317 ,
49 | | -6.7797270745564 , -4.0398089827427 , -2.1609317611943} ,
50 | | { -2.5433471044723 , -5.2351480614382 , -7.7989529044899 ,
51 | | -8.2660449942037 , -5.0214958504663 , -2.6174743859838} ,
52 | | { -2.7746599421165 , -5.2284420535237 , -8.6539805804671 ,
53 | | -8.2396121540260 , -5.6341608116956 , -2.7236335369846} ,
54 | | { -1.9995057080881 , -3.7856949723058 , -6.2936020413673 ,
55 | | -5.8777243383082 , -4.2092328652306 , -1.9416434072191} ,
56 | | { -1.1551362884020 , -2.4326532260321 , -3.4943215068759 ,
57 | | -3.7575262169703 , -2.4224560816959 , -1.1965266421293}
58 | | };

59
60 | | double mag [ N ][ N ];
61 | | double phaseDeg [N ][ N ];

62
63 | | for ( int i = 0; i < N ; ++ i) {
64 | | for ( int j = 0; j < N; ++ j) {
65 | | mag [i ][ j] = std :: hypot ( Re [i ][ j], Im [i ][ j ]) ;
66 | | phaseDeg [ i ][ j] = std :: atan2 ( Im [i ][ j] , Re [i ][ j ]) * RAD2DEG ;
67 | | }
68 | }

69
70 | | // Centre - four average :
71 | | // array positions (3 ,3) , (3 ,4) , (4 ,3) , and (4 ,4)
72 | | double magCenter =
73 | | ( mag [2][2] + mag [2][3] + mag [3][2] + mag [3][3]) / 4.0;

74
75 | | double phaseCenter =
76 | | ( phaseDeg [2][2] + phaseDeg [2][3] +
77 | | phaseDeg [3][2] + phaseDeg [3][3]) / 4.0;

78
79 | | auto printGrid = [&]( const char * title , auto & g ,

80 | const char * unit , int prec ) {
81 | std :: cout << "\n === " << title << " ===\ n";
82 | outFile | << "\n === " << title << " ===\ n";

83
84 | std :: cout << " | ";
85 | outFile | << " | ";

86
87 | for ( int j = 1; j <= N; ++ j ) {
88 | std :: cout << std :: setw (12) << ("j=" + std :: to_string (j ));
89 | outFile | << std :: setw (12) << ("j=" + std :: to_string (j ));
90 | }

91
92 | std :: cout << "\n";
93 | outFile | << "\n";

94
95 | for ( int i = 0; i < N; ++ i) {
96 | std :: cout << "i=" << (i + 1) << " | ";
97 | outFile | << "i=" << (i + 1) << " | ";

98
99 | for (int j = 0; j < N; ++ j) {
100 | std :: cout << std :: setw (11)
101 | << std :: fixed << std :: setprecision ( prec )
102 | << g[ i ][ j ] << unit ;

103
104 | outFile << std :: setw (11)
105 | << std :: fixed << std :: setprecision ( prec )
106 | << g[i ][ j] << unit ;
107 | }

108
109 | std :: cout << "\n";
110 | outFile | << "\n";
111 | }
112 | };

113
114 | std :: cout << std :: fixed << std :: setprecision (6) ;
115 | outFile | << std :: fixed << std :: setprecision (6) ;

116
117 | printGrid ("Re[ Vapp ]", Re , "", 6) ;
118 | printGrid ("Im[ Vapp ]", Im , "", 6) ;
119 | printGrid ("| Vapp | Magnitude ", mag , "", 6) ;
120 | printGrid (" Phase Angle ", phaseDeg , " deg ", 2) ;

121
122 | std :: cout << "\n=== Vapp = Re + i Im ===\ n";
123 | outFile | << "\n === Vapp = Re + i Im ===\ n";

124
125 | for ( int i = 0; i < N ; ++ i) {
126 | std :: cout << "i=" << (i + 1) << " | ";
127 | outFile | << "i=" << (i + 1) << " | ";

128
129 | for ( int j = 0; j < N; ++ j) {
130 | char sign = ( Im [i ][ j] >= 0) ? ’+’ : ’-’;

131
132 | std :: cout << std :: setw (8) << std :: fixed
133 | << std :: setprecision (3) << Re [i ][ j]
134 | << " " << sign << " "
135 | << std :: setw (6) << std :: fixed
136 | << std :: setprecision (3) << std :: fabs ( Im [i ][ j ])
137 | << "i | ";

138
139 | outFile << std :: setw (8) << std :: fixed
140 | << std :: setprecision (3) << Re [i ][ j]
141 | << " " << sign << " "
142 | << std :: setw (6) << std :: fixed
143 | << std :: setprecision (3) << std :: fabs ( Im [ i ][ j ])
144 | << "i | ";
145 | }

146
147 | std :: cout << "\n";
148 | outFile | << "\n";
149 | }

150
151 | std :: cout << "\n=== Centre - Four Averages ===\ n";
152 | outFile | << "\n === Centre - Four Averages ===\ n";

153
154 | std :: cout << " Average | Vapp | centre four = "
155 | << magCenter << "\n";
156 | outFile | << " Average | Vapp | centre four = "
157 | << magCenter << "\n";

158
159 | std :: cout << " Average phase centre four = "
160 | << std :: setprecision (4) << phaseCenter << " deg \n";
161 | outFile | << " Average phase centre four = "
162 | << std :: setprecision (4) << phaseCenter << " deg \n";

163
164 | double normMag [N ][ N ];

165
166 | for ( int i = 0; i < N ; ++ i) {

for ( int j = 0; j < N; ++ j) {
normMag [i ][ j] = mag [ i ][ j ] / magCenter ;

}

}

printGrid ("| Vapp (i,j)| / | Vcenter |", normMag , "", 4) ;

double phaseDev [ N ][ N ];

for ( int i = 0; i < N ; ++ i) {
for ( int j = 0; j < N; ++ j) {
phaseDev [ i ][ j ] = phaseDeg [i ][ j] - phaseCenter ;

}

}

printGrid (" Phase deviation from centre ", phaseDev , " deg", 2) ;

std :: cout << "\n=== Sanity Checks ===\ n";
185 | outFile | << "\n === Sanity Checks ===\ n";

double sumDevCenter =
phaseDev [2][2] + phaseDev [2][3] + phaseDev [3][2] + phaseDev [3][3];

double avgNormCenter =
( normMag [2][2] + normMag [2][3] +
normMag [3][2] + normMag [3][3]) / 4.0;

std :: cout << " Sum of centre - four phase deviations : "
| | << std :: scientific << std :: setprecision (3) << sumDevCenter << "\n";

outFile << "Sum of centre - four phase deviations : "
| | << std :: scientific << std :: setprecision (3) << sumDevCenter << "\n";

std :: cout << " Average centre - four normalised magnitude : "
| | << std :: fixed << std :: setprecision (6) << avgNormCenter << "\n";

outFile << " Average centre - four normalised magnitude : "
| | << std :: fixed << std :: setprecision (6) << avgNormCenter << "\n";
| return 0;
}

Listing 2: C++ program used to analyse the complex aperture-voltage distribution of the 6 × 6 slot array.
