chabodmasere/EGH490-Research-Project/Compiled_Data/simulation1/0.875.png

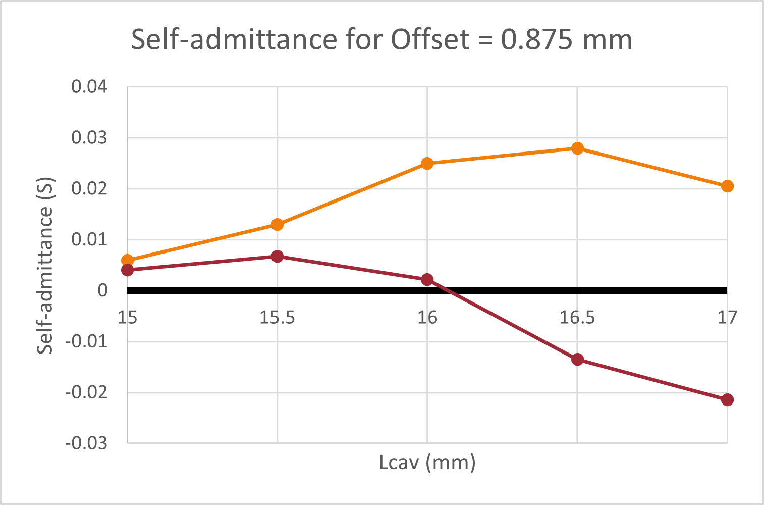
Compiled_Data/simulation1/0.875.png
