chabodmasere/EGH490-Research-Project/Compiled_Data/simulation1/1.70.png

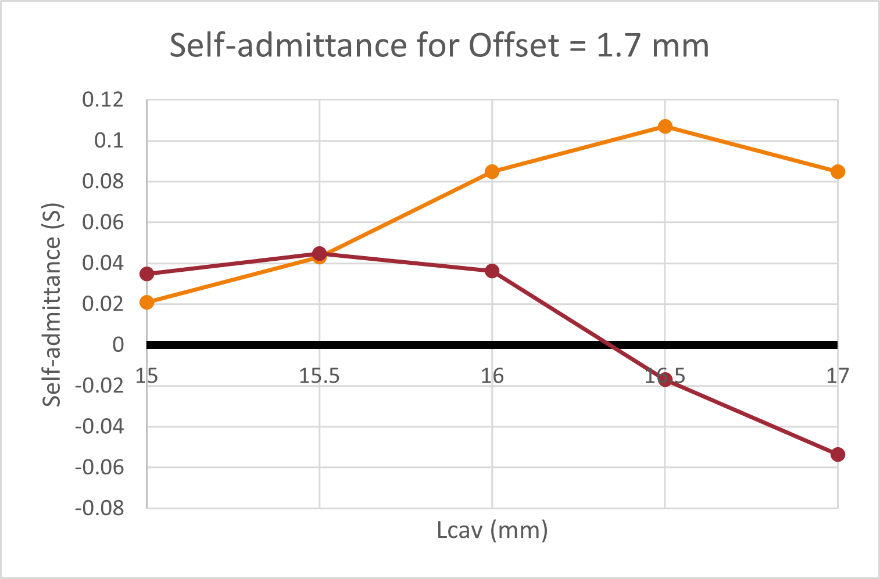
Compiled_Data/simulation1/1.70.png
