chabodmasere/EGH490-Research-Project/Compiled_Data/simulation1/2.80.png

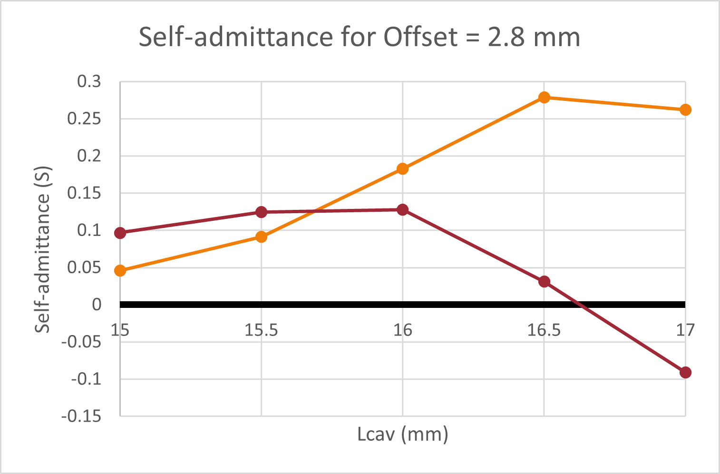
Compiled_Data/simulation1/2.80.png
