chabodmasere/EGH490-Research-Project/Compiled_Data/simulation1/3.35.png

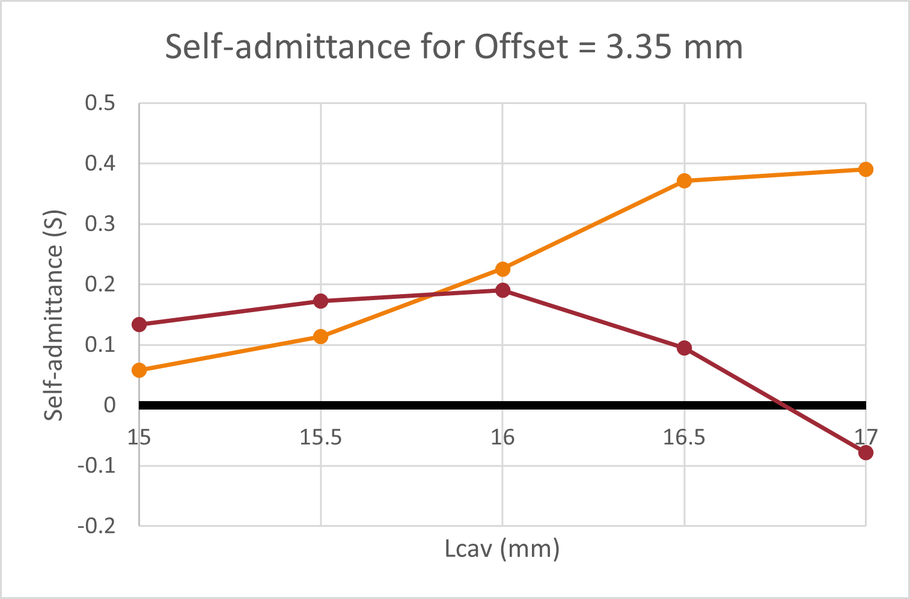
Compiled_Data/simulation1/3.35.png
