chabodmasere/EGH490-Research-Project/Compiled_Data/simulation2/1.0mm.png

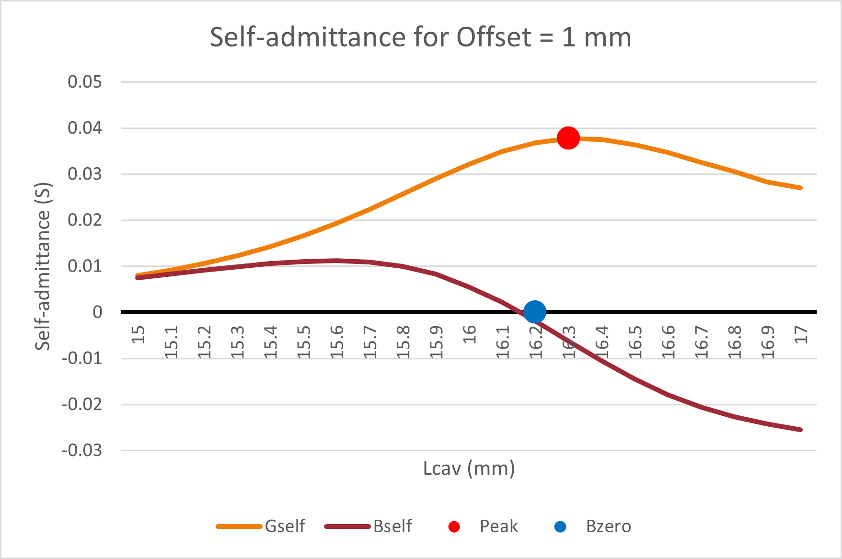
Compiled_Data/simulation2/1.0mm.png
