chabodmasere/EGH490-Research-Project/Compiled_Data/simulation2/1.6mm.png

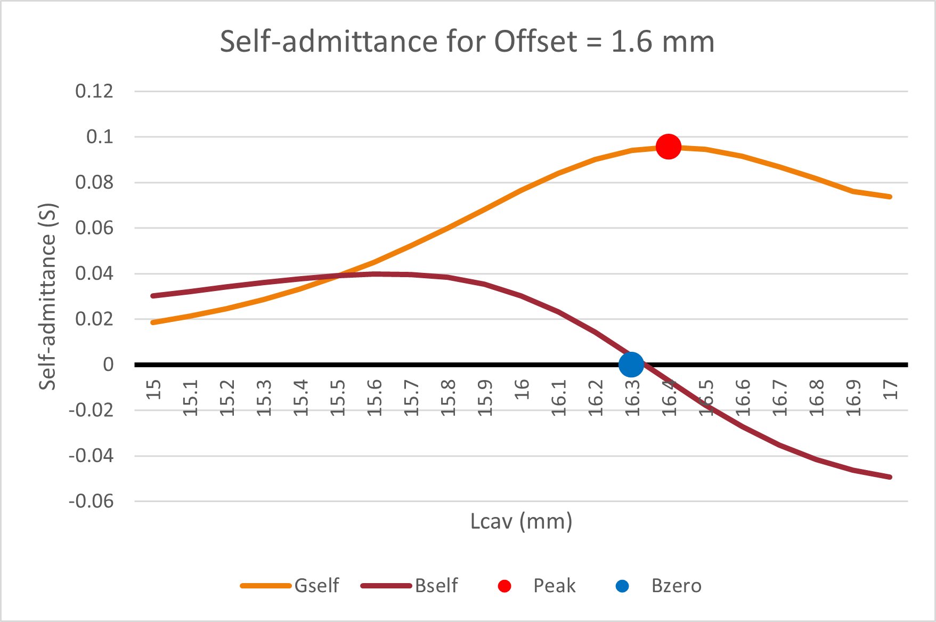
Compiled_Data/simulation2/1.6mm.png
