chabodmasere/EGH490-Research-Project/Compiled_Data/simulation2/2.0mm.png

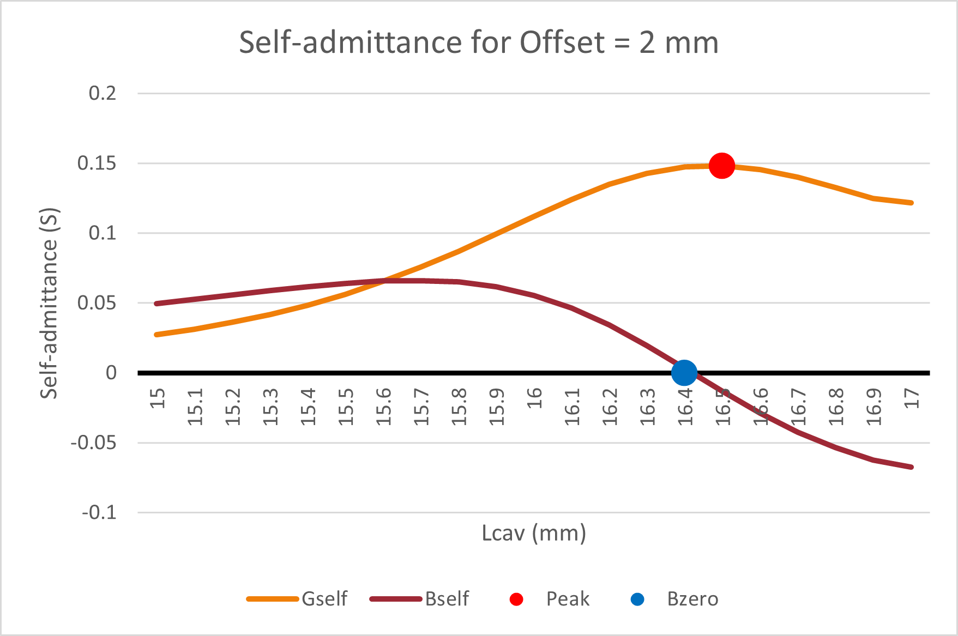
Compiled_Data/simulation2/2.0mm.png
