chabodmasere/EGH490-Research-Project/Compiled_Data/simulation2/3.8mm.png

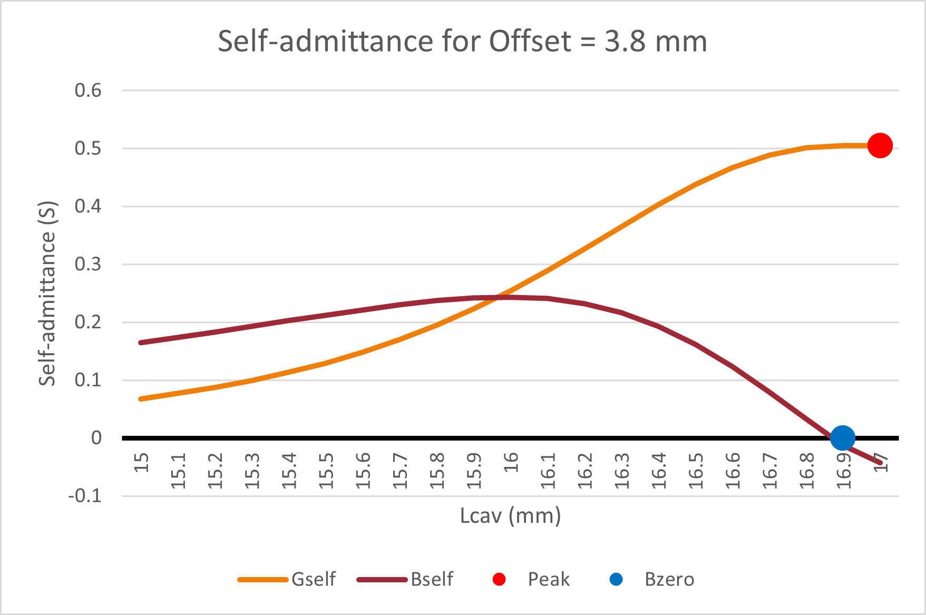
Compiled_Data/simulation2/3.8mm.png
