chabodmasere/EGH490-Research-Project/Compiled_Data/simulation2/4.2mm.png

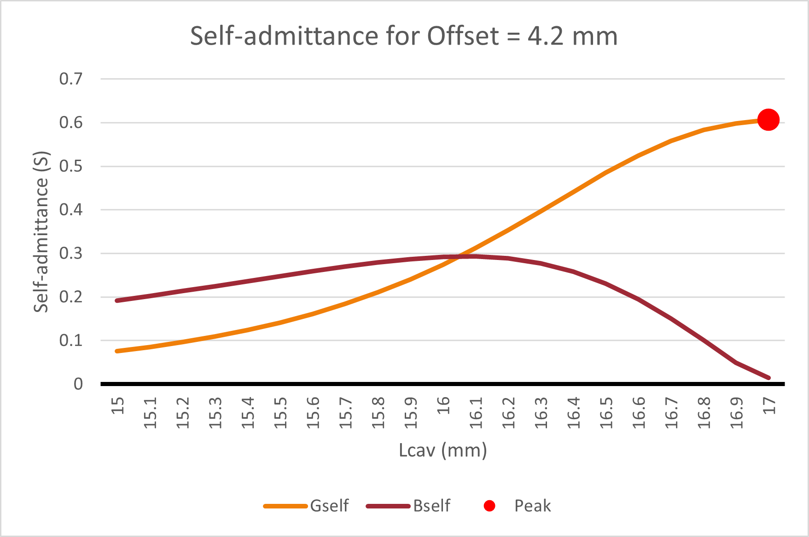
Compiled_Data/simulation2/4.2mm.png
