chabodmasere/EGH490-Research-Project/Compiled_Data/simulation3/images/0.7375mm.png

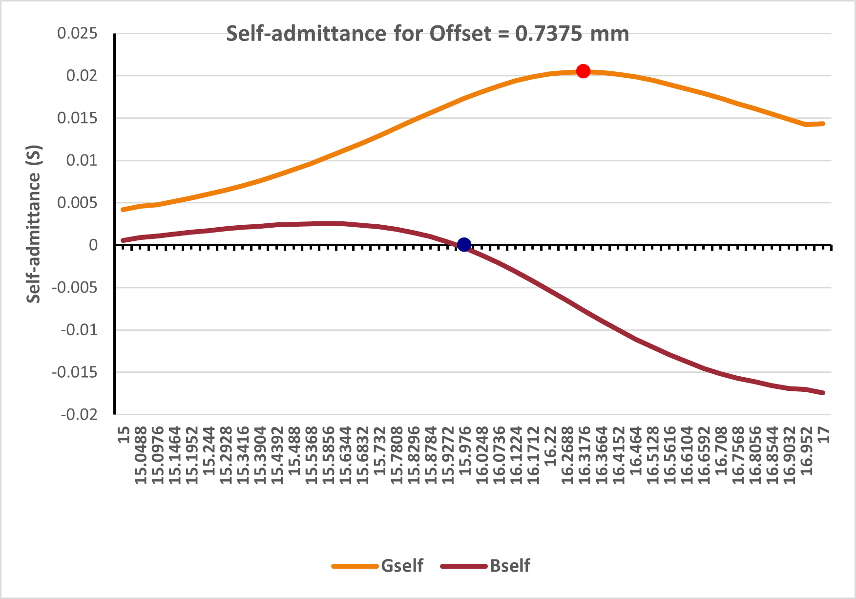
Compiled_Data/simulation3/images/0.7375mm.png
