chabodmasere/EGH490-Research-Project/Compiled_Data/simulation3/images/1.2875mm.png

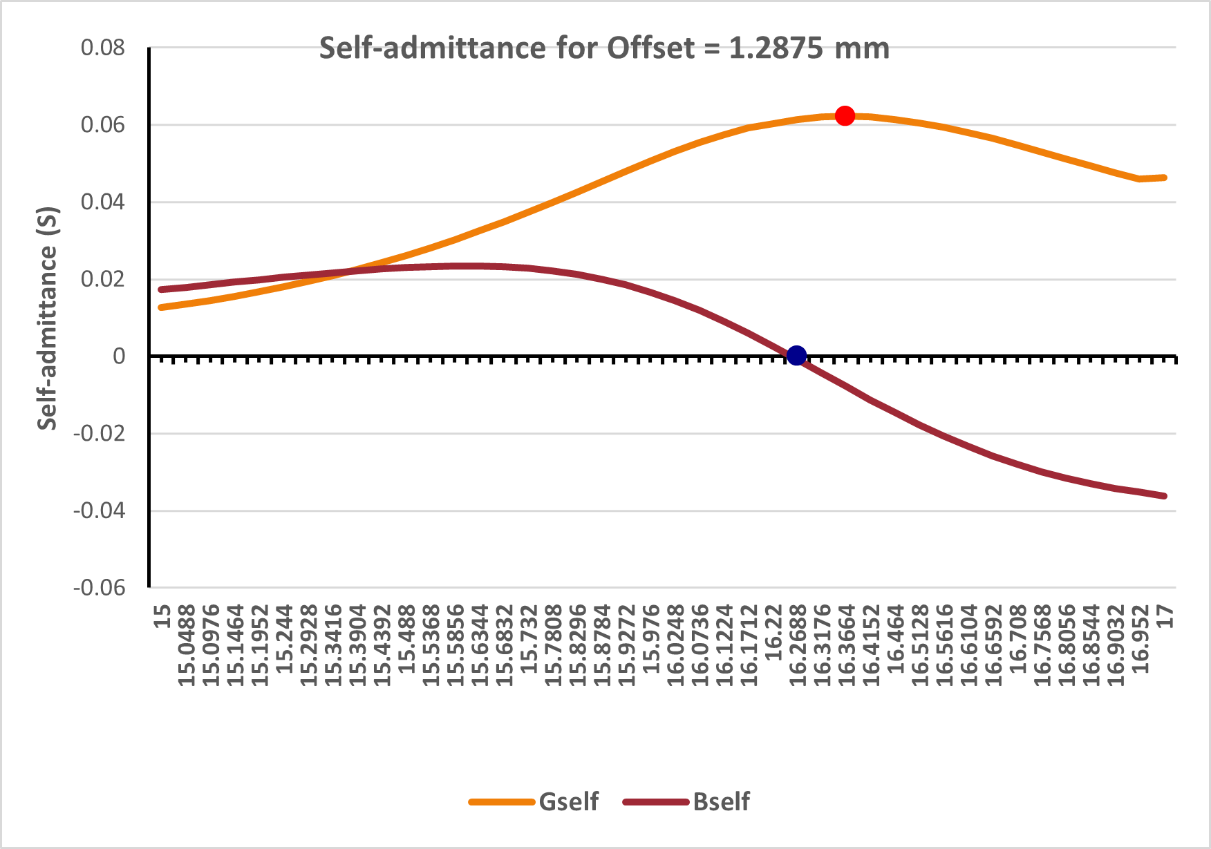
Compiled_Data/simulation3/images/1.2875mm.png
