chabodmasere/EGH490-Research-Project/Compiled_Data/simulation3/images/2.8mm.png

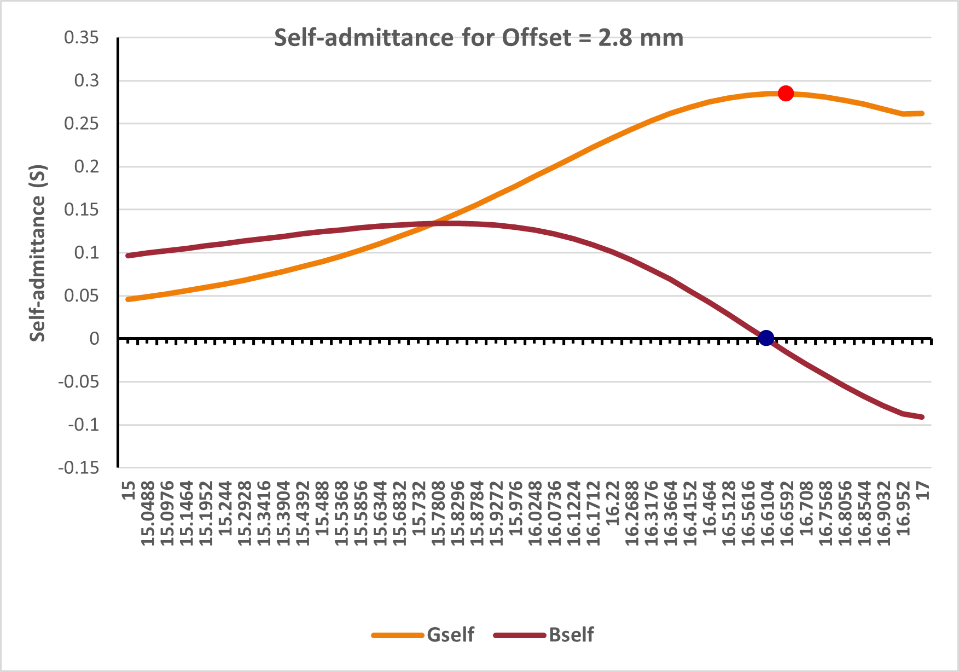
Compiled_Data/simulation3/images/2.8mm.png
