chabodmasere/EGH490-Research-Project/Compiled_Data/simulation3/images/2.9375mm.png

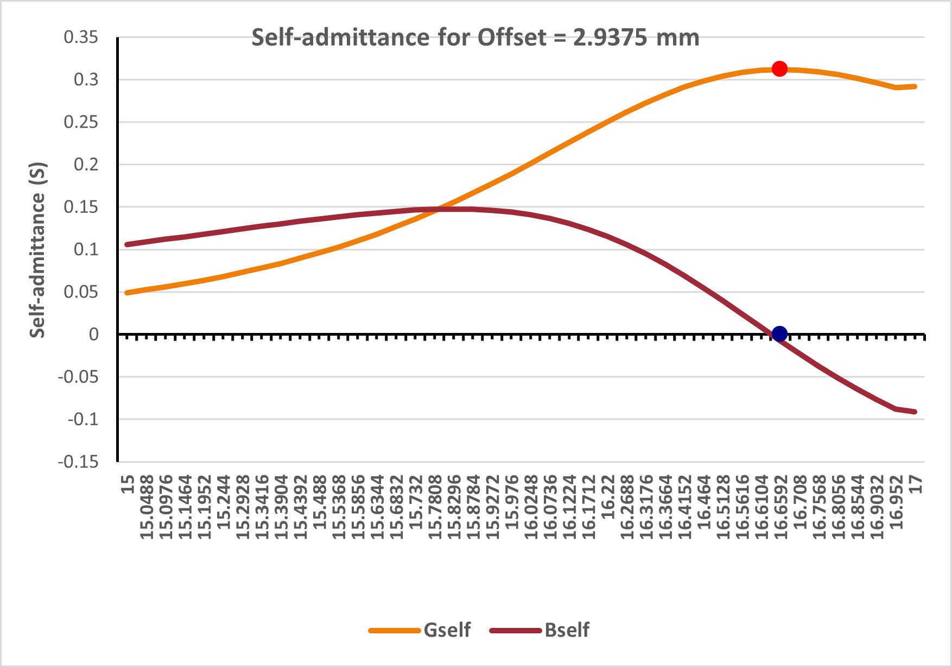
Compiled_Data/simulation3/images/2.9375mm.png
