chabodmasere/EGH490-Research-Project/Compiled_Data/simulation3/images/3.35mm.png

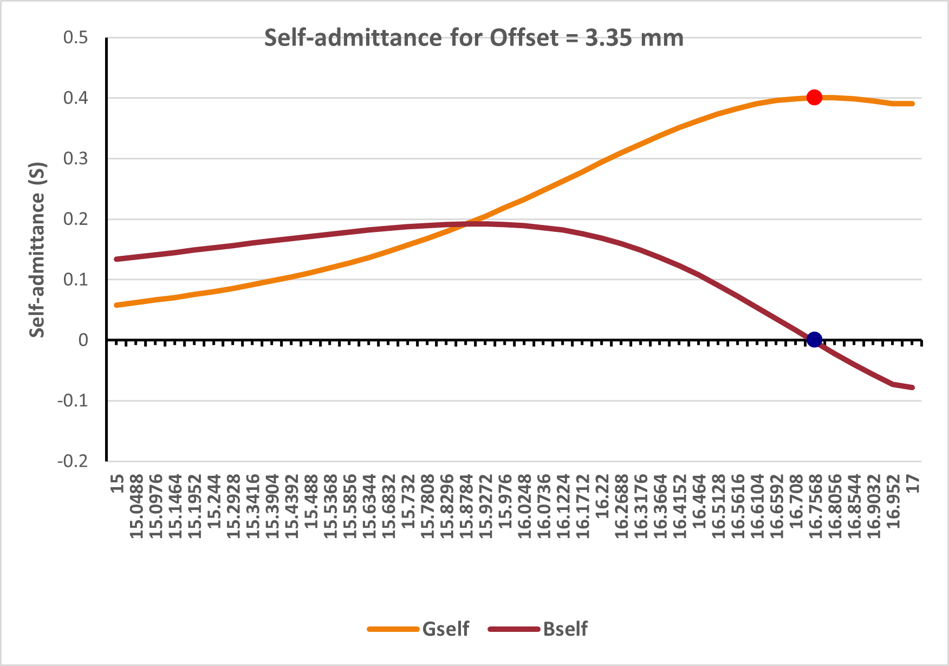
Compiled_Data/simulation3/images/3.35mm.png
