chabodmasere/EGH490-Research-Project/Compiled_Data/simulation3/images/3.2125mm.png

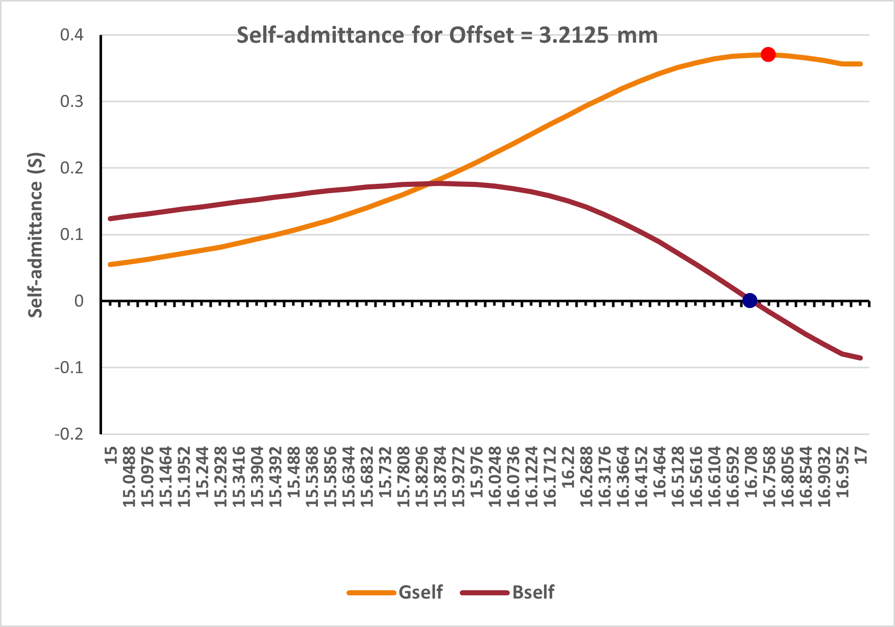
Compiled_Data/simulation3/images/3.2125mm.png
