chabodmasere/EGH490-Research-Project/Compiled_Data/simulation3/images/4.5875mm.png

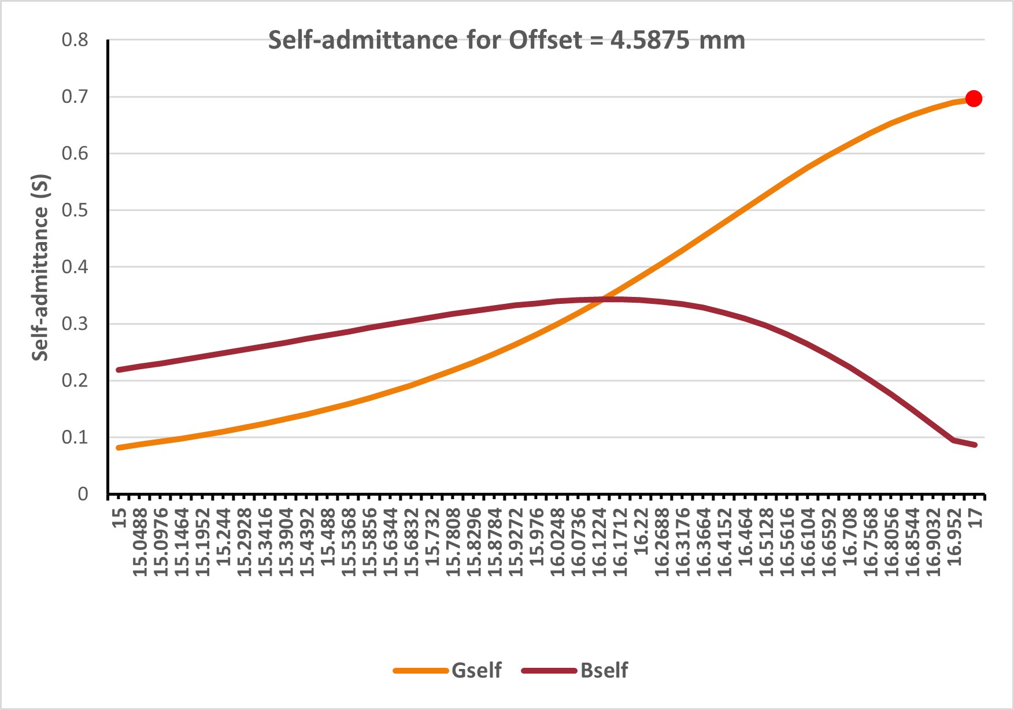
Compiled_Data/simulation3/images/4.5875mm.png
