chabodmasere/EGH490-Research-Project/Compiled_Data/simulation_1/charts/1.15.png

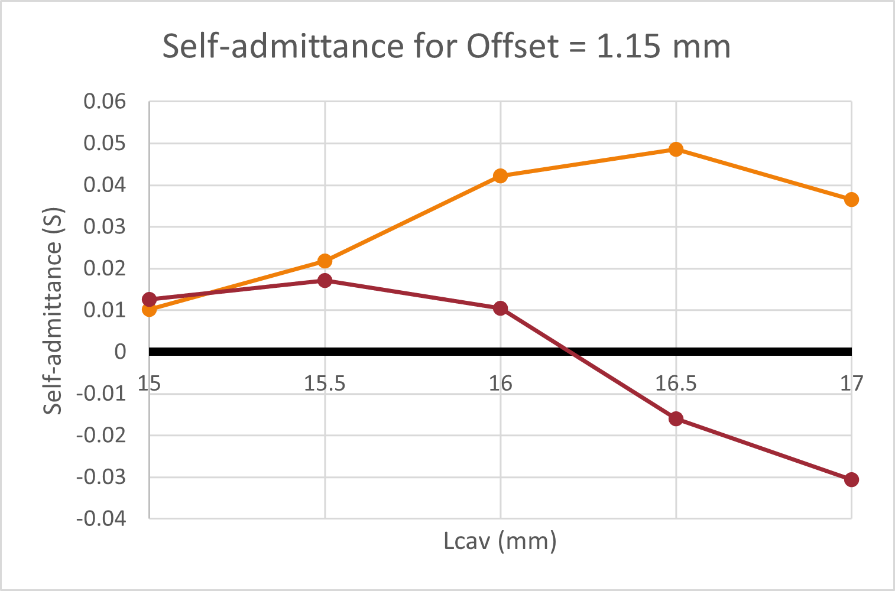
Compiled_Data/simulation_1/charts/1.15.png
