chabodmasere/EGH490-Research-Project/Compiled_Data/simulation_1/charts/2.25.png

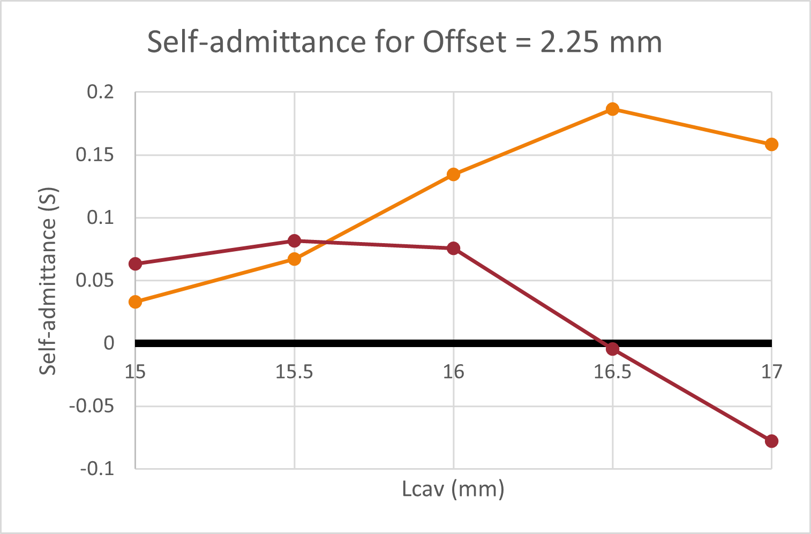
Compiled_Data/simulation_1/charts/2.25.png
