chabodmasere/EGH490-Research-Project/Compiled_Data/simulation_1/charts/2.525.png

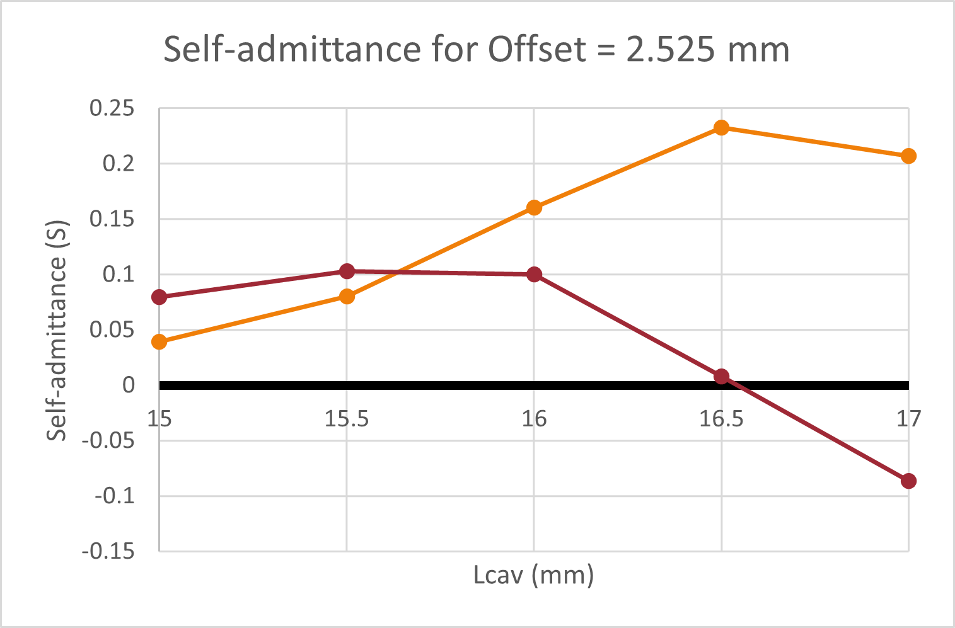
Compiled_Data/simulation_1/charts/2.525.png
