chabodmasere/EGH490-Research-Project/Compiled_Data/simulation_1/charts/3.90.png

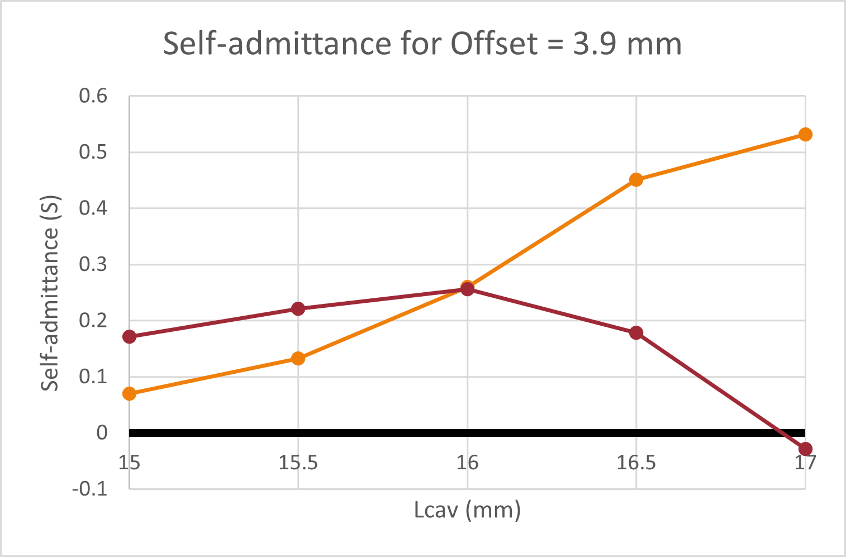
Compiled_Data/simulation_1/charts/3.90.png
