chabodmasere/EGH490-Research-Project/Compiled_Data/simulation_1/charts/4.45.png

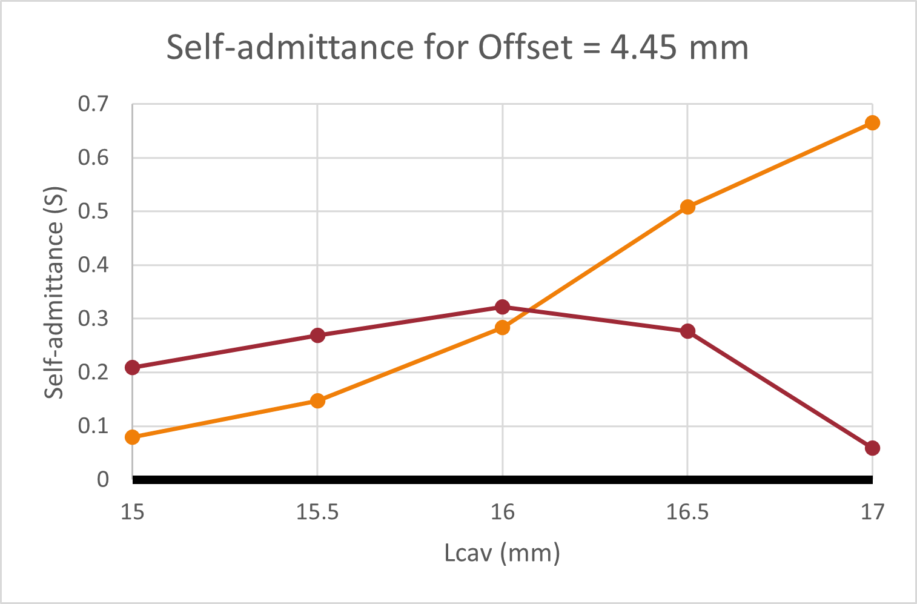
Compiled_Data/simulation_1/charts/4.45.png
