chabodmasere/EGH490-Research-Project/Compiled_Data/simulation_1/charts/4.175.png

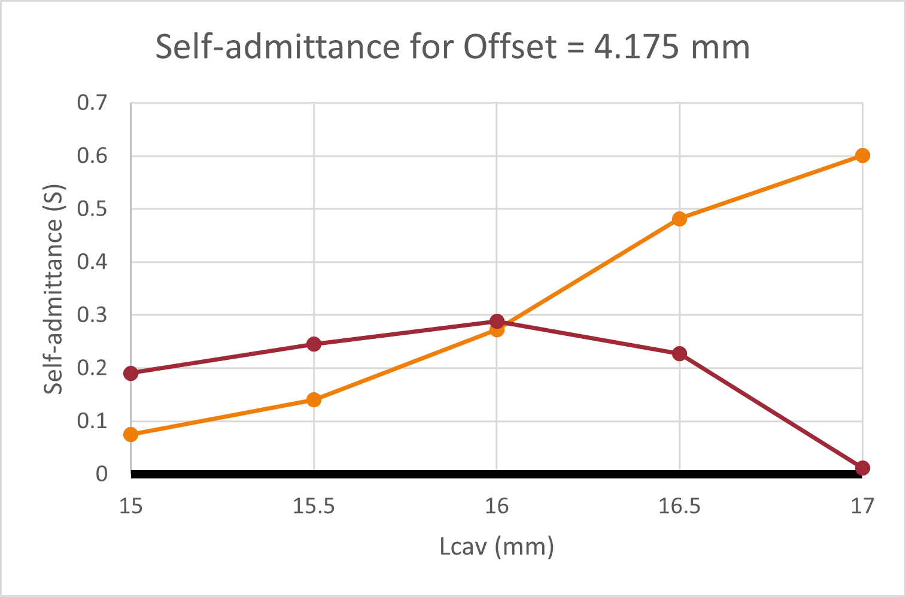
Compiled_Data/simulation_1/charts/4.175.png
