chabodmasere/EGH490-Research-Project/Compiled_Data/simulation_1/charts/5.png

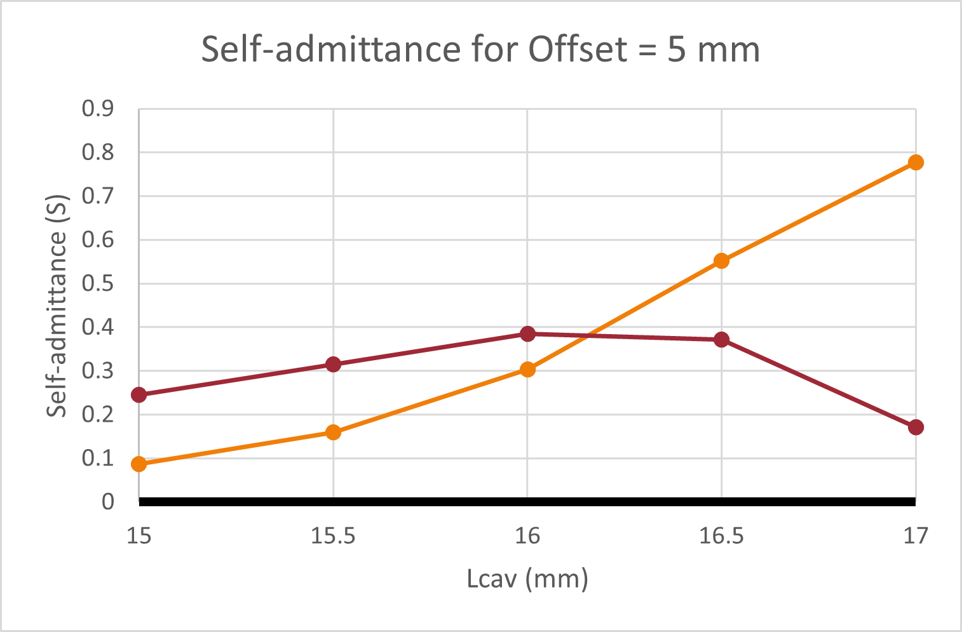
Compiled_Data/simulation_1/charts/5.png
