chabodmasere/EGH490-Research-Project/Compiled_Data/simulation_2 (Accepted)/charts/1.8mm.png

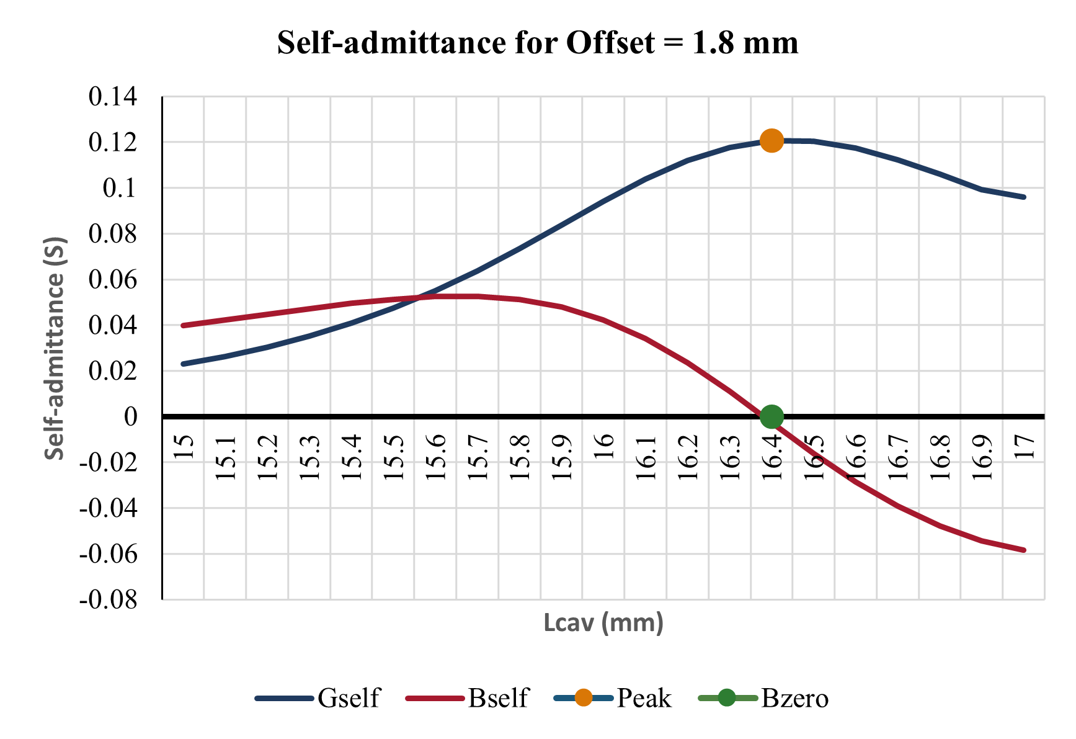
Compiled_Data/simulation_2 (Accepted)/charts/1.8mm.png
