chabodmasere/EGH490-Research-Project/Compiled_Data/simulation_2 (Accepted)/charts/3.8mm.png

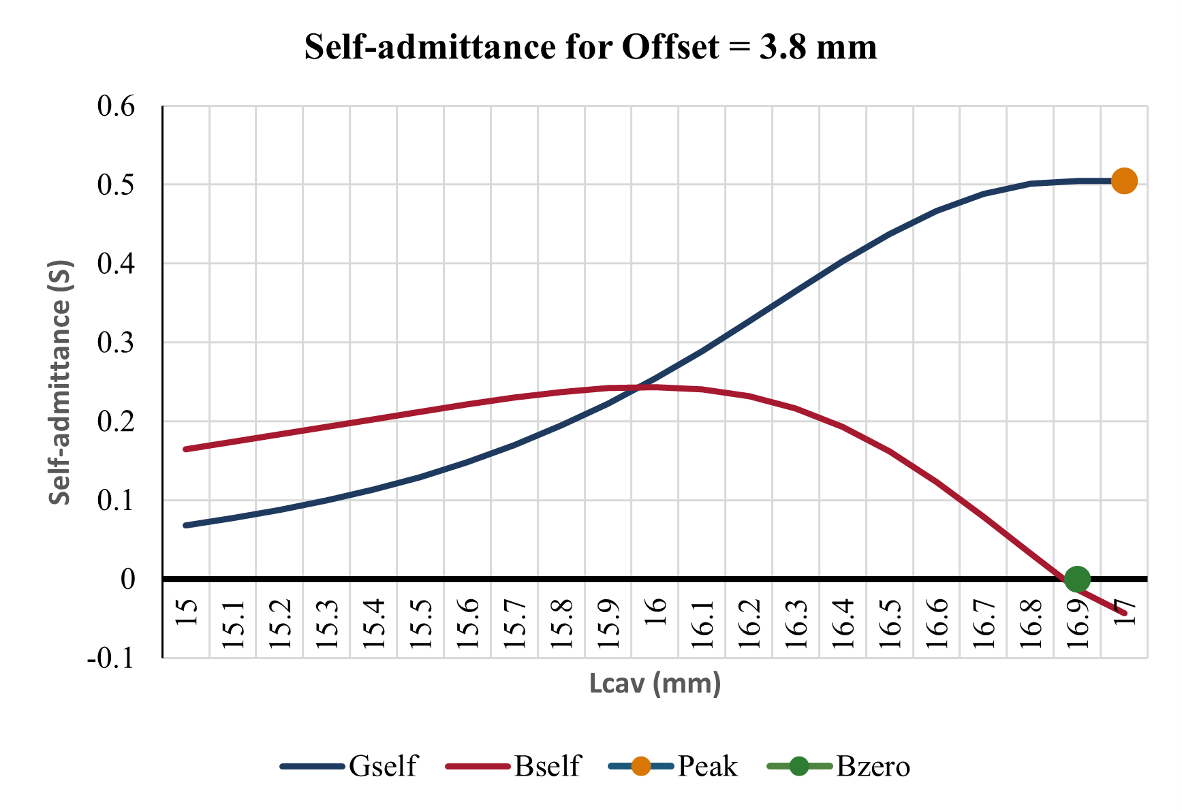
Compiled_Data/simulation_2 (Accepted)/charts/3.8mm.png
