chabodmasere/EGH490-Research-Project/Compiled_Data/simulation_3/images/0.6mm.png

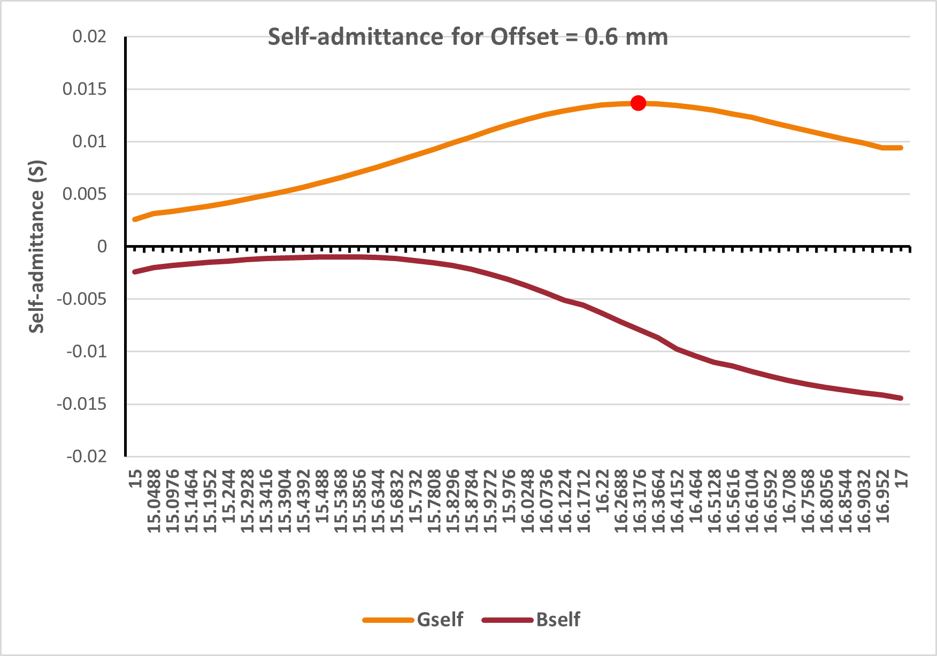
Compiled_Data/simulation_3/images/0.6mm.png
