chabodmasere/EGH490-Research-Project/Compiled_Data/simulation_3/images/1.15mm.png

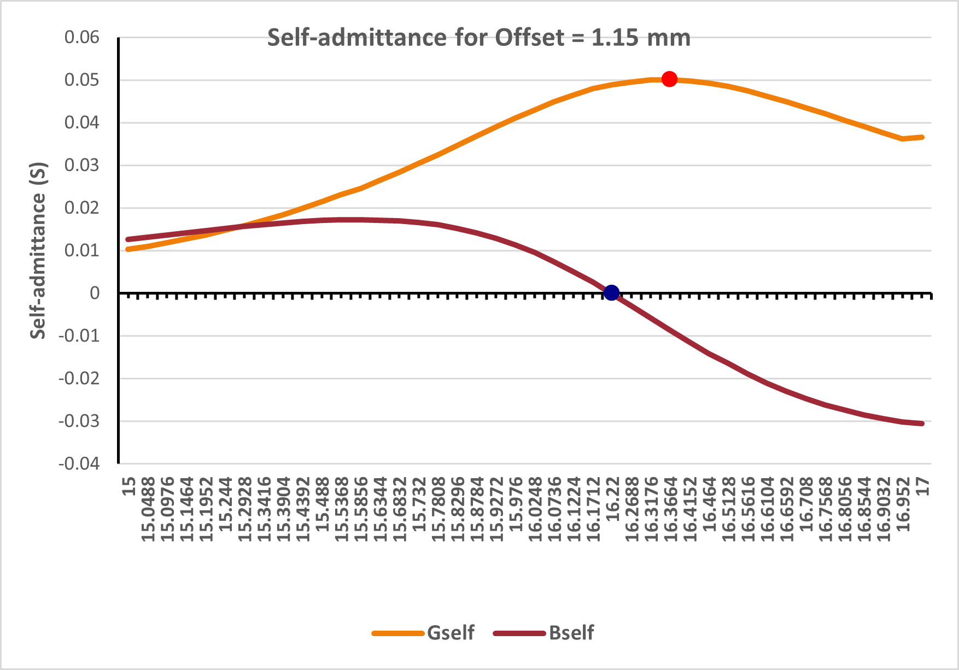
Compiled_Data/simulation_3/images/1.15mm.png
