chabodmasere/EGH490-Research-Project/Compiled_Data/simulation_3/images/1.8375mm.png

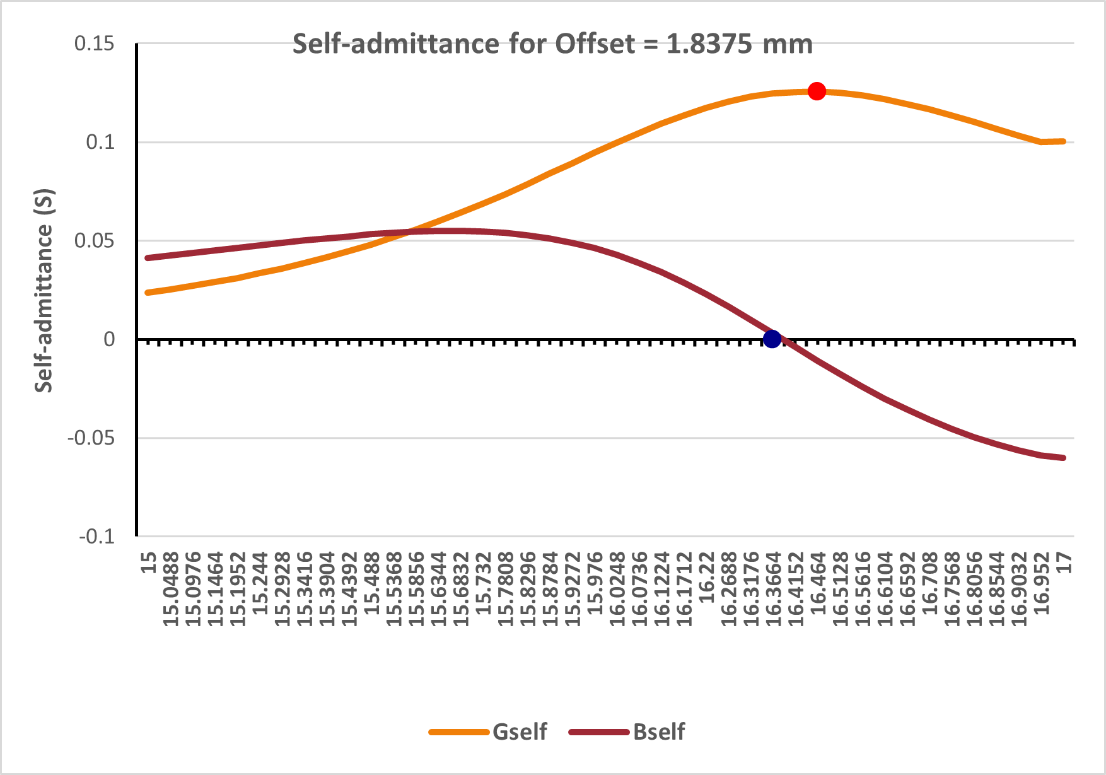
Compiled_Data/simulation_3/images/1.8375mm.png
