chabodmasere/EGH490-Research-Project/Compiled_Data/simulation_3/images/2.25mm.png

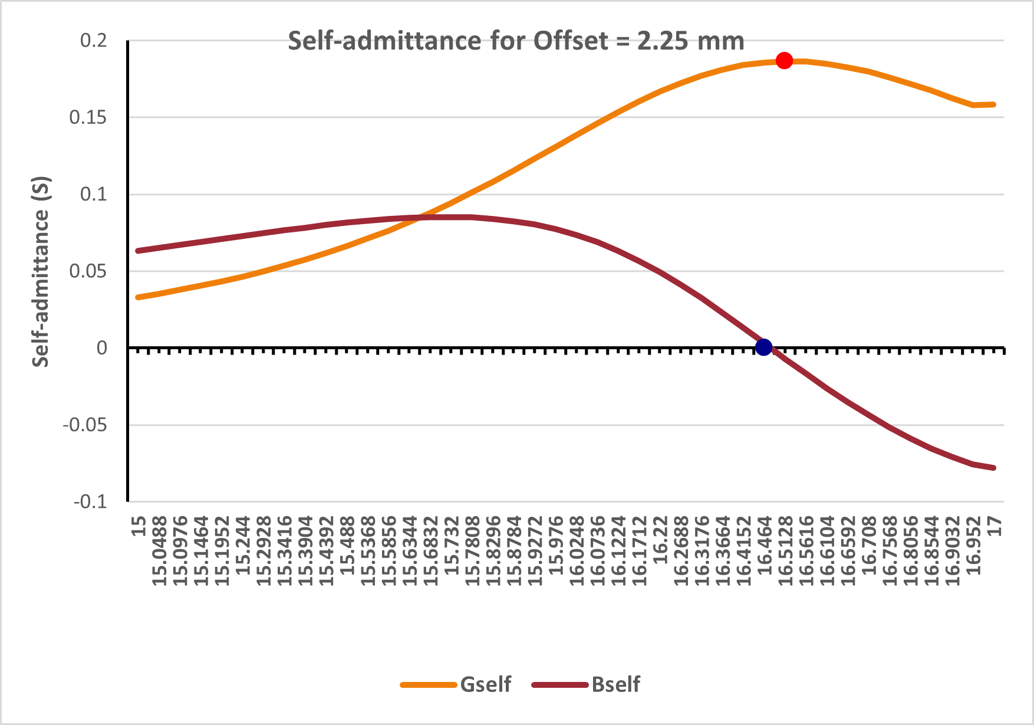
Compiled_Data/simulation_3/images/2.25mm.png
