chabodmasere/EGH490-Research-Project/Compiled_Data/simulation_3/images/3.075mm.png

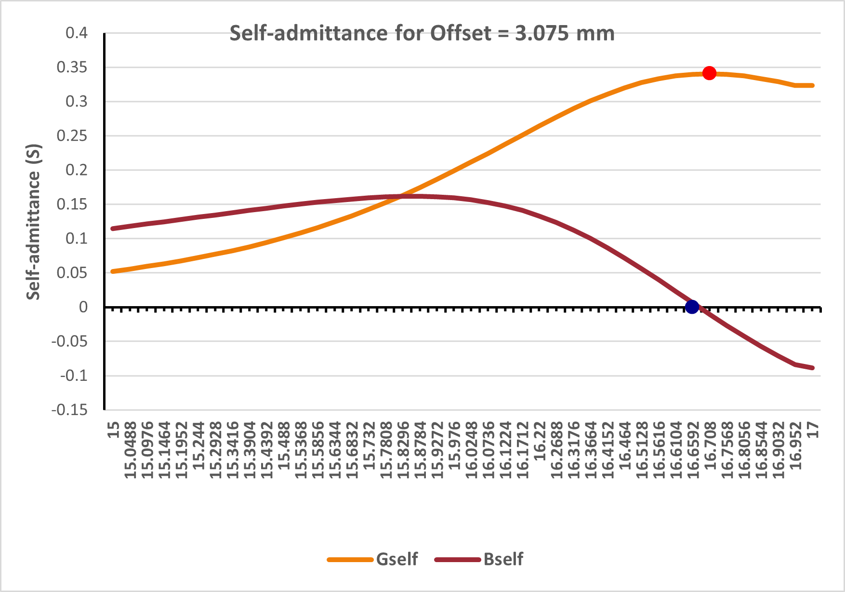
Compiled_Data/simulation_3/images/3.075mm.png
