chabodmasere/EGH490-Research-Project/Compiled_Data/simulation_3/images/3.625mm.png

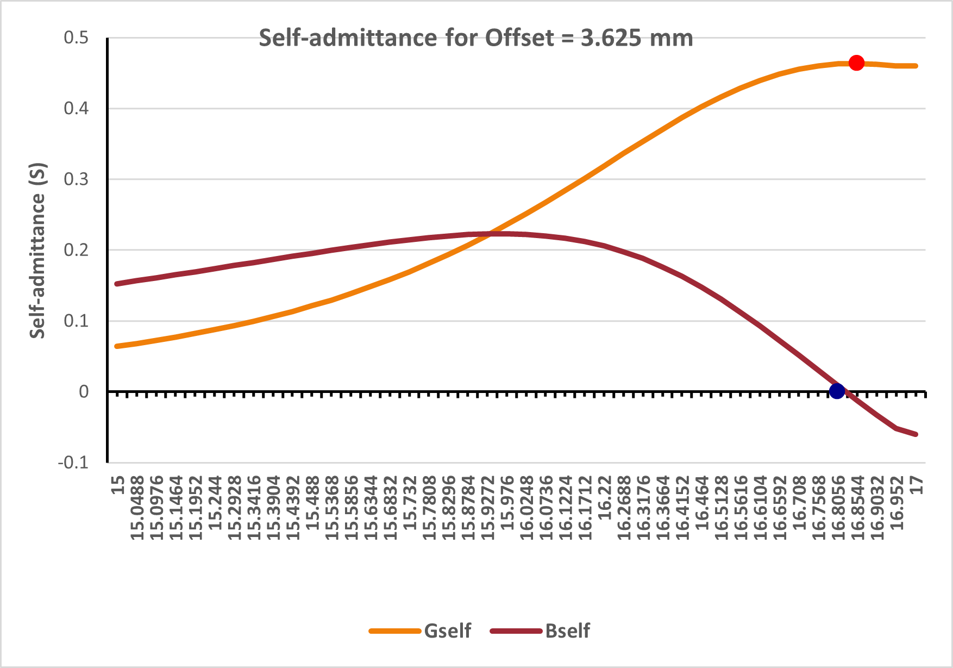
Compiled_Data/simulation_3/images/3.625mm.png
