chabodmasere/EGH490-Research-Project/Compiled_Data/simulation_3/images/3.4875mm.png

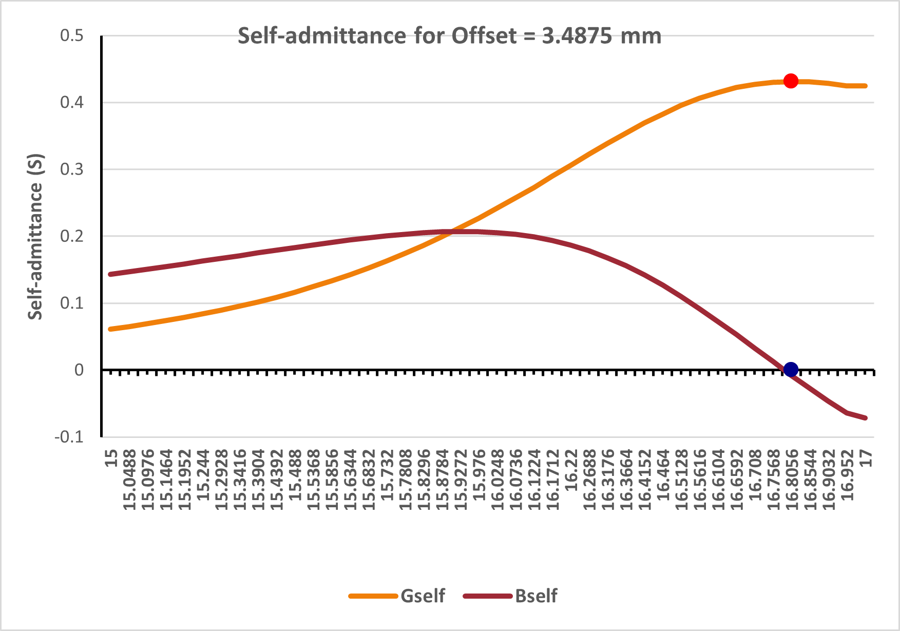
Compiled_Data/simulation_3/images/3.4875mm.png
