chabodmasere/EGH490-Research-Project/Compiled_Data/simulation_3/images/4.8625mm.png

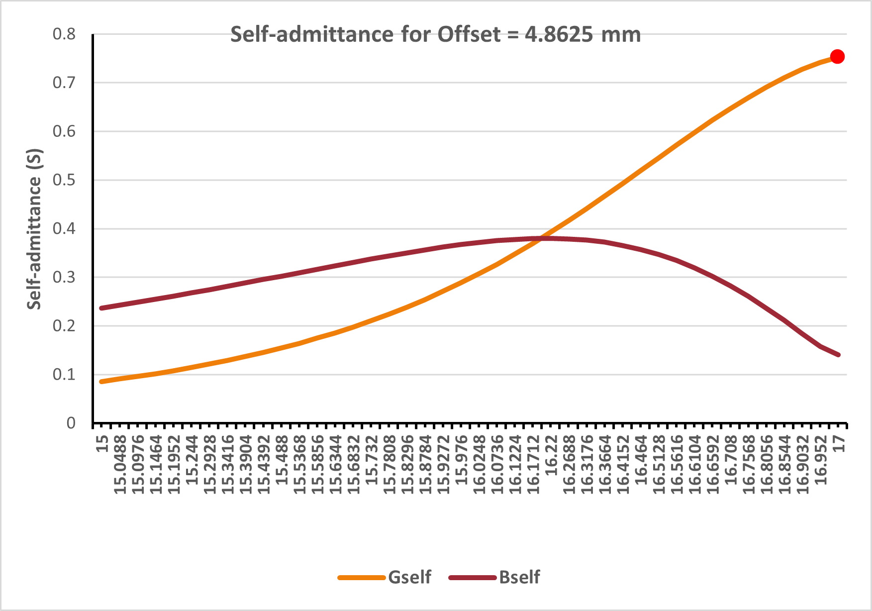
Compiled_Data/simulation_3/images/4.8625mm.png
