chabodmasere/EGH490-Research-Project/EGH490-2 DATA/EGH490 SIMS/simulation 1/Lcav15.png

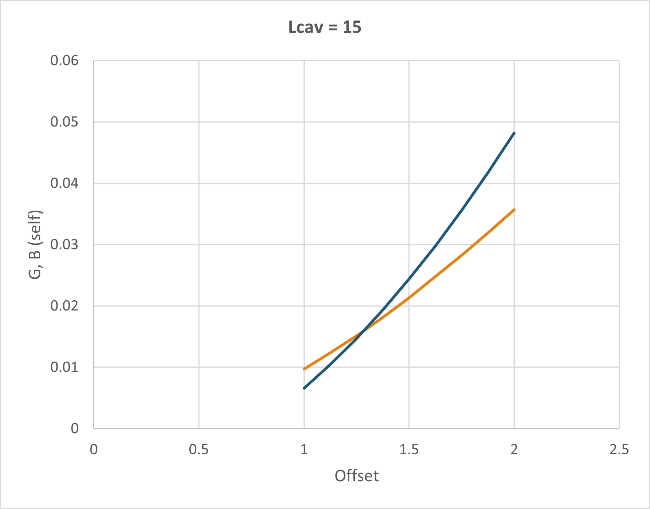
EGH490-2 DATA/EGH490 SIMS/simulation 1/Lcav15.png
