chabodmasere/EGH490-Research-Project/Graphical_Images/circuit_1.png

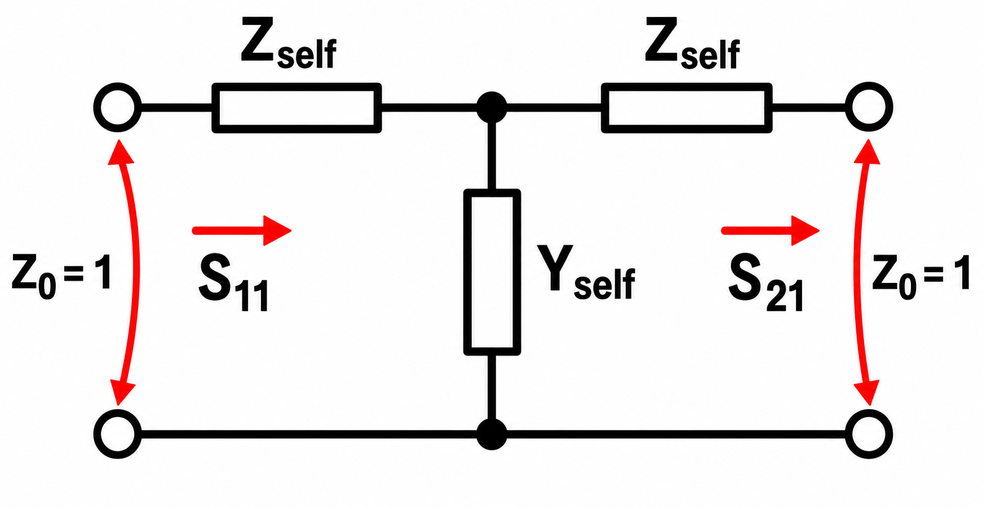
Graphical_Images/circuit_1.png
