chabodmasere/EGH490-Research-Project/Graphical_Images/circuit_2.png

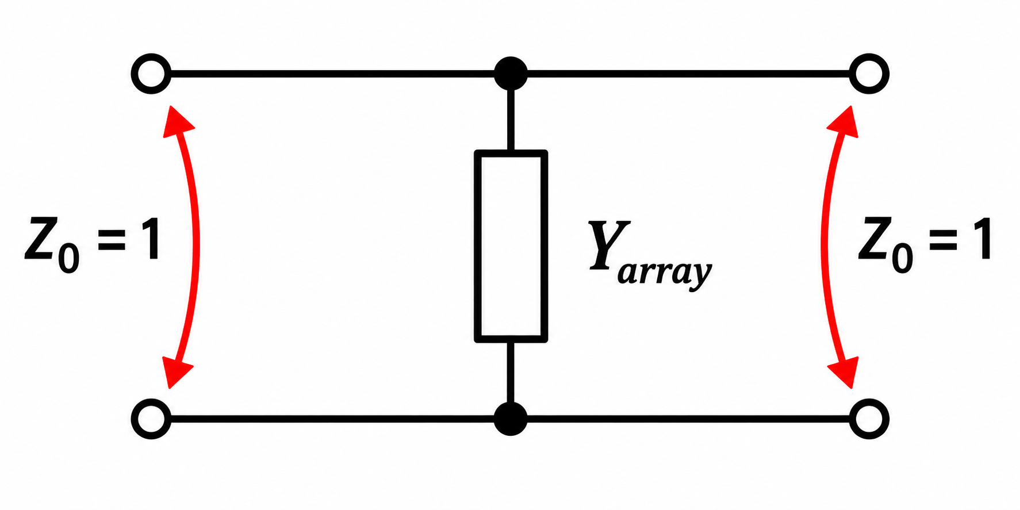
Graphical_Images/circuit_2.png
