chabodmasere/EGH490-Research-Project/Single Slot Analysis/graphical imagery/curve 1 efield f=9 (2).PNG

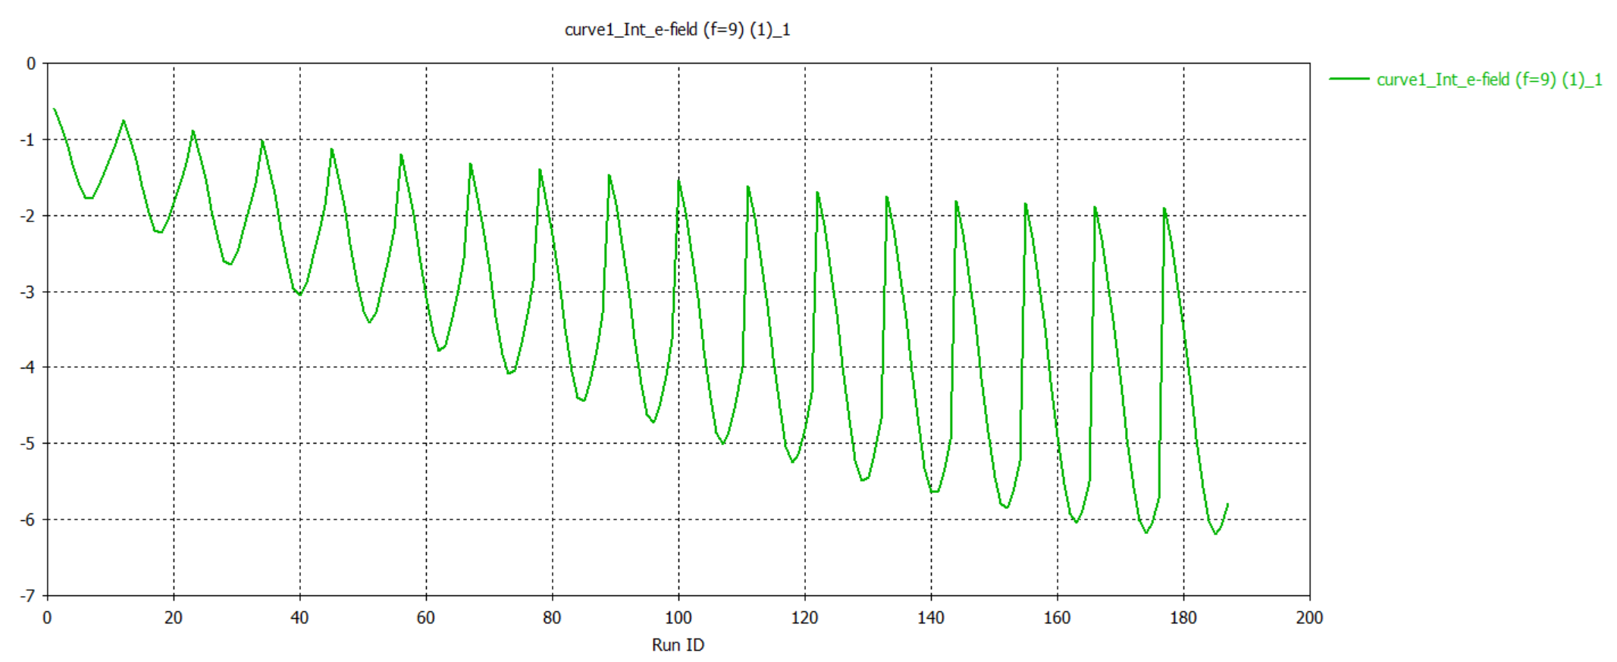
Single Slot Analysis/graphical imagery/curve 1 efield f=9 (2).PNG
