chabodmasere/EGH490-Research-Project/Single Slot Analysis/graphical imagery/fairfield Dire..PNG

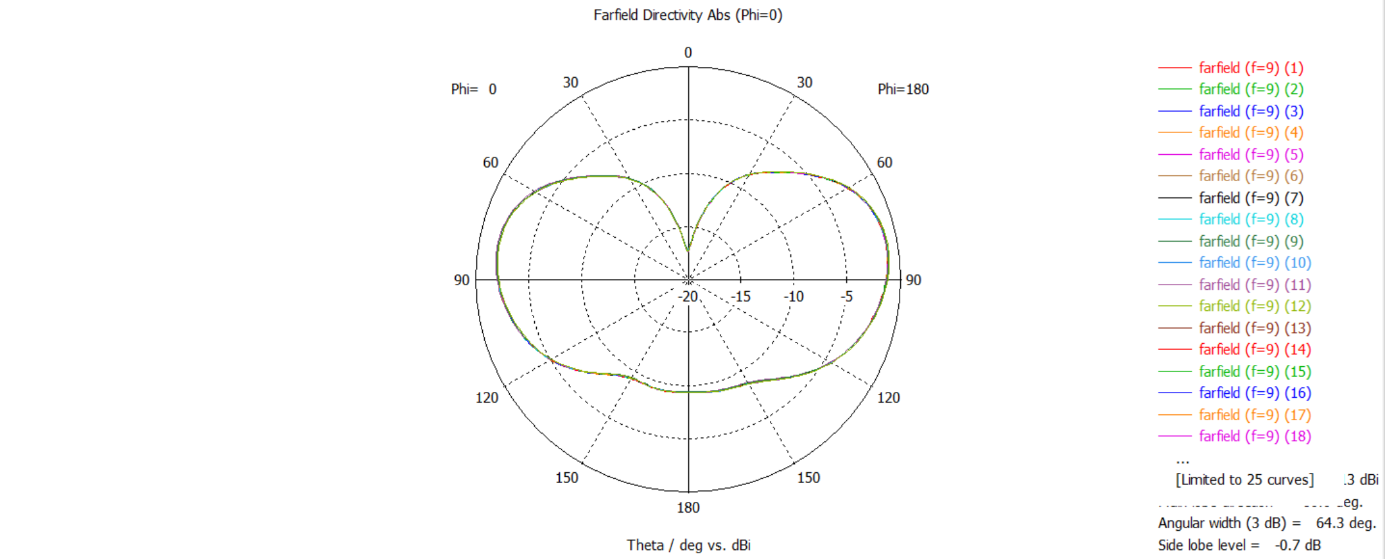
Single Slot Analysis/graphical imagery/fairfield Dire..PNG
