chabodmasere/EGH490-Research-Project/Single Slot Analysis/graphical imagery/s11.PNG

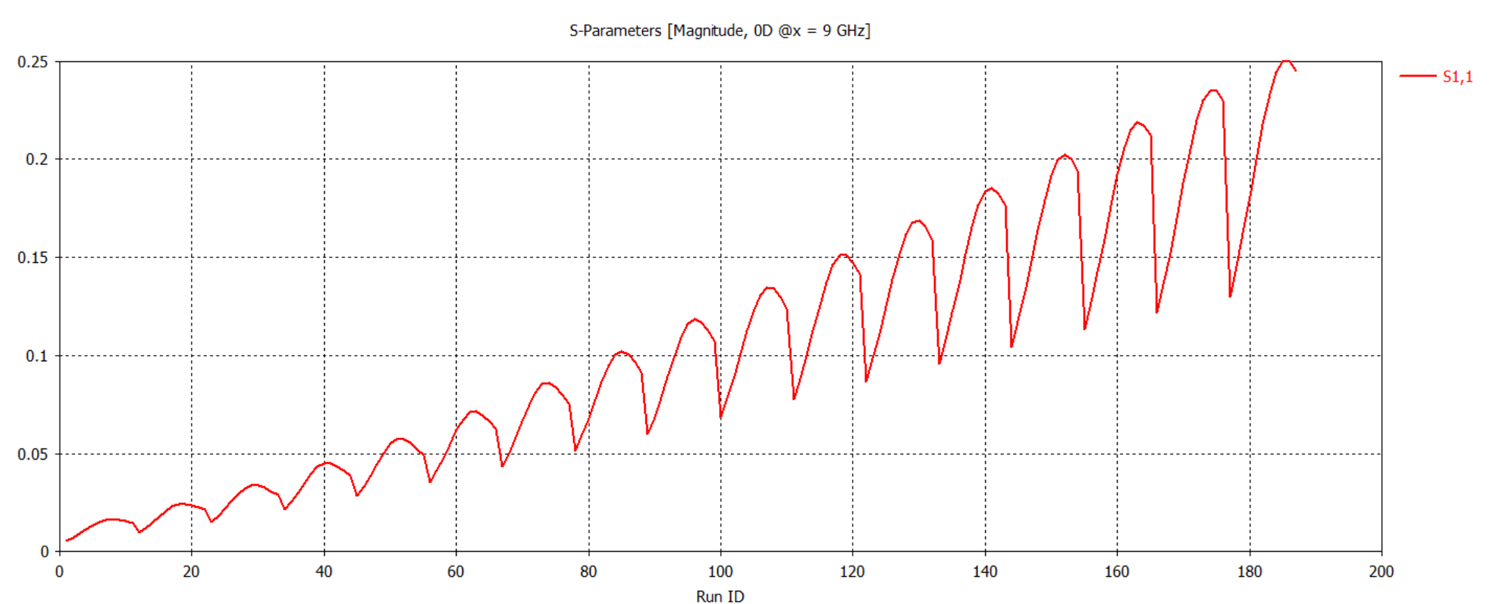
Single Slot Analysis/graphical imagery/s11.PNG
