chabodmasere/EGH490-Research-Project/Single Slot Analysis/graphical imagery/zref.PNG

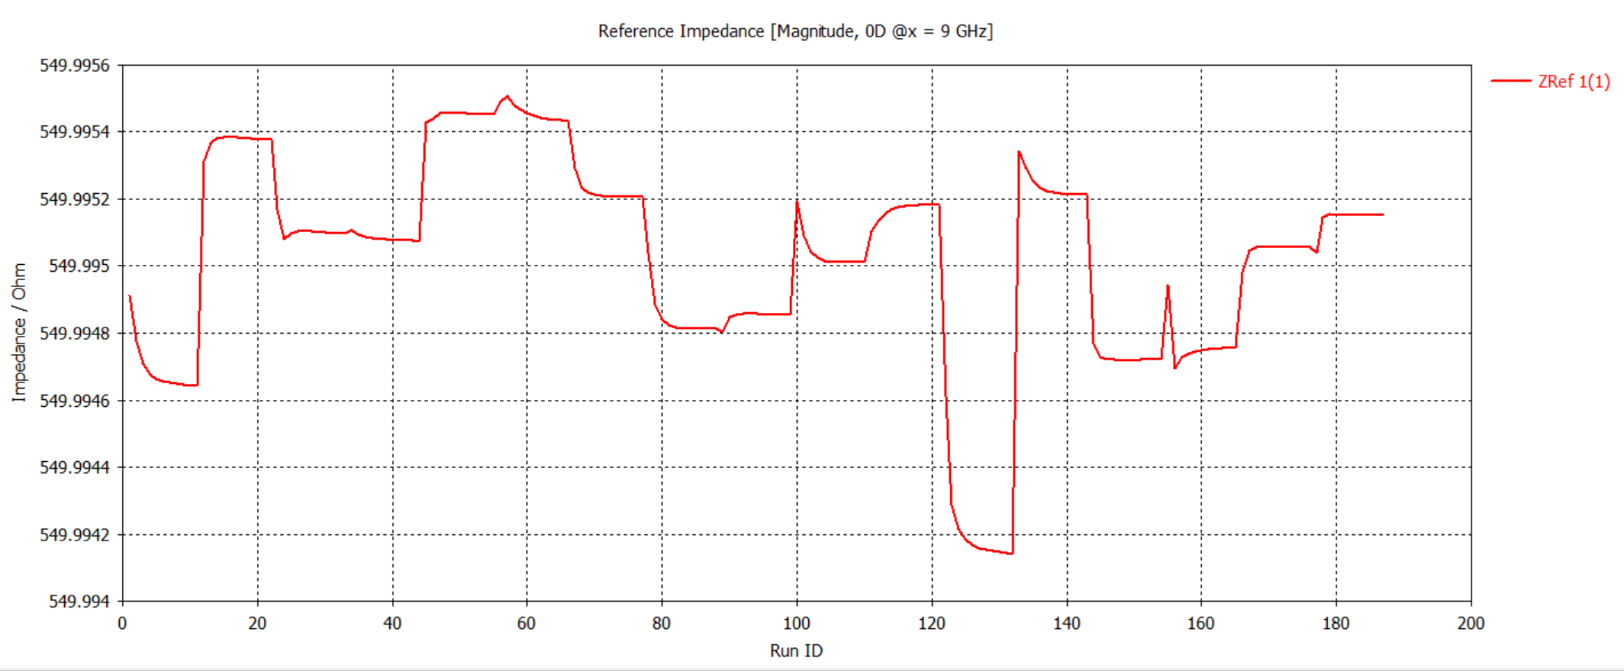
Single Slot Analysis/graphical imagery/zref.PNG
