chabodmasere/EGH490-Research-Project/Single Slot DATA/graphical analysis/curve 1 efield f=9.PNG

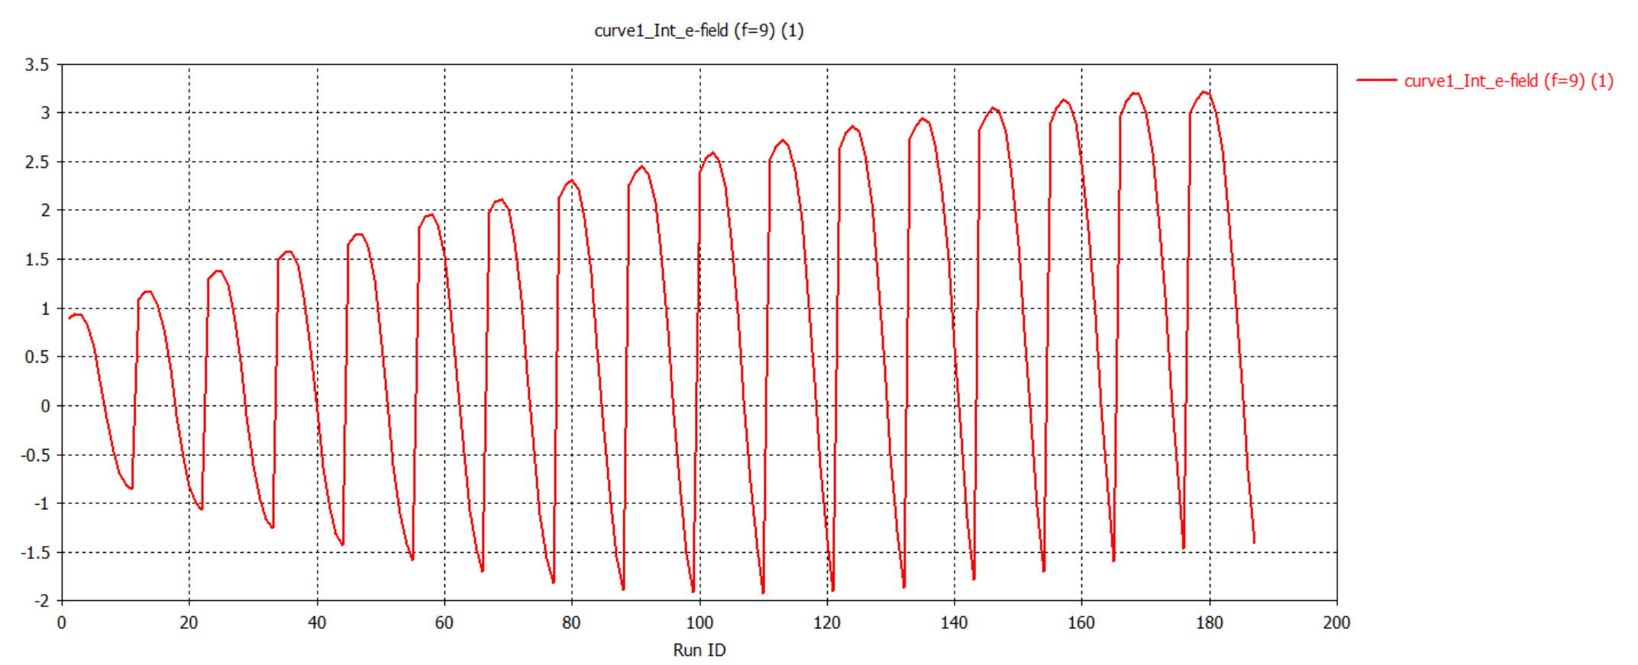
Single Slot DATA/graphical analysis/curve 1 efield f=9.PNG
