chabodmasere/EGH490-Research-Project/Single Slot DATA/graphical analysis/curve 2 efield f=9 (2).PNG

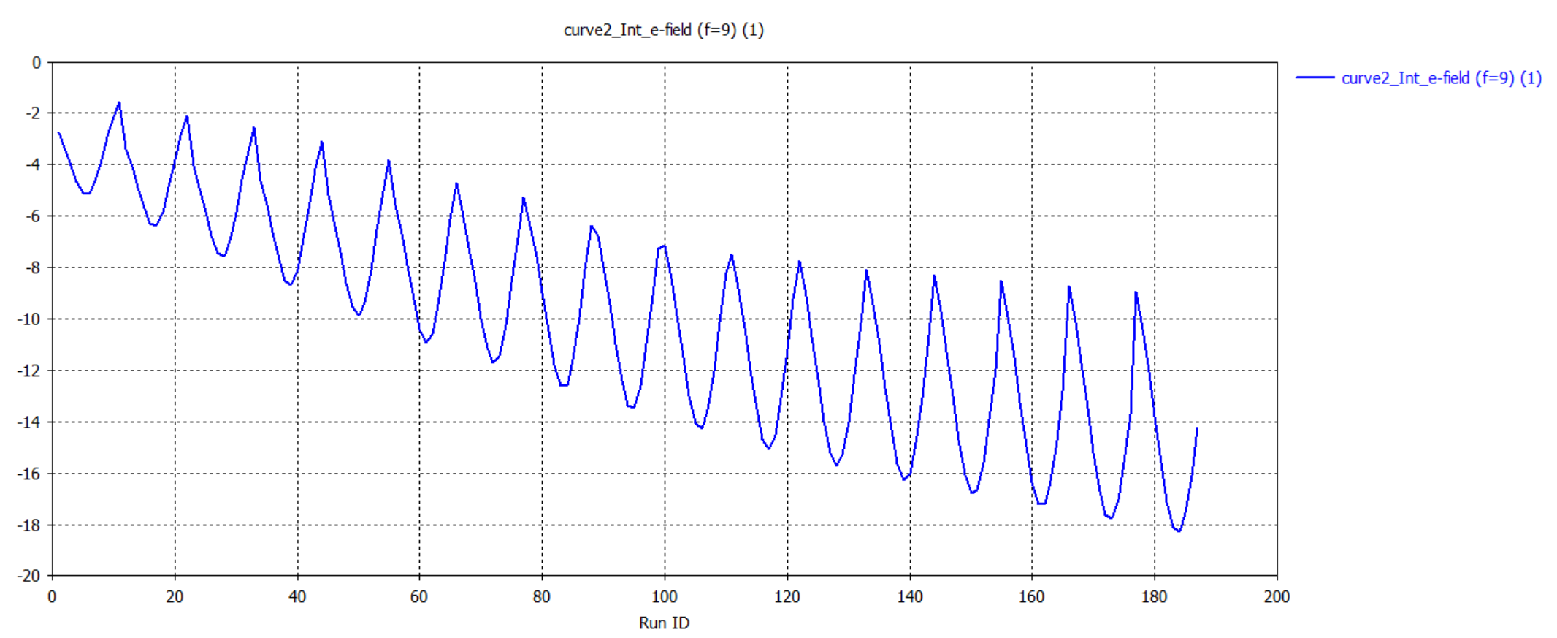
Single Slot DATA/graphical analysis/curve 2 efield f=9 (2).PNG
