chabodmasere/EGH490-Research-Project/Single Slot DATA/graphical analysis/s21.PNG

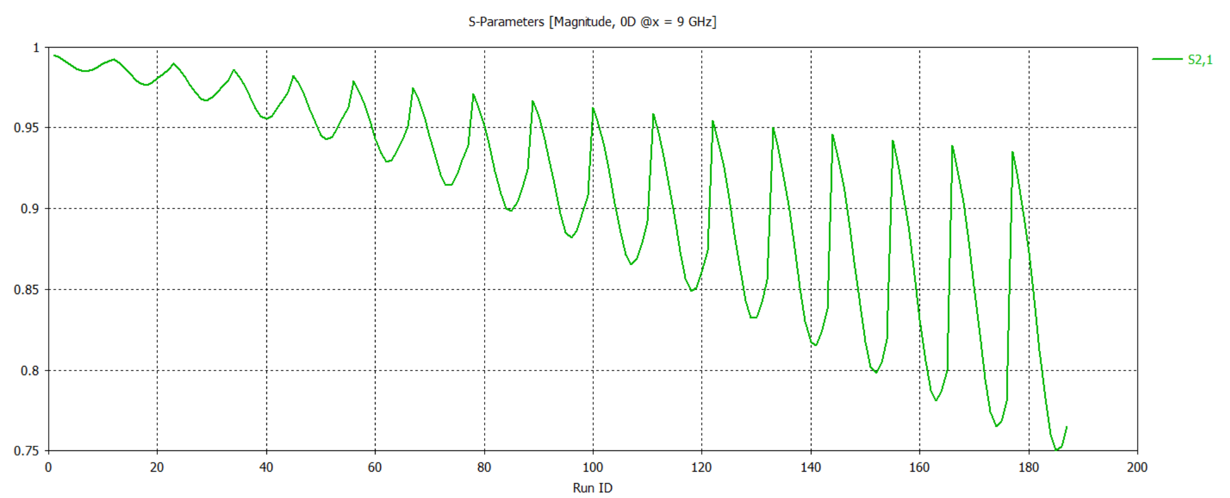
Single Slot DATA/graphical analysis/s21.PNG
