chabodmasere/EGH490-Research-Project/Single Slot DATA/graphical analysis/zref2.PNG

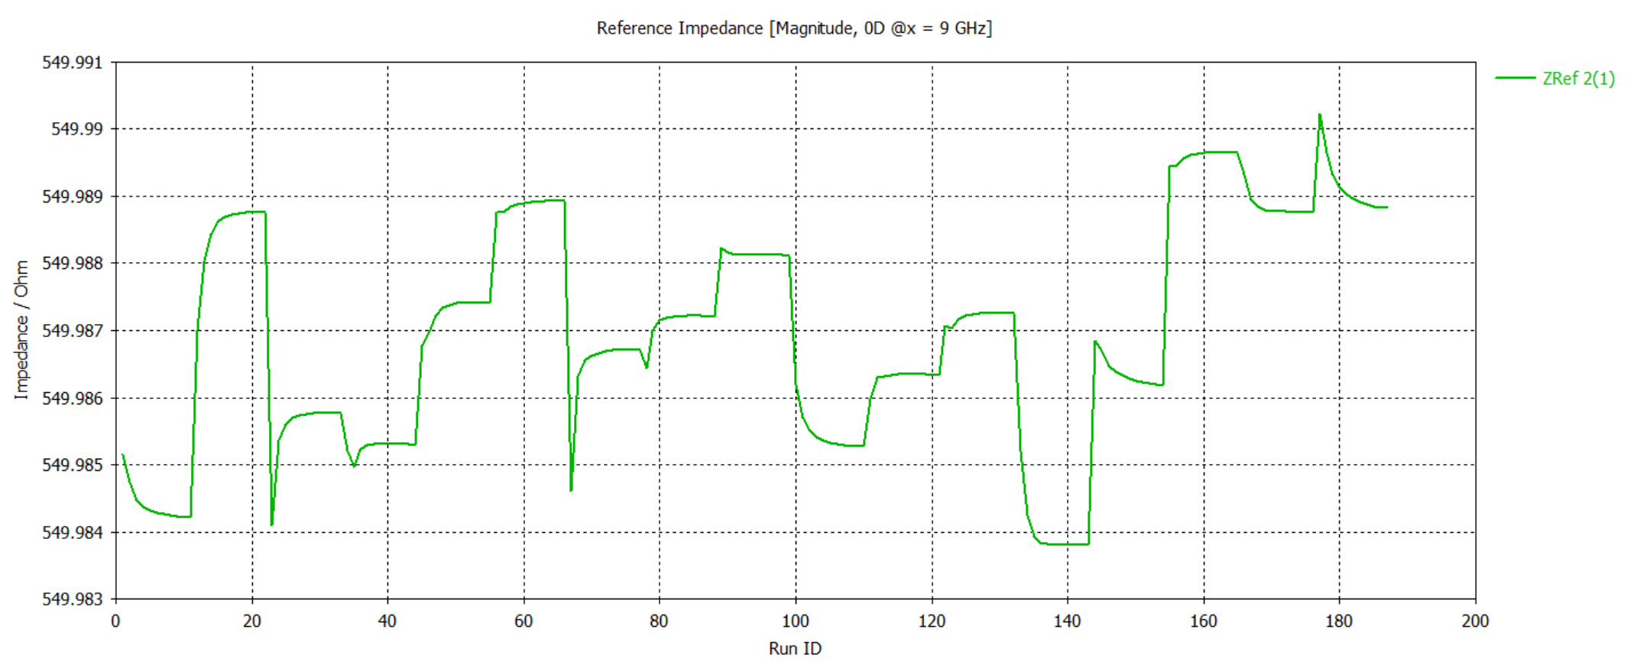
Single Slot DATA/graphical analysis/zref2.PNG
