chabodmasere/EGH490-Research-Project/Compiled_Data/simulation_3/OPEN_SLOT_CAVITY (SIM3).xlsm

Sheet: DATA
Offset | L=Lcav | S11 Re | S11 Im | S21 Re | S21 Im | Z11 Re | Z11 Im | Z12 Re | Z12 Im | Rself | Xself | Gself | Bself | Re[Vcav] | Im[Vcav] | Re[Vrad] | Im[Vrad] | |rho| | arg(rho) | Column1 | Column2
0.6 | 15 | -0.0014676396 | 0.0019170637 | 0.99887386 | 0.00048834512 | 206.7753704 | 192.2226299 | 206.7755416 | 192.2219158 | -0.000171230698 | 0.000714115034 | 0.002594247928 | -0.002411655183 | 1.6156024 | -0.87314649 | 1.1026838 | -1.4009629 | 0.9708205233 | -23.40522773
0.6 | 15.0488 | -0.0015747687 | 0.0018378968 | 0.99843724 | 0.00014258606 | 227.4120866 | 143.8639645 | 227.4120934 | 143.8631169 | -6.722820018e-06 | 0.000847644582 | 0.003140493333 | -0.001986706831 | 1.6481597 | -0.93555849 | 1.1102878 | -1.4744253 | 0.9739012753 | -23.43822151
0.6 | 15.0976 | -0.0016913228 | 0.0017581655 | 0.99833769 | 4.4585955e-05 | 230.8366129 | 124.3558525 | 230.8366281 | 124.3549957 | -1.5240246e-05 | 0.000856764287 | 0.003357637657 | -0.001808807467 | 1.6850927 | -1.0020336 | 1.1192757 | -1.5511161 | 0.9756547051 | -23.44835591
0.6 | 15.1464 | -0.0018173079 | 0.0016792258 | 0.99821846 | -3.3588757e-05 | 229.3140103 | 105.0869654 | 229.3140289 | 105.086109 | -1.861702398e-05 | 0.00085637602 | 0.003603979033 | -0.001651569838 | 1.721516 | -1.0741413 | 1.1254321 | -1.6325268 | 0.9771946817 | -23.4562441
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
1.975 | 15.1952 | -0.017951167 | -0.024971011 | 0.98193886 | -0.027483748 | 8.395494982 | -12.95632129 | 8.395441571 | -12.95757779 | 5.341080394e-05 | 0.001256504694 | 0.03521839889 | 0.05435630032 | 5.3297666 | -3.3339422 | 3.4654949 | -5.0236103 | 0.9707882125 | -23.37315938

Sheet: Reference
Column | Quantity | Equation | Excel formula (row 2) | Name (electromagnetics)
G | Z11 Re | Re{ [(1+S11)(1-S11) + S21^2] / [(1-S11)^2 - S21^2] } | 0 | Z11 — Open-circuit input impedance (real part), from S→Z conversion (Pozar Ch. 4)
H | Z11 Im | Im{ [(1+S11)(1-S11) + S21^2] / [(1-S11)^2 - S21^2] } | 0 | Z11 — Open-circuit input impedance (imaginary part)
I | Z12 Re | Re{ 2·S21 / [(1-S11)^2 - S21^2] } | 0 | Z12 — Open-circuit transfer / mutual impedance (real part)
J | Z12 Im | Im{ 2·S21 / [(1-S11)^2 - S21^2] } | 0 | Z12 — Open-circuit transfer / mutual impedance (imaginary part)
K | Rself | Re{ Z11 - Z12 } | 0 | Self-resistance Rself = Re{Z11 − Z12} (odd-mode resistance)
L | Xself | Im{ Z11 - Z12 } | 0 | Self-reactance Xself = Im{Z11 − Z12}
M | Gself | Re{ [(1-S11)^2 - S21^2] / (2·S21) } | 0 | Self-conductance Gself = Re{Yself} = Re{1/(Z11 − Z12)} (slot self-conductance; peak ⇒ radiation resonance)
N | Bself | Im{ [(1-S11)^2 - S21^2] / (2·S21) } | 0 | Self-susceptance Bself = Im{Yself} (zero-crossing ⇒ slot resonance)
S | |rho| | |Vrad| / |Vcav| | #DIV/0! | |ρ| — magnitude of aperture / radiation-to-cavity voltage reflection coefficient
T | arg(rho) [deg] | arg( Vrad / (Vcav/L) ) · 180/π | #VALUE! | arg(ρ) — phase of aperture reflection coefficient (degrees)
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
