chabodmasere/EGH490-Research-Project/Graphical_Images/second_order_lobes_irregular.png

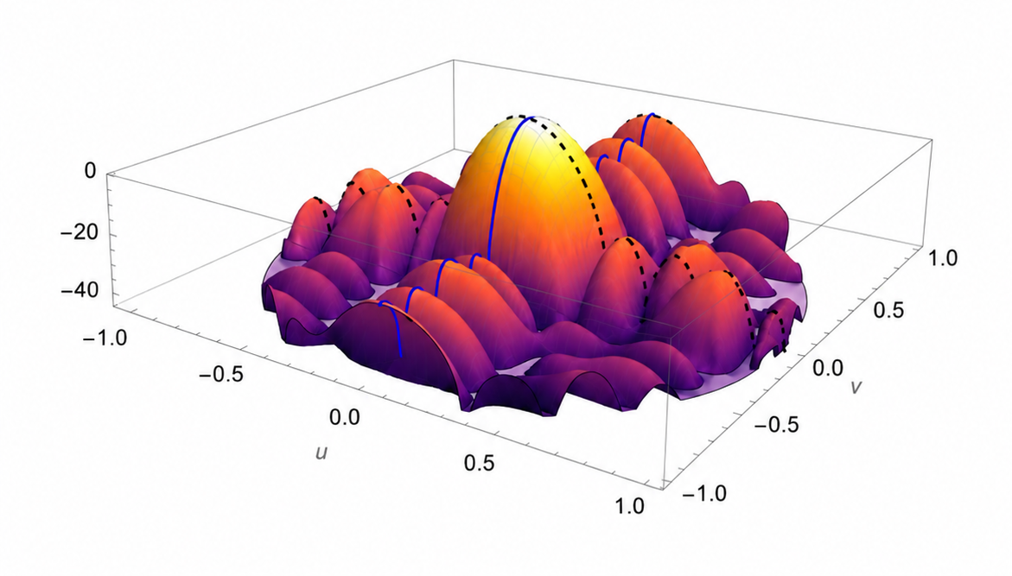
Graphical_Images/second_order_lobes_irregular.png
