chabodmasere/EGH490-Research-Project/Single Slot DATA/waveguide overview/vacuum.PNG

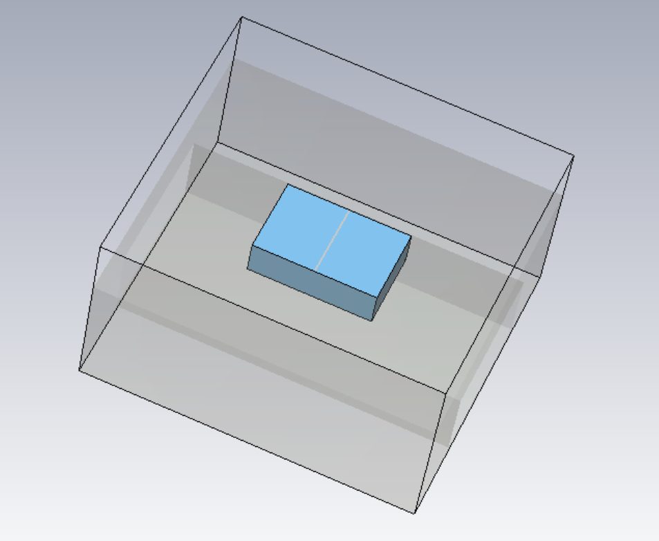
Single Slot DATA/waveguide overview/vacuum.PNG
