chabodmasere/EGH490-Research-Project/Waveguide_Images/efield_bottom_view_2.png

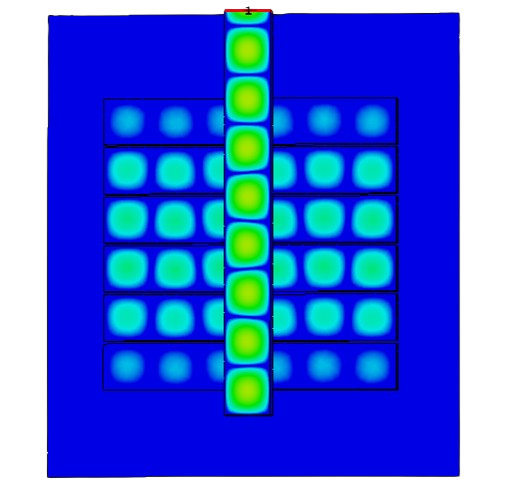
Waveguide_Images/efield_bottom_view_2.png
