chabodmasere/EGH490-Research-Project/Waveguide_Images/layer_1.png

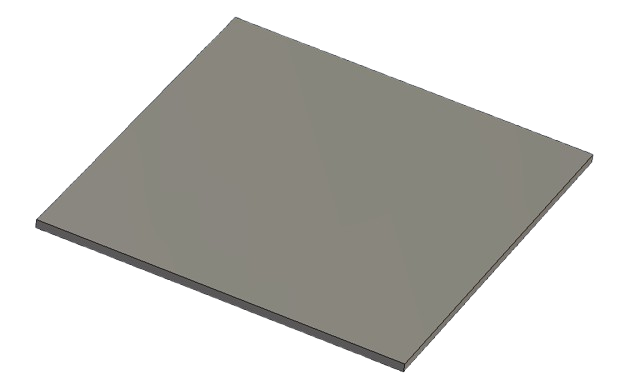
Waveguide_Images/layer_1.png
