chabodmasere/EGH490-Research-Project/Waveguide_Images/layer_4.png

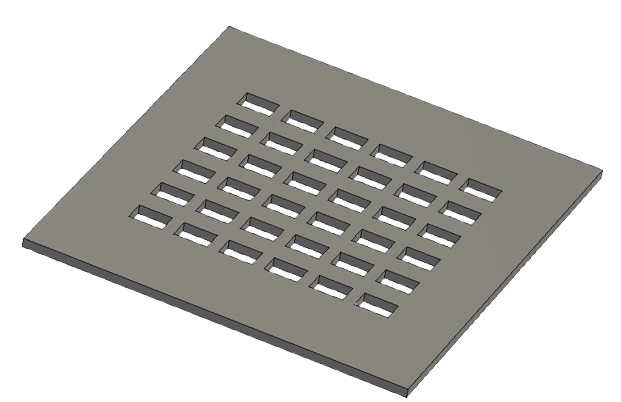
Waveguide_Images/layer_4.png
