chabodmasere/EGH490-Research-Project/Waveguide_Images/longslotonwaveguide.PNG

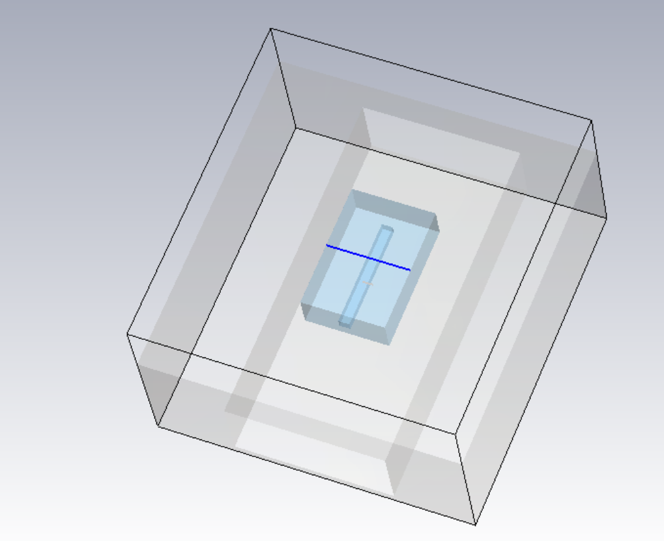
Waveguide_Images/longslotonwaveguide.PNG
