chabodmasere/EGH490-Research-Project/Waveguide_Images/multiarray_curverad.png

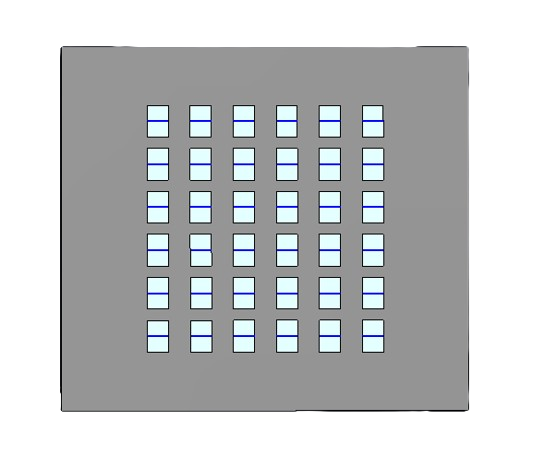
Waveguide_Images/multiarray_curverad.png
