chabodmasere/EGH490-Research-Project/Waveguide_Images/pla_prototype_view_2.png

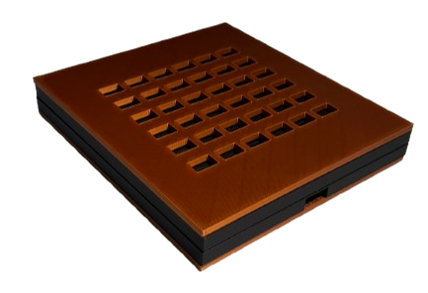
Waveguide_Images/pla_prototype_view_2.png
