chabodmasere/EGH490-Research-Project/Waveguide_Images/pla_prototype_view_3.png

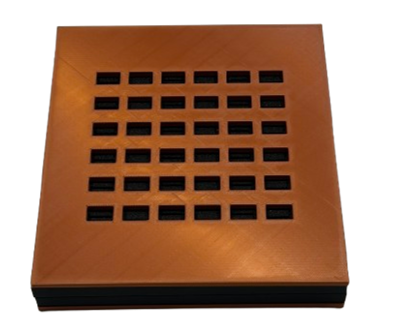
Waveguide_Images/pla_prototype_view_3.png
