chabodmasere/EGH490-Research-Project/Waveguide_Images/shortslotonwaveguide.PNG

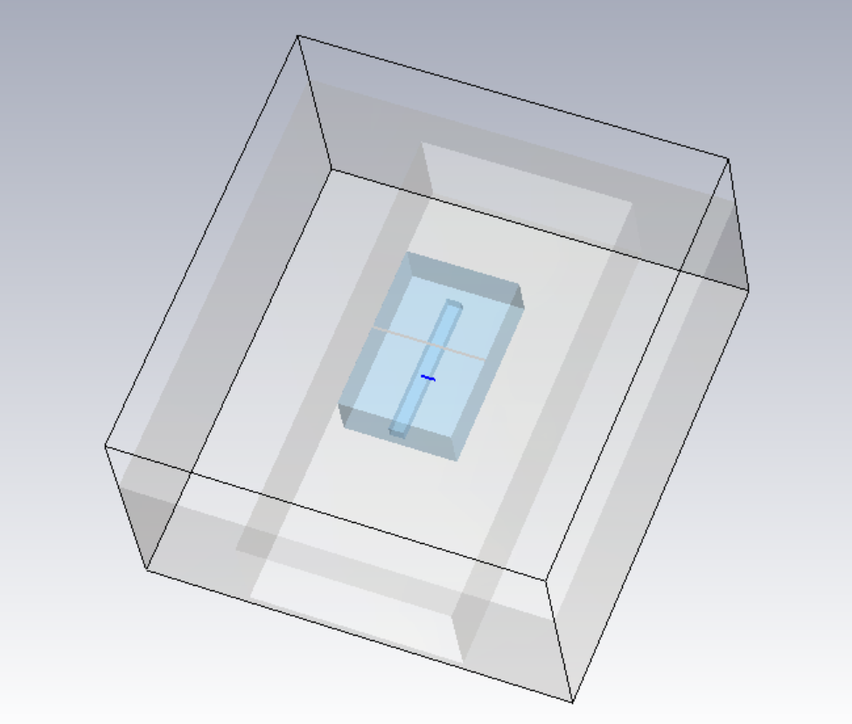
Waveguide_Images/shortslotonwaveguide.PNG
