chabodmasere/EGH490-Research-Project/Waveguide_Images/singleslot_cavface.png

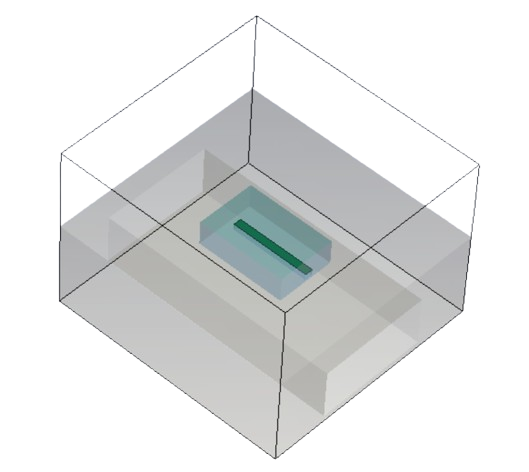
Waveguide_Images/singleslot_cavface.png
