chabodmasere/EGH490-Research-Project/Waveguide_Images/singleslot_curve.png

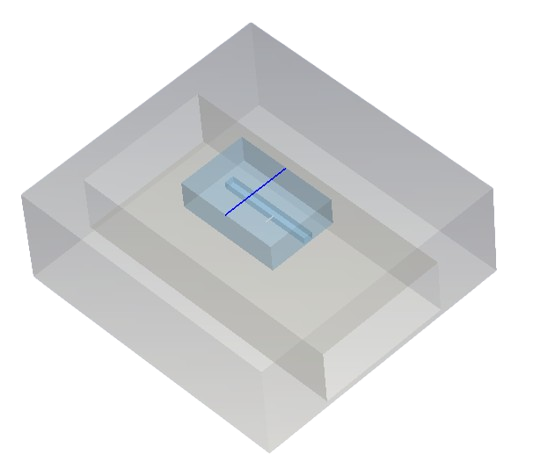
Waveguide_Images/singleslot_curve.png
