chabodmasere/EGH490-Research-Project/Waveguide_Images/singleslot_pec.png

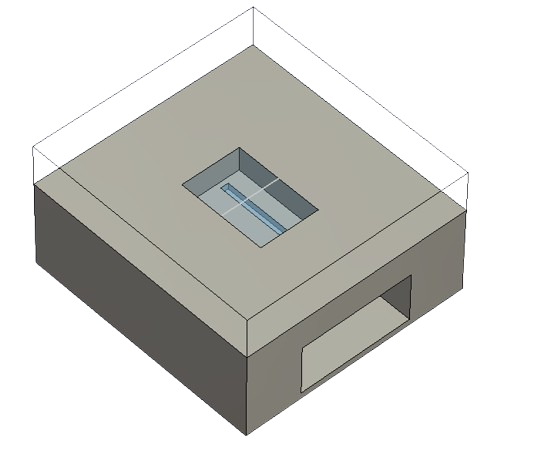
Waveguide_Images/singleslot_pec.png
