chabodmasere/EGH490-Research-Project/Waveguide_Images/singleslot_radface.png

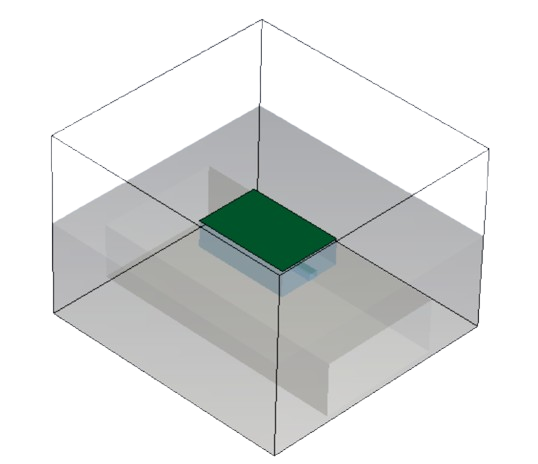
Waveguide_Images/singleslot_radface.png
