chabodmasere/EGH490-Research-Project/Waveguide_Images/waveguide1.PNG

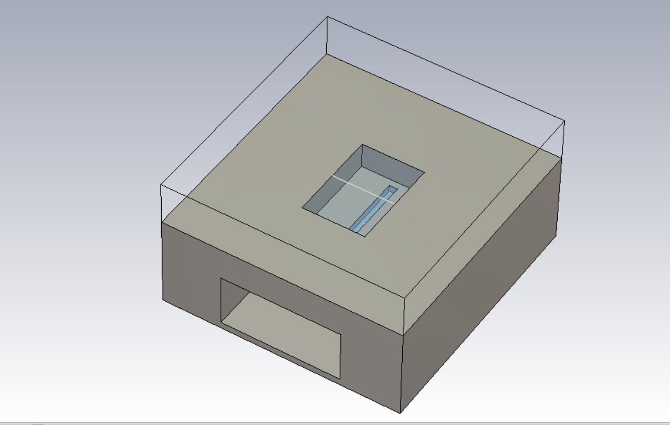
Waveguide_Images/waveguide1.PNG
