chabodmasere/EGH490-Research-Project/Waveguide_Images/waveguide2.PNG

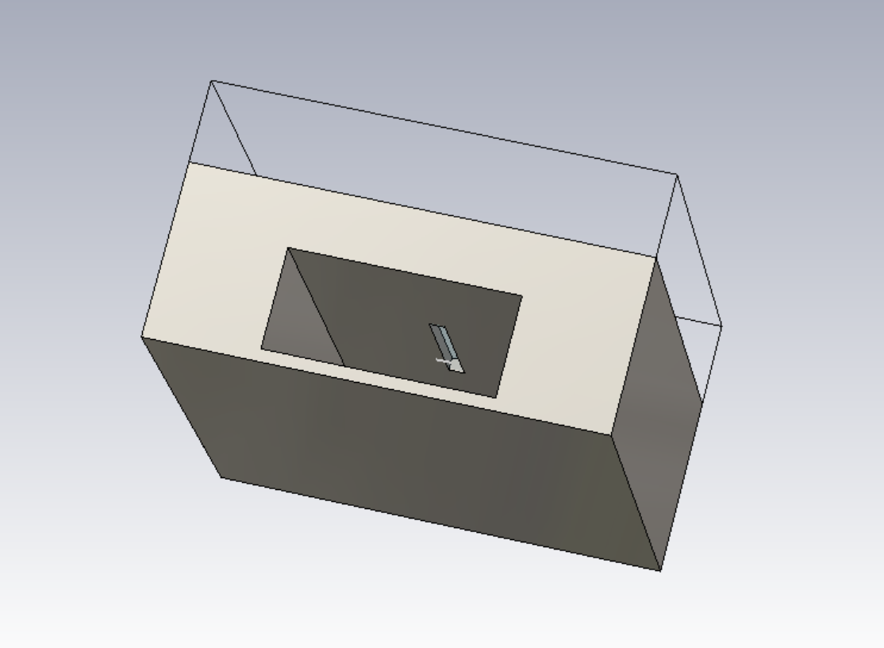
Waveguide_Images/waveguide2.PNG
