chabodmasere/EGH490-Research-Project/Waveguide_Images/waveguide3.PNG

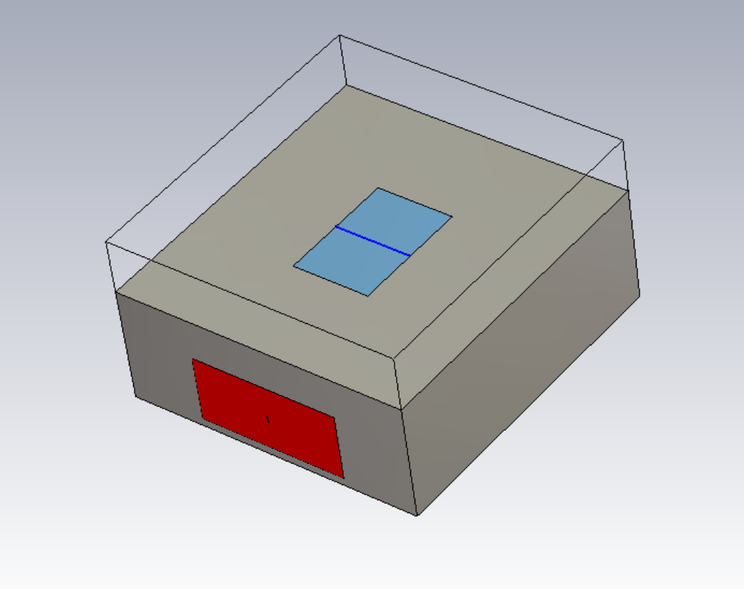
Waveguide_Images/waveguide3.PNG
