chabodmasere/EGH490-Research-Project/Waveguide_Images/waveguide4.PNG

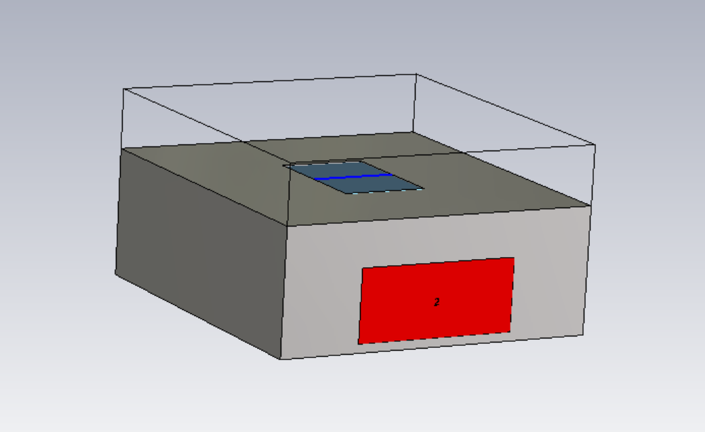
Waveguide_Images/waveguide4.PNG
