chabodmasere/EGH490-Research-Project/Waveguide_Images/waveguide5.PNG

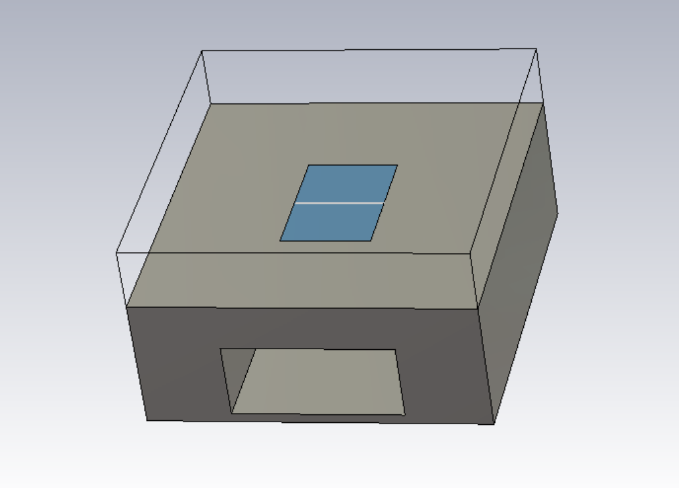
Waveguide_Images/waveguide5.PNG
