chabodmasere/EGH490-Research-Project/Waveguide_Images/waveguide.PNG

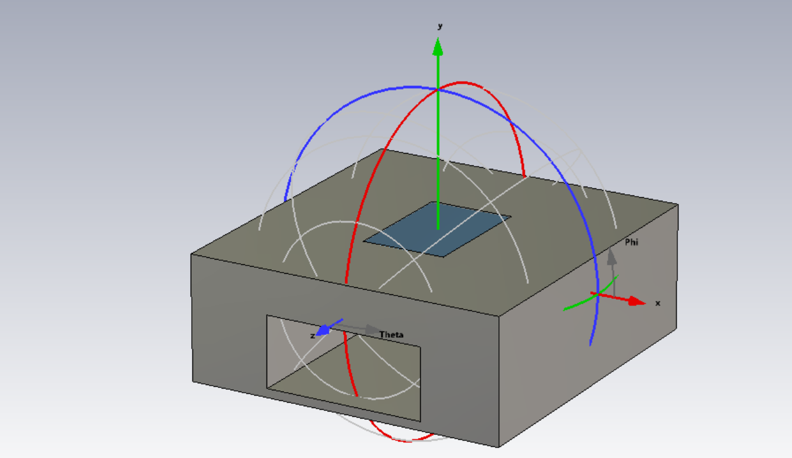
Waveguide_Images/waveguide.PNG
