chabodmasere/EGH490-Research-Project/Single Slot Analysis/result_navigator.csv

3D Run ID | Lcav | Xcav
1 | 15 | 1
2 | 15.2 | 1
3 | 15.4 | 1
4 | 15.6 | 1
5 | 15.8 | 1
6 | 16 | 1
7 | 16.2 | 1
8 | 16.4 | 1
9 | 16.6 | 1
10 | 16.8 | 1
11 | 17 | 1
12 | 15 | 1.25
13 | 15.2 | 1.25
14 | 15.4 | 1.25
15 | 15.6 | 1.25
16 | 15.8 | 1.25
17 | 16 | 1.25
18 | 16.2 | 1.25
19 | 16.4 | 1.25
20 | 16.6 | 1.25
21 | 16.8 | 1.25
22 | 17 | 1.25
23 | 15 | 1.5
24 | 15.2 | 1.5
25 | 15.4 | 1.5
26 | 15.6 | 1.5
27 | 15.8 | 1.5
28 | 16 | 1.5
29 | 16.2 | 1.5
30 | 16.4 | 1.5
31 | 16.6 | 1.5
32 | 16.8 | 1.5
33 | 17 | 1.5
34 | 15 | 1.75
35 | 15.2 | 1.75
36 | 15.4 | 1.75
37 | 15.6 | 1.75
38 | 15.8 | 1.75
39 | 16 | 1.75
40 | 16.2 | 1.75
41 | 16.4 | 1.75
42 | 16.6 | 1.75
43 | 16.8 | 1.75
44 | 17 | 1.75
45 | 15 | 2
46 | 15.2 | 2
47 | 15.4 | 2
48 | 15.6 | 2
49 | 15.8 | 2
50 | 16 | 2
51 | 16.2 | 2
52 | 16.4 | 2
53 | 16.6 | 2
54 | 16.8 | 2
55 | 17 | 2
56 | 15 | 2.25
57 | 15.2 | 2.25
58 | 15.4 | 2.25
59 | 15.6 | 2.25
60 | 15.8 | 2.25
61 | 16 | 2.25
62 | 16.2 | 2.25
63 | 16.4 | 2.25
64 | 16.6 | 2.25
65 | 16.8 | 2.25
66 | 17 | 2.25
67 | 15 | 2.5
68 | 15.2 | 2.5
69 | 15.4 | 2.5
70 | 15.6 | 2.5
71 | 15.8 | 2.5
72 | 16 | 2.5
73 | 16.2 | 2.5
74 | 16.4 | 2.5
75 | 16.6 | 2.5
76 | 16.8 | 2.5
77 | 17 | 2.5
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
