chabodmasere/EGH490-Research-Project/CST_Files/history_6by6_open_cav_faces.txt

Sub Main ()
Component.New "Chassis"
With Brick
     .Reset
     .Name "ChassisBody1"
     .Component "Chassis"
     .Material "PEC"
      .Xrange "-sides - d_m", "d_m*5 + sides + d_m"
     .Yrange "-b_m - b_b -b_c - 2*t -tbase", "-b_m - b_b -b_c - 2*t"
     .Zrange "-ends-d_b/2", "5*d_b + d_b/2 + ends"
     .Create
End With
With Brick
     .Reset
     .Name "ChassisBody2"
     .Component "Chassis"
     .Material "PEC"
      .Xrange "-sides - d_m", "d_m*5 + sides + d_m"
     .Yrange "-b_m - b_b -b_c - 2*t", "-b_b -b_c - t"
     .Zrange "-ends-d_b/2", "5*d_b + d_b/2 + ends"
     .Create
End With
With Brick
     .Reset
     .Name "ChassisBody3"
     .Component "Chassis"
     .Material "PEC"
      .Xrange "-sides - d_m", "d_m*5 + sides + d_m"
     .Yrange "-b_b -b_c - t", "-b_c"
     .Zrange "-ends-d_b/2", "5*d_b + d_b/2 + ends"
     .Create
End With
With Brick
     .Reset
     .Name "ChassisBody4"
     .Component "Chassis"
     .Material "PEC"
      .Xrange "-sides - d_m", "d_m*5 + sides + d_m"
     .Yrange "-b_c", "0"
     .Zrange "-ends-d_b/2", "5*d_b + d_b/2 + ends"
     .Create
End With
With Brick
     .Reset
     .Name "BranchCut1"
     .Component "Chassis"
     .Material "PEC"
      .Xrange "-a_b/2 + d_m*0", "a_b/2 + d_m*0"
     .Yrange "-b_c-b_b - t", "-b_c - t"
     .Zrange "-lam10_b/4", "5*d_b + lam10_b/4"
     .Create
End With
Solid.Subtract "Chassis:ChassisBody3","Chassis:BranchCut1"
With Brick
     .Reset
     .Name "BranchCut2"
     .Component "Chassis"
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
     .Version 10
     .Name "LineCav6_6"
     .Curve "CurveCav6_6"
     .Point "Xcav6_6 - w/2 + d_m*5", "-b_c", "d_b*5"
     .Point "Xcav6_6 + w/2 + d_m*5", "-b_c", "d_b*5"
     .Create
End With
With Polygon3D
     .Reset
     .Version 10
     .Name "LineRad6_1"
     .Curve "CurveRad6_1"
     .Point "- a_c/2 + d_m*5", "0", "d_b*0"
     .Point "a_c/2 + d_m*5", "0", "d_b*0"
     .Create
End With
With Polygon3D
     .Reset
     .Version 10
     .Name "LineRad6_2"
     .Curve "CurveRad6_2"
     .Point "- a_c/2 + d_m*5", "0", "d_b*1"
     .Point "a_c/2 + d_m*5", "0", "d_b*1"
     .Create
End With
With Polygon3D
     .Reset
     .Version 10
     .Name "LineRad6_3"
     .Curve "CurveRad6_3"
     .Point "- a_c/2 + d_m*5", "0", "d_b*2"
     .Point "a_c/2 + d_m*5", "0", "d_b*2"
     .Create
End With
With Polygon3D
     .Reset
     .Version 10
     .Name "LineRad6_4"
     .Curve "CurveRad6_4"
     .Point "- a_c/2 + d_m*5", "0", "d_b*3"
     .Point "a_c/2 + d_m*5", "0", "d_b*3"
     .Create
End With
With Polygon3D
     .Reset
     .Version 10
     .Name "LineRad6_5"
     .Curve "CurveRad6_5"
     .Point "- a_c/2 + d_m*5", "0", "d_b*4"
     .Point "a_c/2 + d_m*5", "0", "d_b*4"
     .Create
End With
With Polygon3D
     .Reset
     .Version 10
     .Name "LineRad6_6"
     .Curve "CurveRad6_6"
     .Point "- a_c/2 + d_m*5", "0", "d_b*5"
     .Point "a_c/2 + d_m*5", "0", "d_b*5"
     .Create
End With
With Brick
     .Reset
     .Name "MainLineCut"
     .Component "Chassis"
     .Material "PEC"
     .Xrange "-sides - d_m", "d_m*5 + lam10_m/2"
     .Yrange "-b_c-b_b-b_m-2*t", "-b_c-b_b-2*t"
     .Zrange "-d_b/2+d_b*3-a_m/2", "-d_b/2+d_b*3+a_m/2"
     .Create
End With
Solid.Subtract "Chassis:ChassisBody2","Chassis:MainLineCut"
WCS.ActivateWCS "global"
With Brick
     .Reset
     .Name "CoupSlotCut1"
     .Component "Chassis"
     .Material "PEC"
     .Xrange "d_m*0-L1/2", "d_m*0+L1/2"
     .Yrange "-b_c-b_b-2*t", "-b_c-b_b-t"
     .Zrange "-d_b/2+d_b*3-w/2", "-d_b/2+d_b*3+w/2"
     .Create
End With
Pick.PickCenterpointFromId "Chassis:CoupSlotCut1", "5"
WCS.AlignWCSWithGlobalCoordinates 
WCS.AlignWCSWithSelected "Point"
With Transform
     .Reset
     .Name "Chassis:CoupSlotCut1"
      .Origin "Free"
       .Center "0", "0", "0"
     .Angle "0", "-theta1", "0"
      .MultipleObjects "False"
      .GroupObjects "False"
      .Repetitions "1"
      .MultipleSelection "False"
      .Transform "Shape", "Rotate"
End With
Solid.Subtract "Chassis:ChassisBody2","Chassis:CoupSlotCut1"
Pick.ClearAllPicks
WCS.ActivateWCS "global"
With Brick
     .Reset
     .Name "CoupSlot1"
     .Component "Chassis"
     .Material "Vacuum"
     .Xrange "d_m*0-L1/2", "d_m*0+L1/2"
     .Yrange "-b_c-b_b-2*t", "-b_c-b_b-t"
     .Zrange "-d_b/2+d_b*3-w/2", "-d_b/2+d_b*3+w/2"
     .Create
End With
Pick.PickCenterpointFromId "Chassis:CoupSlot1", "5"
WCS.AlignWCSWithGlobalCoordinates 
WCS.AlignWCSWithSelected "Point"
With Transform
     .Reset
     .Name "Chassis:CoupSlot1"
      .Origin "Free"
       .Center "0", "0", "0"
     .Angle "0", "-theta1", "0"
      .MultipleObjects "False"
      .GroupObjects "False"
      .Repetitions "1"
      .MultipleSelection "False"
      .Transform "Shape", "Rotate"
End With
Pick.ClearAllPicks
WCS.ActivateWCS "global"
WCS.ActivateWCS "global"
With Brick
     .Reset
     .Name "CoupSlotCut2"
     .Component "Chassis"
     .Material "PEC"
     .Xrange "d_m*1-L2/2", "d_m*1+L2/2"
     .Yrange "-b_c-b_b-2*t", "-b_c-b_b-t"
     .Zrange "-d_b/2+d_b*3-w/2", "-d_b/2+d_b*3+w/2"
     .Create
End With
Pick.PickCenterpointFromId "Chassis:CoupSlotCut2", "5"
WCS.AlignWCSWithGlobalCoordinates 
WCS.AlignWCSWithSelected "Point"
With Transform
     .Reset
     .Name "Chassis:CoupSlotCut2"
      .Origin "Free"
       .Center "0", "0", "0"
     .Angle "0", "-theta2", "0"
      .MultipleObjects "False"
      .GroupObjects "False"
      .Repetitions "1"
      .MultipleSelection "False"
      .Transform "Shape", "Rotate"
End With
Solid.Subtract "Chassis:ChassisBody2","Chassis:CoupSlotCut2"
Pick.ClearAllPicks
WCS.ActivateWCS "global"
With Brick
     .Reset
     .Name "CoupSlot2"
     .Component "Chassis"
     .Material "Vacuum"
     .Xrange "d_m*1-L2/2", "d_m*1+L2/2"
     .Yrange "-b_c-b_b-2*t", "-b_c-b_b-t"
     .Zrange "-d_b/2+d_b*3-w/2", "-d_b/2+d_b*3+w/2"
     .Create
End With
Pick.PickCenterpointFromId "Chassis:CoupSlot2", "5"
WCS.AlignWCSWithGlobalCoordinates 
WCS.AlignWCSWithSelected "Point"
With Transform
     .Reset
     .Name "Chassis:CoupSlot2"
      .Origin "Free"
       .Center "0", "0", "0"
     .Angle "0", "-theta2", "0"
      .MultipleObjects "False"
      .GroupObjects "False"
      .Repetitions "1"
      .MultipleSelection "False"
      .Transform "Shape", "Rotate"
End With
Pick.ClearAllPicks
WCS.ActivateWCS "global"
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
WCS.AlignWCSWithSelected "Point"
With Transform
     .Reset
     .Name "Chassis:CoupSlot5"
      .Origin "Free"
       .Center "0", "0", "0"
     .Angle "0", "-theta5", "0"
      .MultipleObjects "False"
      .GroupObjects "False"
      .Repetitions "1"
      .MultipleSelection "False"
      .Transform "Shape", "Rotate"
End With
Pick.ClearAllPicks
WCS.ActivateWCS "global"
WCS.ActivateWCS "global"
With Brick
     .Reset
     .Name "CoupSlotCut6"
     .Component "Chassis"
     .Material "PEC"
     .Xrange "d_m*5-L6/2", "d_m*5+L6/2"
     .Yrange "-b_c-b_b-2*t", "-b_c-b_b-t"
     .Zrange "-d_b/2+d_b*3-w/2", "-d_b/2+d_b*3+w/2"
     .Create
End With
Pick.PickCenterpointFromId "Chassis:CoupSlotCut6", "5"
WCS.AlignWCSWithGlobalCoordinates 
WCS.AlignWCSWithSelected "Point"
With Transform
     .Reset
     .Name "Chassis:CoupSlotCut6"
      .Origin "Free"
       .Center "0", "0", "0"
     .Angle "0", "-theta6", "0"
      .MultipleObjects "False"
      .GroupObjects "False"
      .Repetitions "1"
      .MultipleSelection "False"
      .Transform "Shape", "Rotate"
End With
Solid.Subtract "Chassis:ChassisBody2","Chassis:CoupSlotCut6"
Pick.ClearAllPicks
WCS.ActivateWCS "global"
With Brick
     .Reset
     .Name "CoupSlot6"
     .Component "Chassis"
     .Material "Vacuum"
     .Xrange "d_m*5-L6/2", "d_m*5+L6/2"
     .Yrange "-b_c-b_b-2*t", "-b_c-b_b-t"
     .Zrange "-d_b/2+d_b*3-w/2", "-d_b/2+d_b*3+w/2"
     .Create
End With
Pick.PickCenterpointFromId "Chassis:CoupSlot6", "5"
WCS.AlignWCSWithGlobalCoordinates 
WCS.AlignWCSWithSelected "Point"
With Transform
     .Reset
     .Name "Chassis:CoupSlot6"
      .Origin "Free"
       .Center "0", "0", "0"
     .Angle "0", "-theta6", "0"
      .MultipleObjects "False"
      .GroupObjects "False"
      .Repetitions "1"
      .MultipleSelection "False"
      .Transform "Shape", "Rotate"
End With
Pick.ClearAllPicks
WCS.ActivateWCS "global"
Pick.PickCenterpointFromId "Chassis:CoupSlot1", "5"
WCS.AlignWCSWithGlobalCoordinates 
WCS.AlignWCSWithSelected "Point"
WCS.RotateWCS "v", "-theta1"
With Polygon3D
     .Reset
     .Version 10
     .Name "Cline1"
     .Curve "CCurve1"
     .Point "0", "0", "-w/2"
     .Point "0", "0", "w/2"
     .Create
End With
WCS.ActivateWCS "global"
Pick.ClearAllPicks
Pick.PickCenterpointFromId "Chassis:CoupSlot2", "5"
WCS.AlignWCSWithGlobalCoordinates 
WCS.AlignWCSWithSelected "Point"
WCS.RotateWCS "v", "-theta2"
With Polygon3D
     .Reset
     .Version 10
     .Name "Cline2"
     .Curve "CCurve2"
     .Point "0", "0", "-w/2"
     .Point "0", "0", "w/2"
     .Create
End With
WCS.ActivateWCS "global"
Pick.ClearAllPicks
Pick.PickCenterpointFromId "Chassis:CoupSlot3", "5"
WCS.AlignWCSWithGlobalCoordinates 
WCS.AlignWCSWithSelected "Point"
WCS.RotateWCS "v", "-theta3"
With Polygon3D
     .Reset
     .Version 10
     .Name "Cline3"
     .Curve "CCurve3"
     .Point "0", "0", "-w/2"
     .Point "0", "0", "w/2"
     .Create
End With
WCS.ActivateWCS "global"
Pick.ClearAllPicks
Pick.PickCenterpointFromId "Chassis:CoupSlot4", "5"
WCS.AlignWCSWithGlobalCoordinates 
WCS.AlignWCSWithSelected "Point"
WCS.RotateWCS "v", "-theta4"
With Polygon3D
     .Reset
     .Version 10
     .Name "Cline4"
     .Curve "CCurve4"
     .Point "0", "0", "-w/2"
     .Point "0", "0", "w/2"
     .Create
End With
WCS.ActivateWCS "global"
Pick.ClearAllPicks
Pick.PickCenterpointFromId "Chassis:CoupSlot5", "5"
WCS.AlignWCSWithGlobalCoordinates 
WCS.AlignWCSWithSelected "Point"
WCS.RotateWCS "v", "-theta5"
With Polygon3D
     .Reset
     .Version 10
     .Name "Cline5"
     .Curve "CCurve5"
     .Point "0", "0", "-w/2"
     .Point "0", "0", "w/2"
     .Create
End With
WCS.ActivateWCS "global"
Pick.ClearAllPicks
Pick.PickCenterpointFromId "Chassis:CoupSlot6", "5"
WCS.AlignWCSWithGlobalCoordinates 
WCS.AlignWCSWithSelected "Point"
WCS.RotateWCS "v", "-theta6"
With Polygon3D
     .Reset
     .Version 10
     .Name "Cline6"
     .Curve "CCurve6"
     .Point "0", "0", "-w/2"
     .Point "0", "0", "w/2"
     .Create
End With
WCS.ActivateWCS "global"
Pick.ClearAllPicks
End Sub
