chabodmasere/EGH490-Research-Project/(list of files, drawings)

Other design files:
Single Slot Analysis/RadiatingSlotOpenCavity(DATABASES)/Model/3D/Model.dsn
